ChrisPVille/quokka/README.md

# quokka
Quokka 6502 Microprocessor Trainer

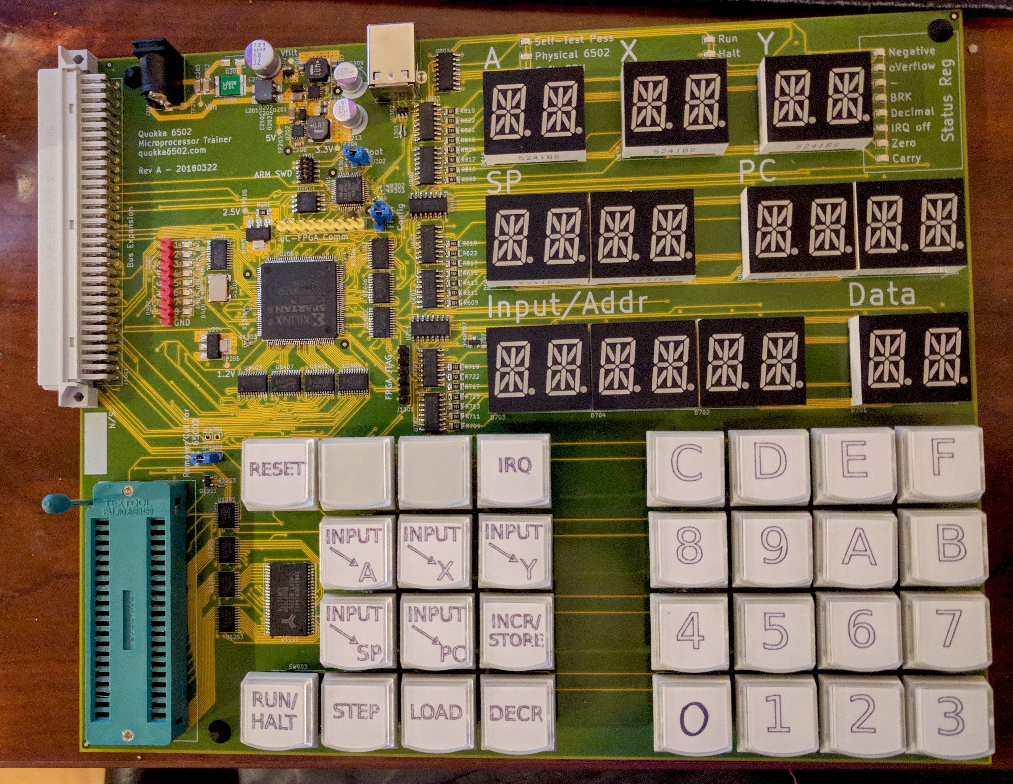
[picture p1: board.jpg]
Board Image
