ChrisPVille/quokka/board/quokka.pdf

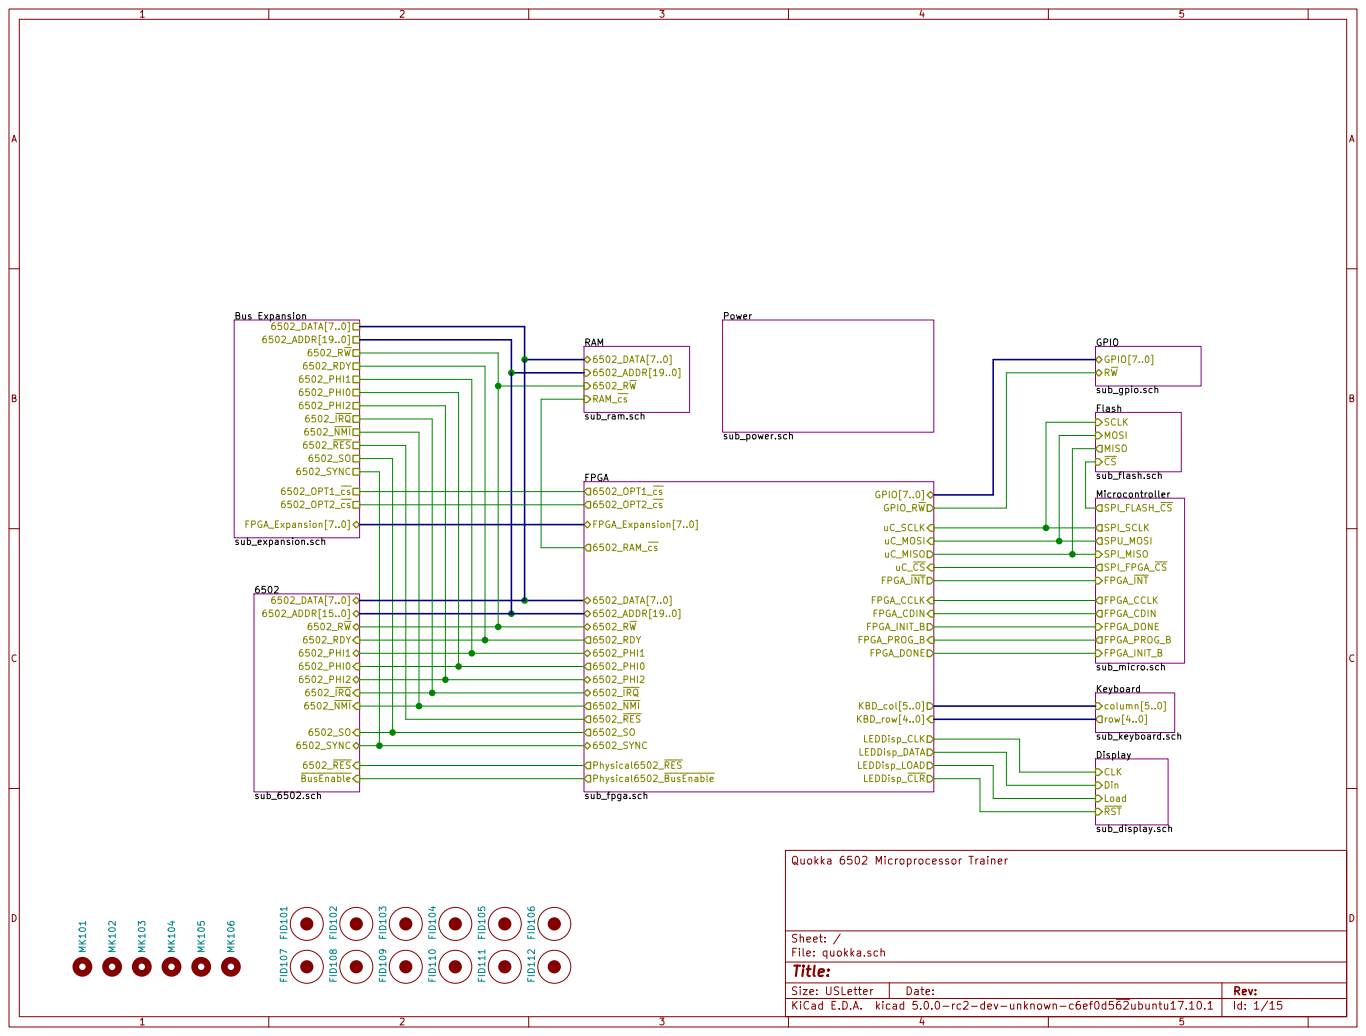
[picture p2: page 1]

Flash
sub_flash.sch SCLK MOSI MISO

File: quokka.sch Sheet: / Quokka 6502 Microprocessor Trainer

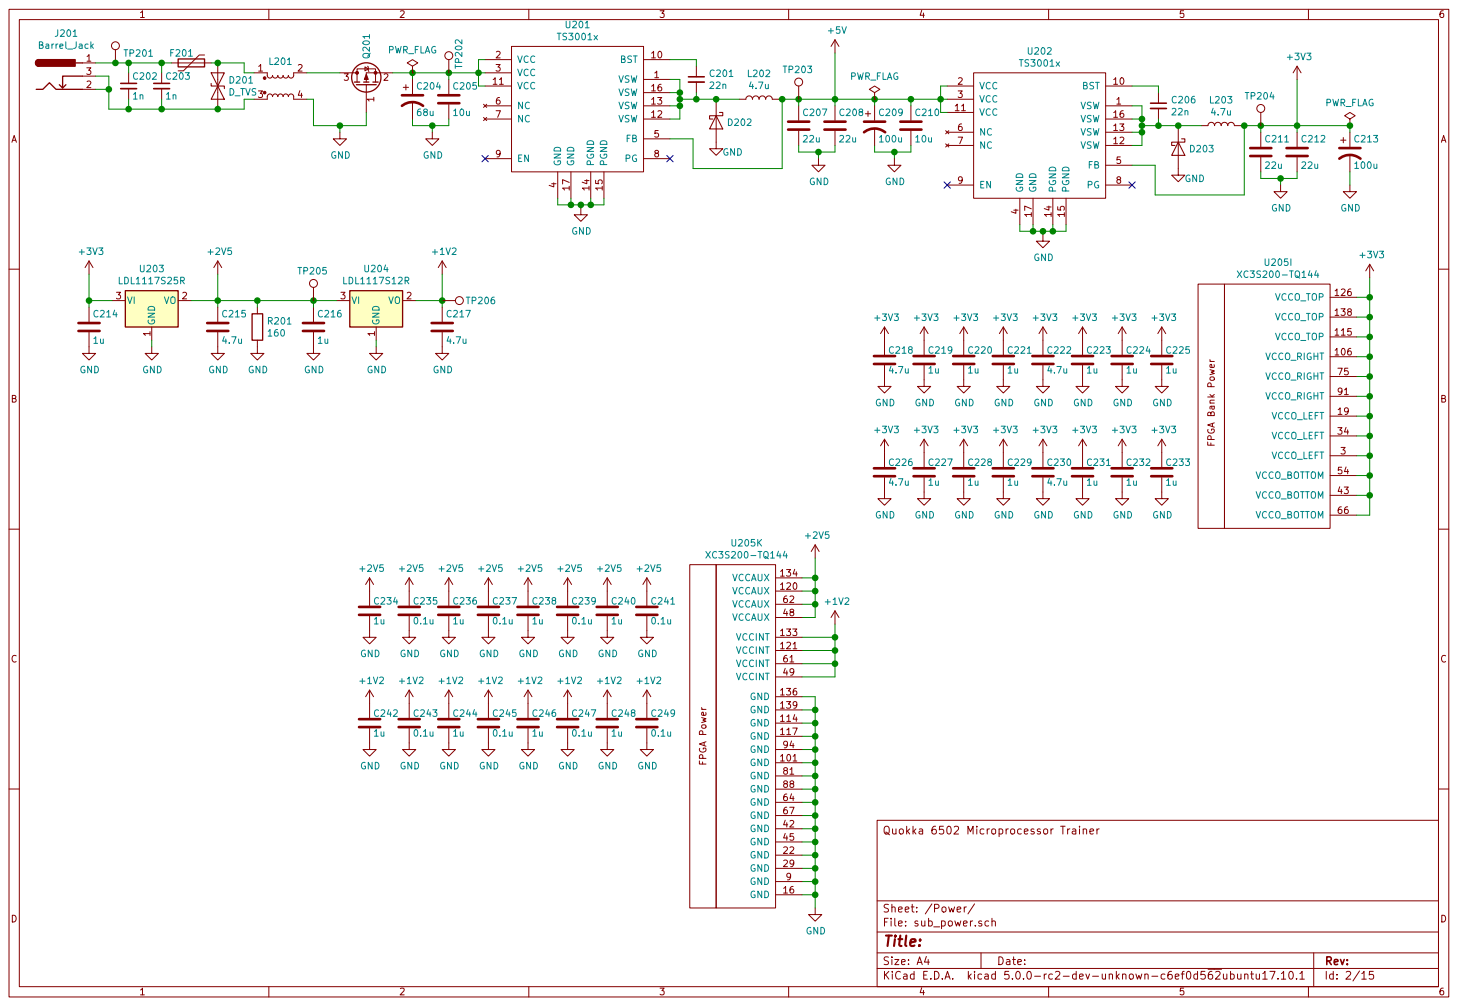
[picture p3: page 2]

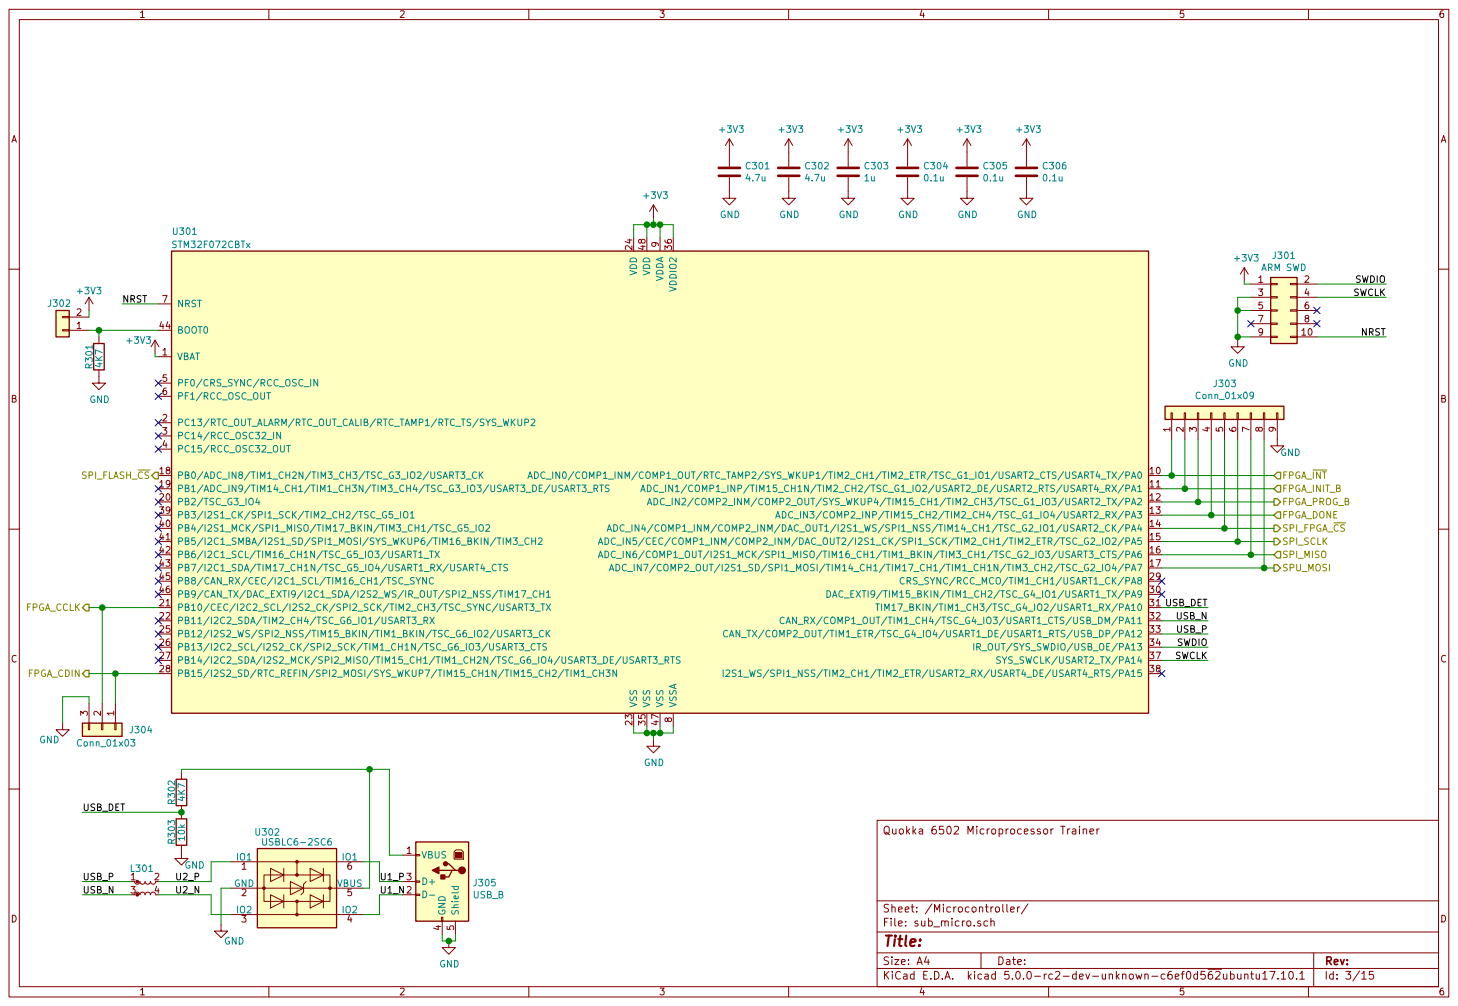
[picture p4: page 3]

9 VDDIO2 36 VSS 23 VSS 35 VSS 47 VSSA

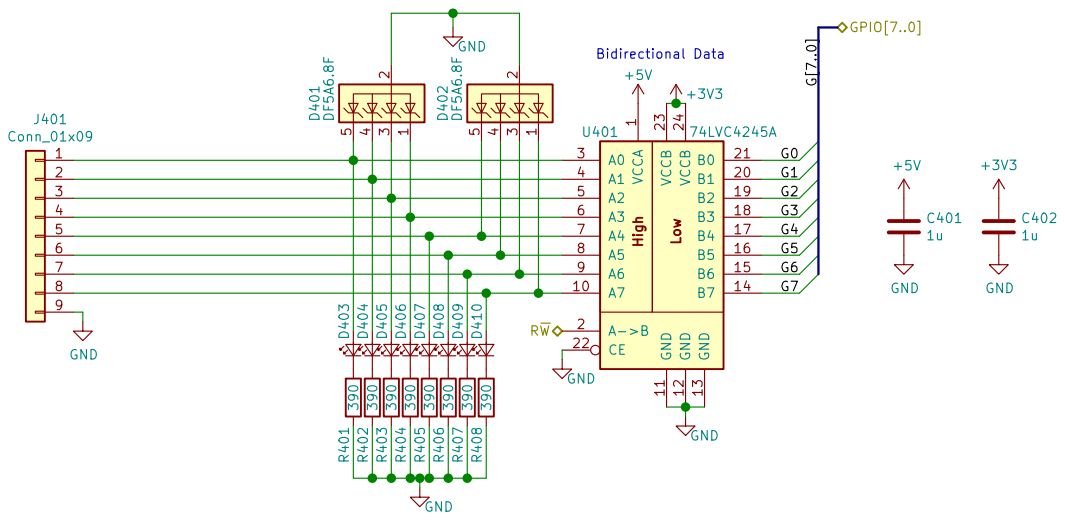
[picture p5: page 4]

1 A7 10 GND 11 GND 12 GND 13 B7 14 B6 15 B5 16 B4 17 B3 18 B2 19 A->B 2 B1 20 B0 21 CE 22 VCCB 23 VCCB 24 A0 3 A1 4 A2 5 A3 6 A4 7 A5 8 A6 9U401 74LVC4245A

File: sub_gpio.sch Sheet: /GPIO/ Quokka 6502 Microprocessor Trainer RW

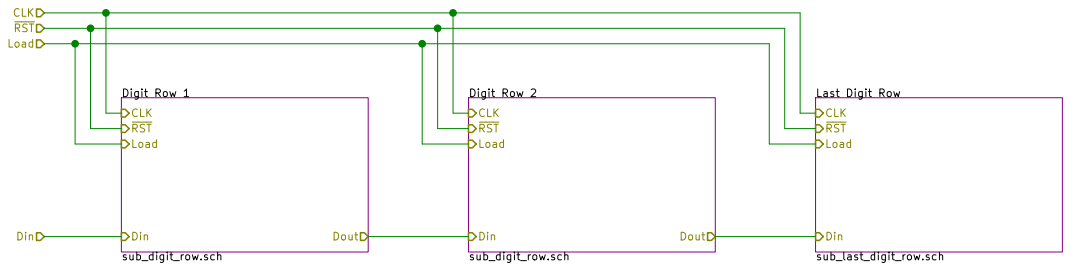
[picture p6: page 5]

Last Digit Row
sub_last_digit_row.sch Din CLK RST

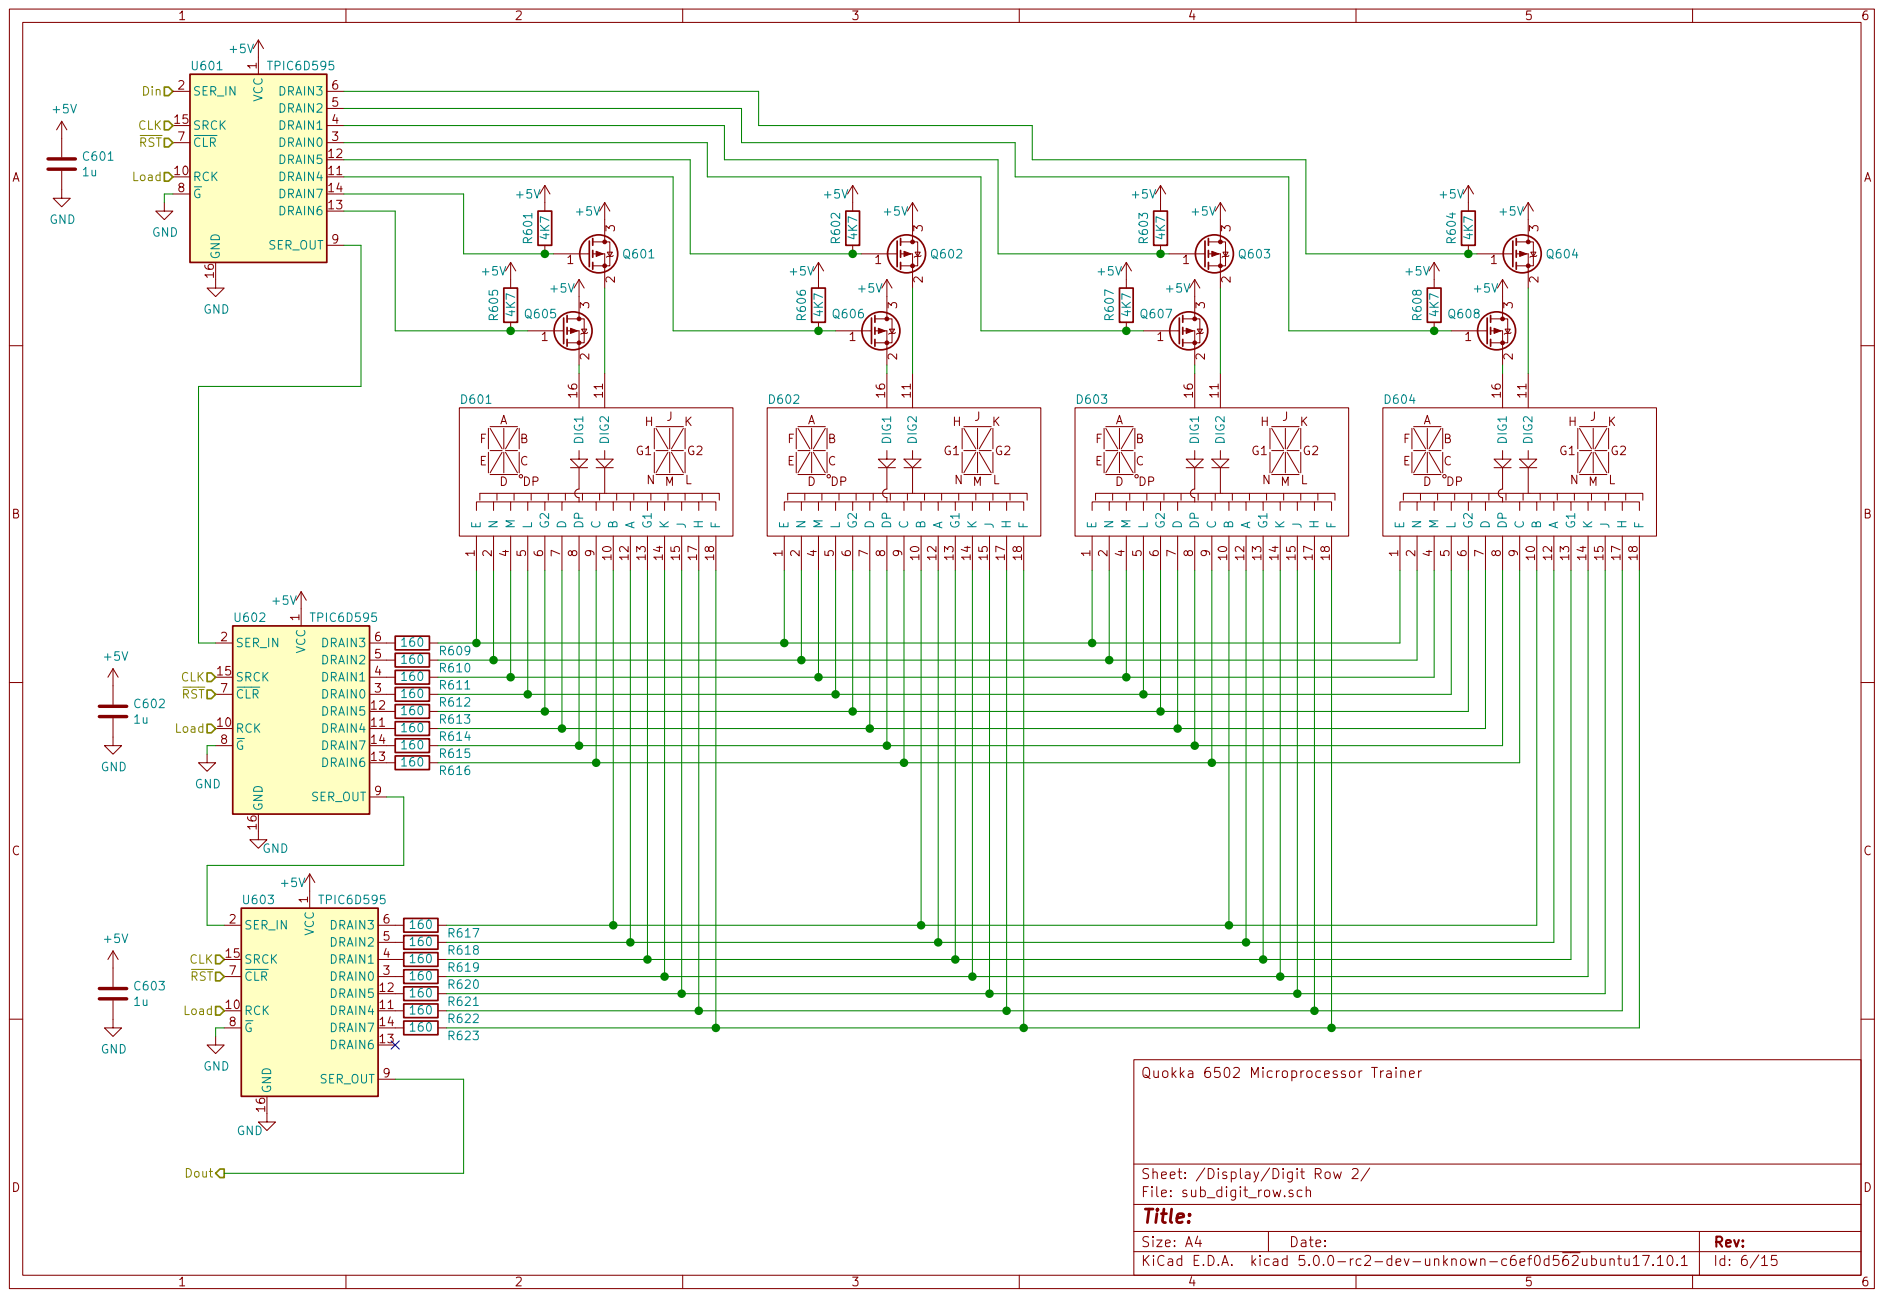
[picture p7: page 6]

1 RCK 10 DRAIN4 11 DRAIN5 12 DRAIN6 13 DRAIN7 14 SRCK 15 GND 16 SER_IN 2 DRAIN0 3 DRAIN1 4 DRAIN2 5 DRAIN3 6 CLR 7 G

Sheet: /Display/Digit Row 2/
File: sub_digit_row.sch
Id: 6/15 Title:

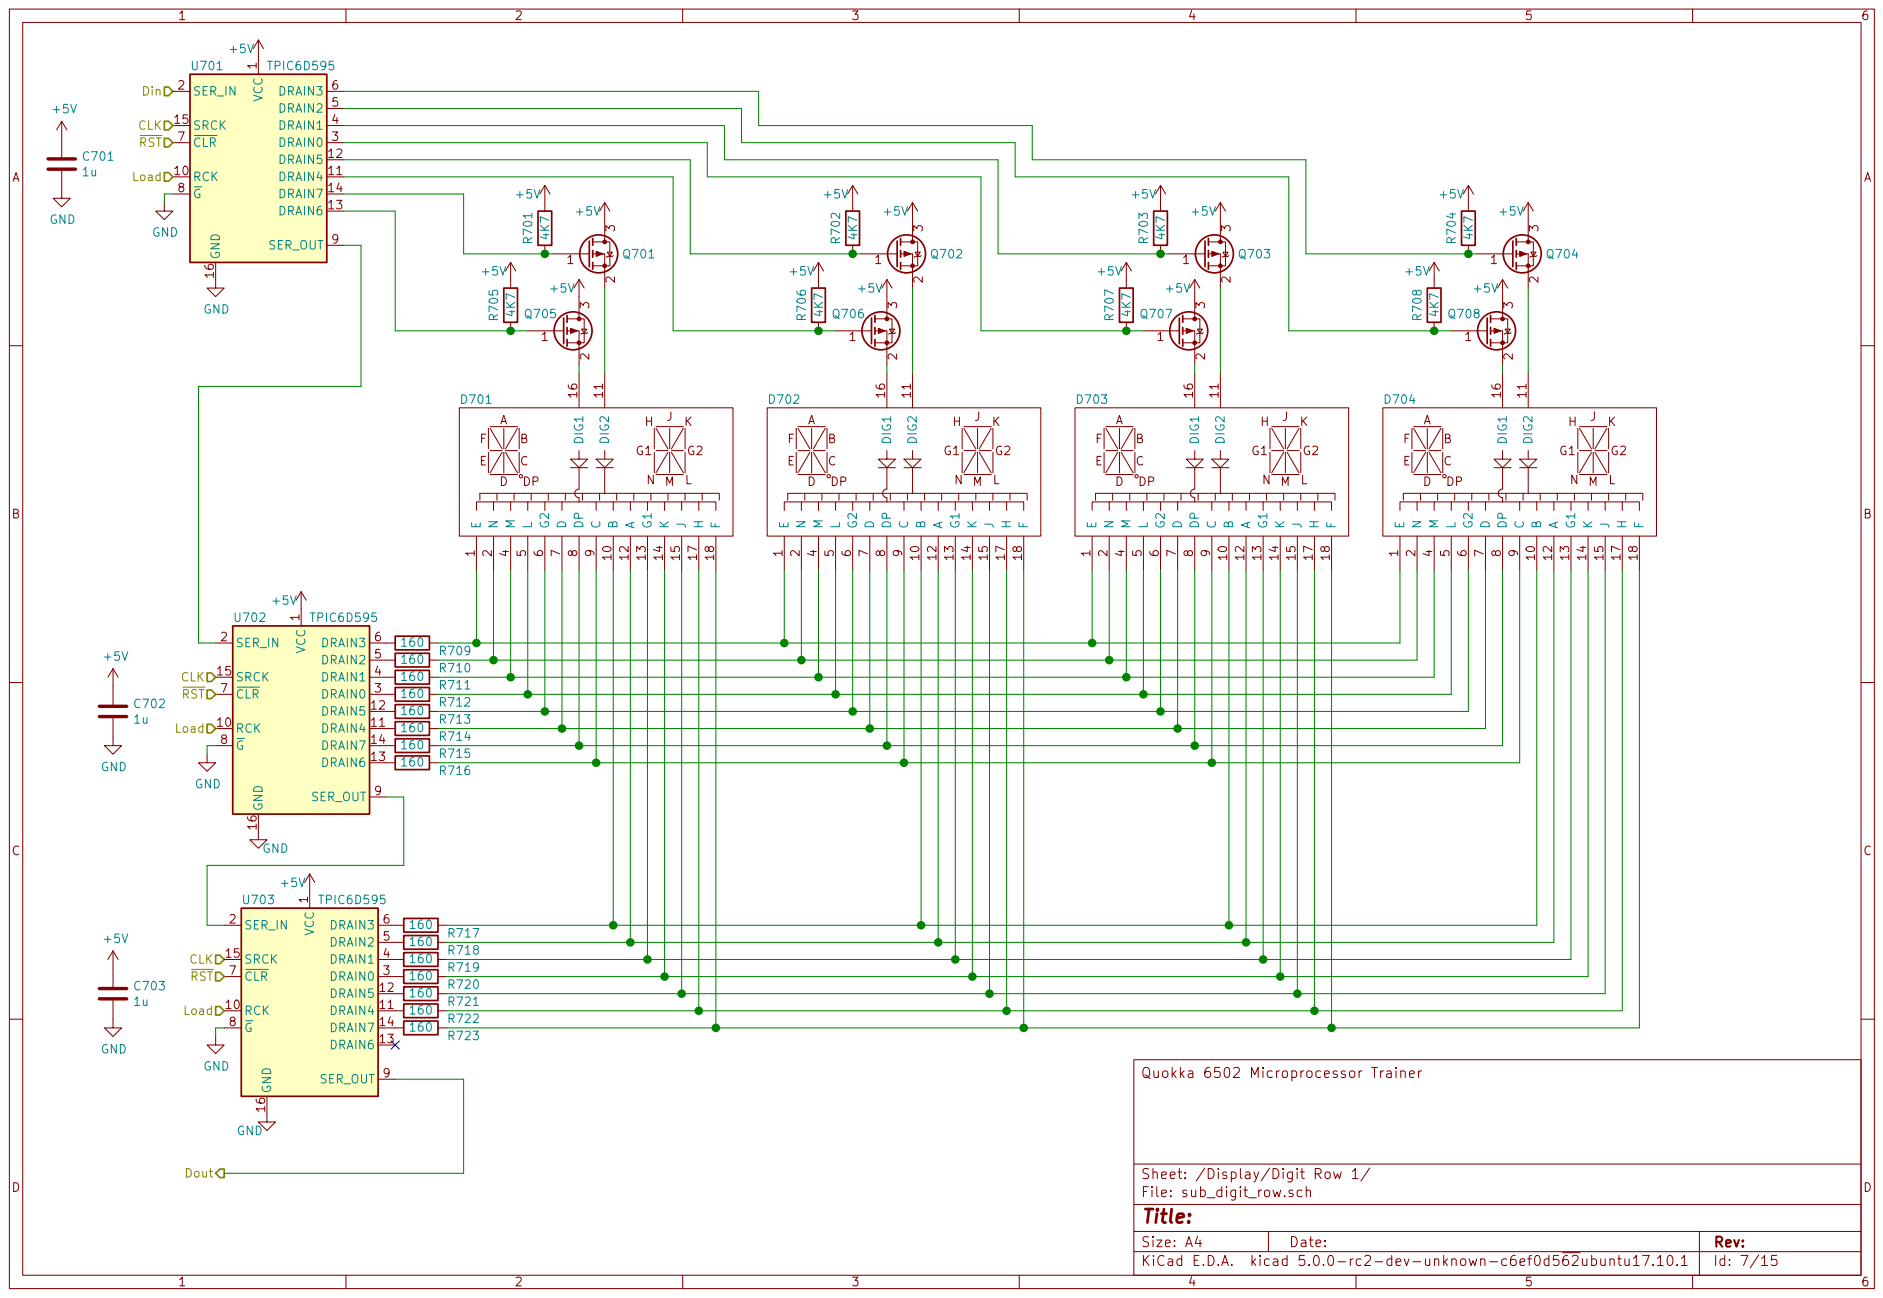
[picture p8: page 7]
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

Sheet: /Display/Digit Row 1/
File: sub_digit_row.sch
Id: 7/15 Title:

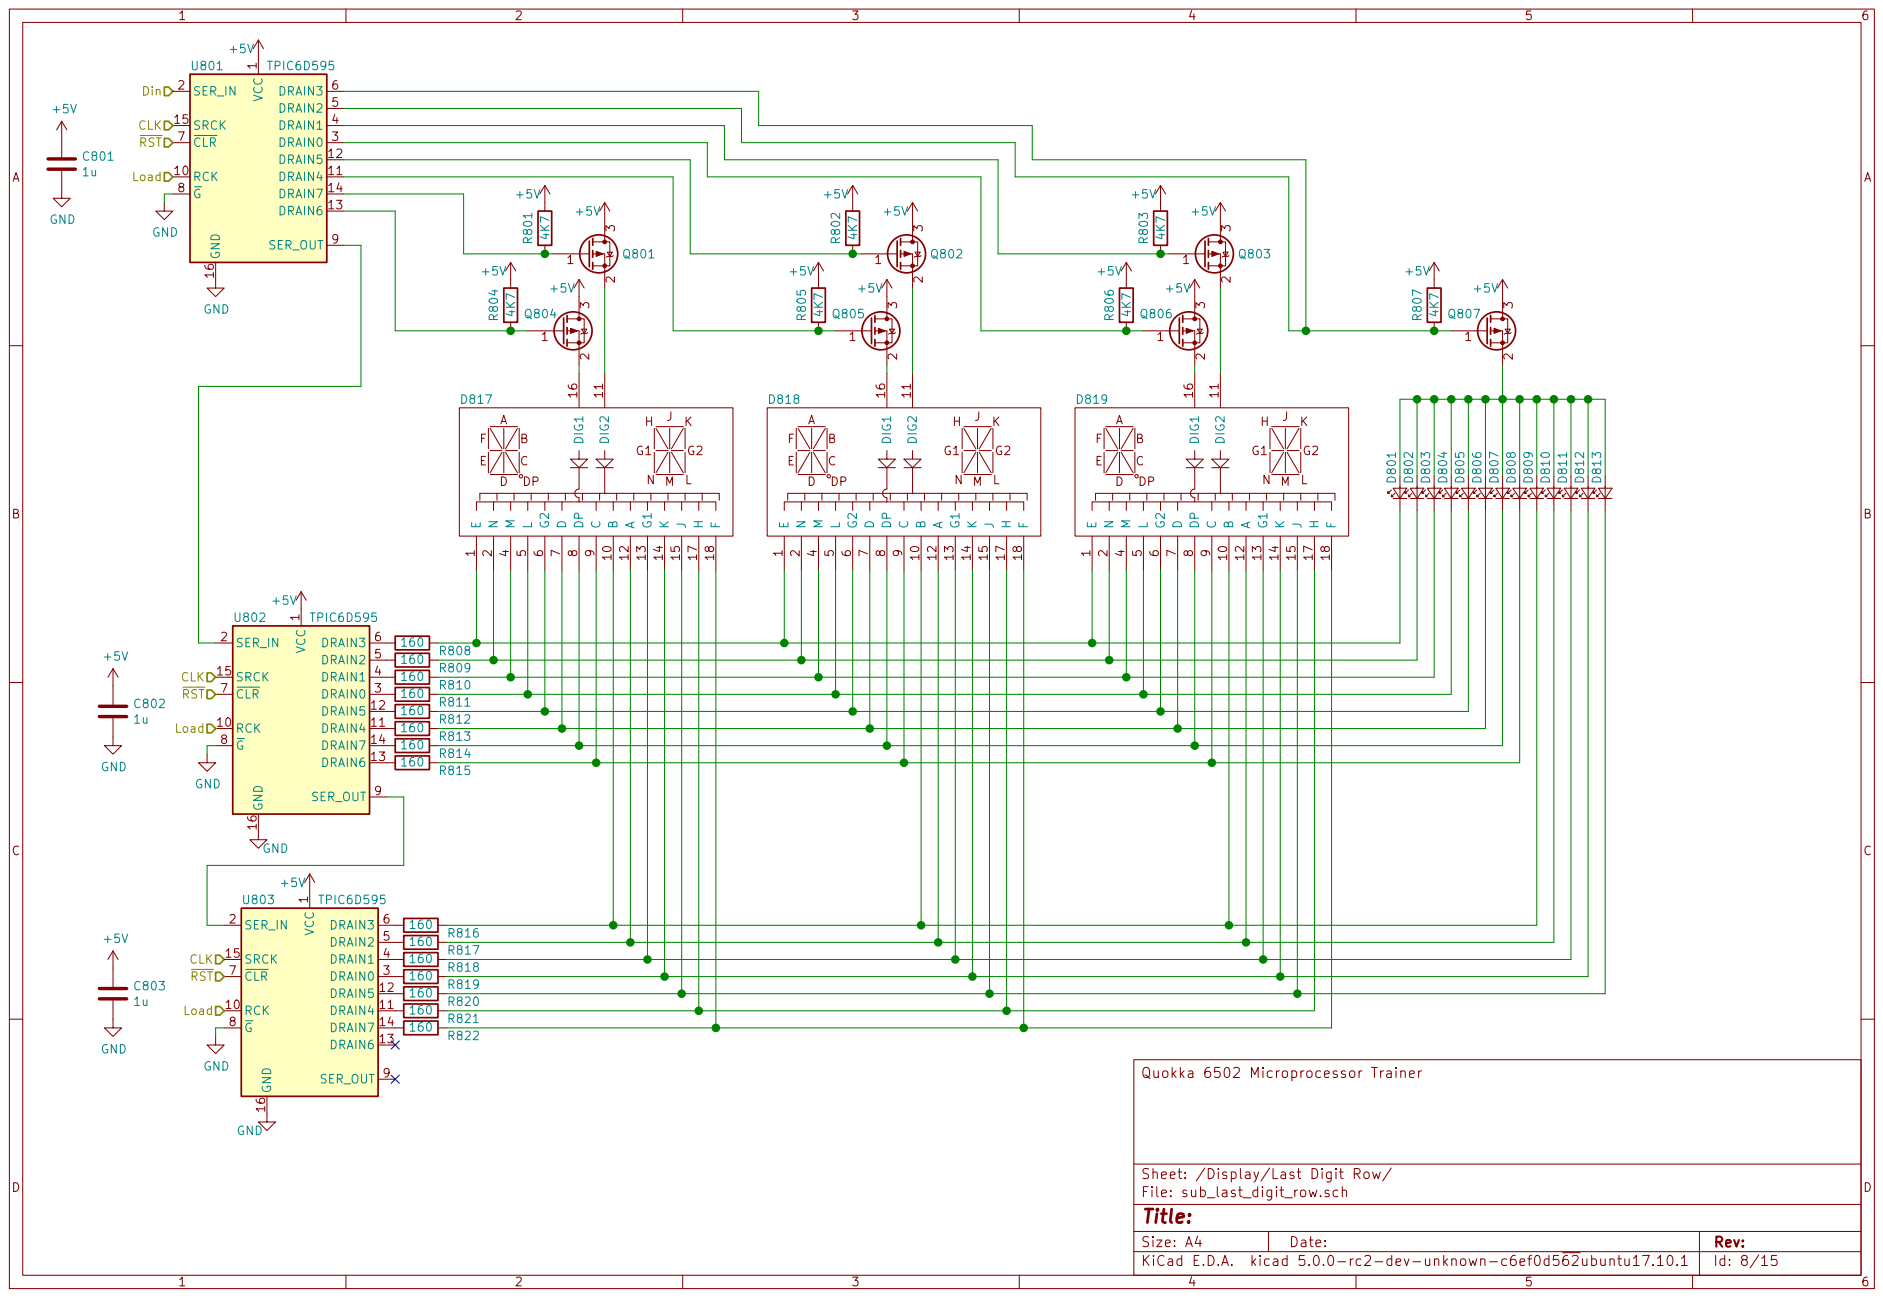
[picture p9: page 8]
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

Sheet: /Display/Last Digit Row/
File: sub_last_digit_row.sch
Id: 8/15 Title:

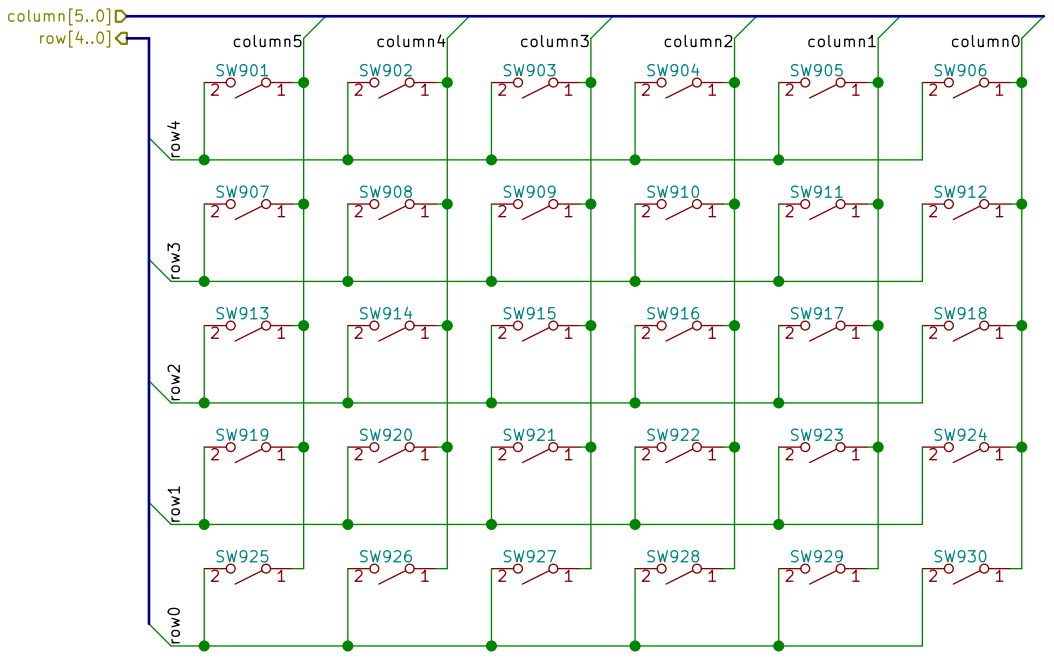
[picture p10: page 9]

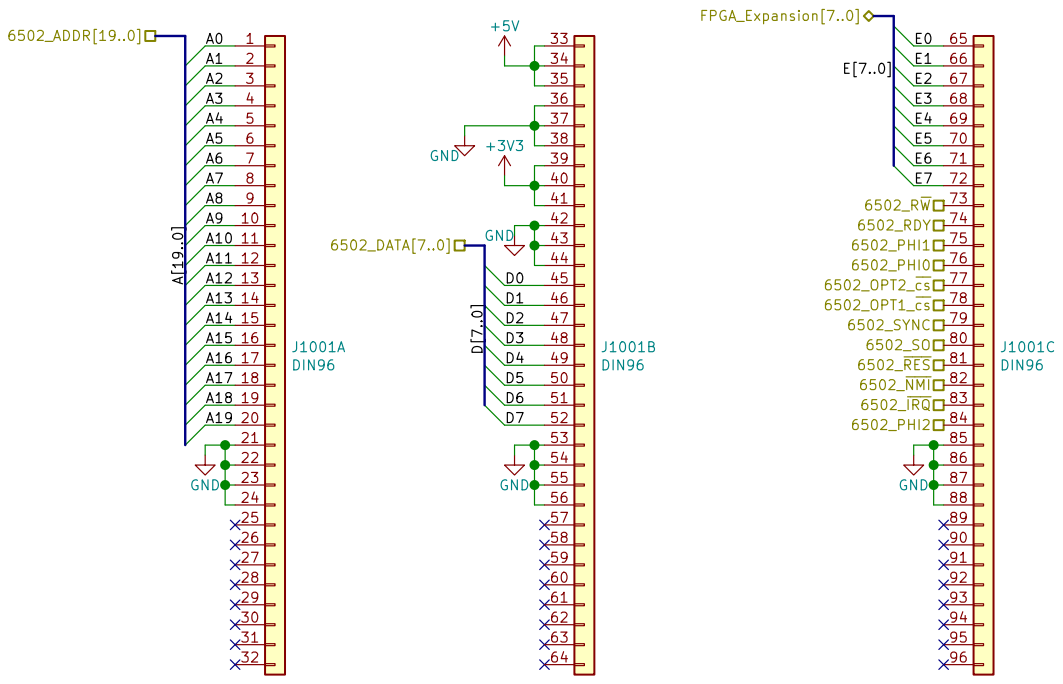
[picture p11: page 10]

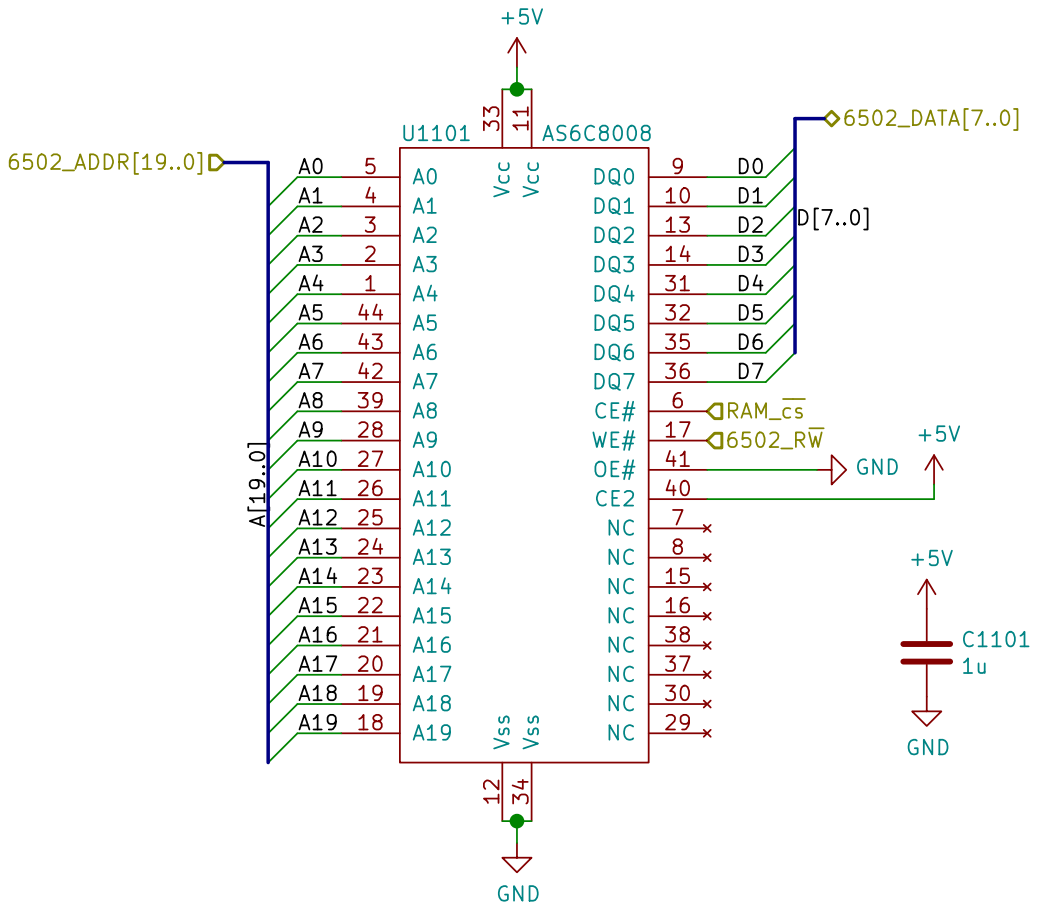
[picture p12: page 11]

File: sub_ram.sch Sheet: /RAM/ Quokka 6502 Microprocessor Trainer

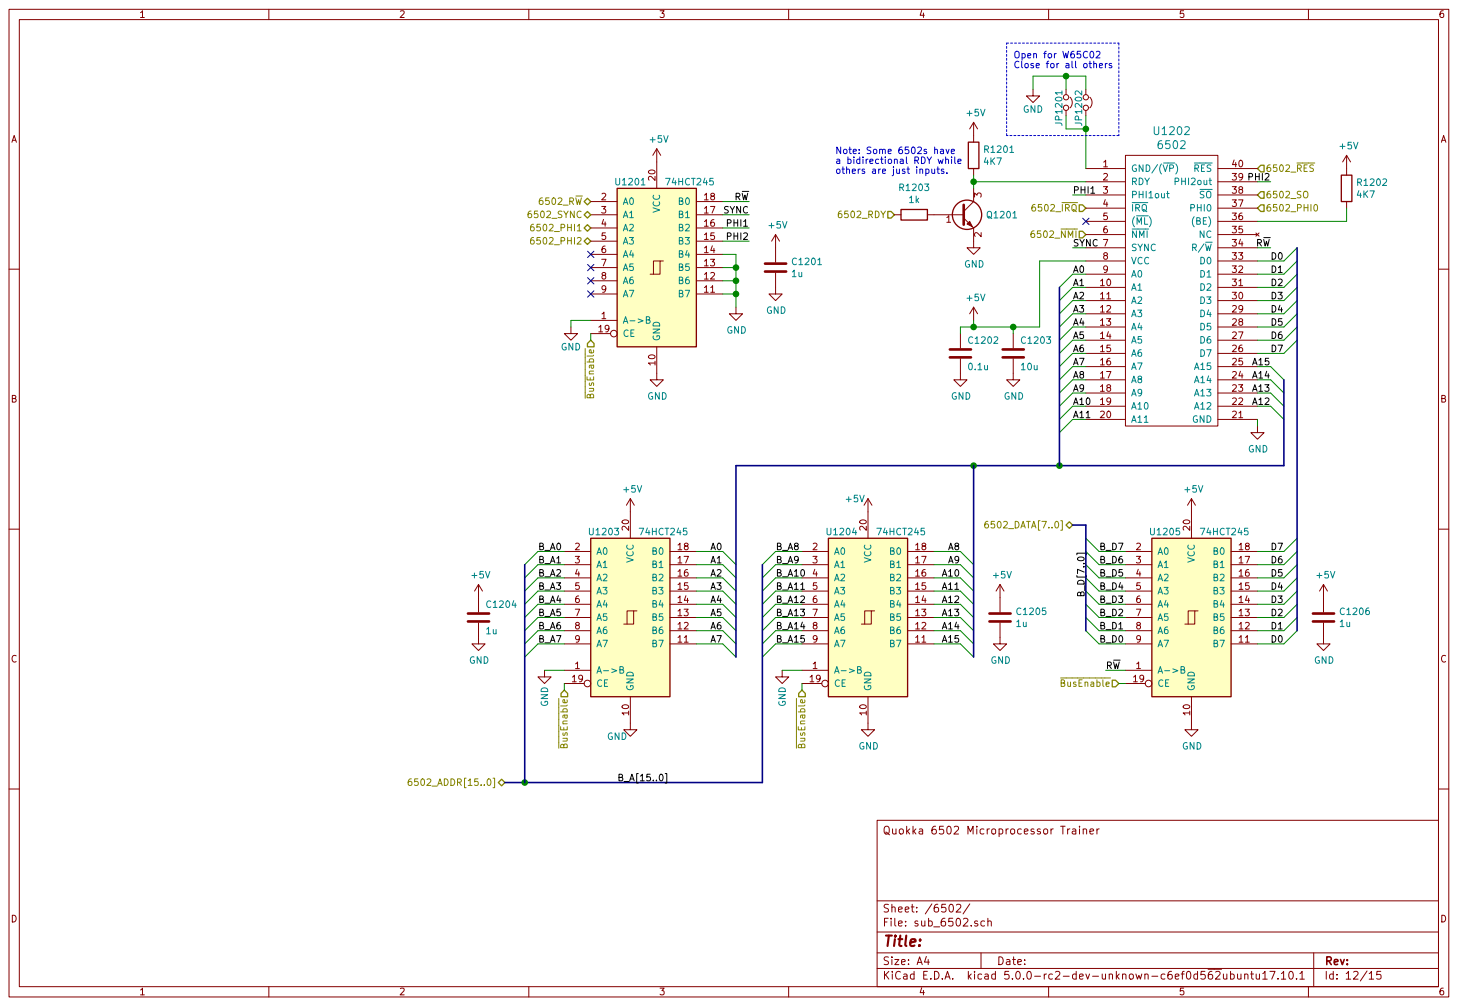
[picture p13: page 12]

4K7 Open for W65C02 Close for all others Note: Some 6502s have
4K7 GND

File: sub_6502.sch Sheet: /6502/ Quokka 6502 Microprocessor Trainer

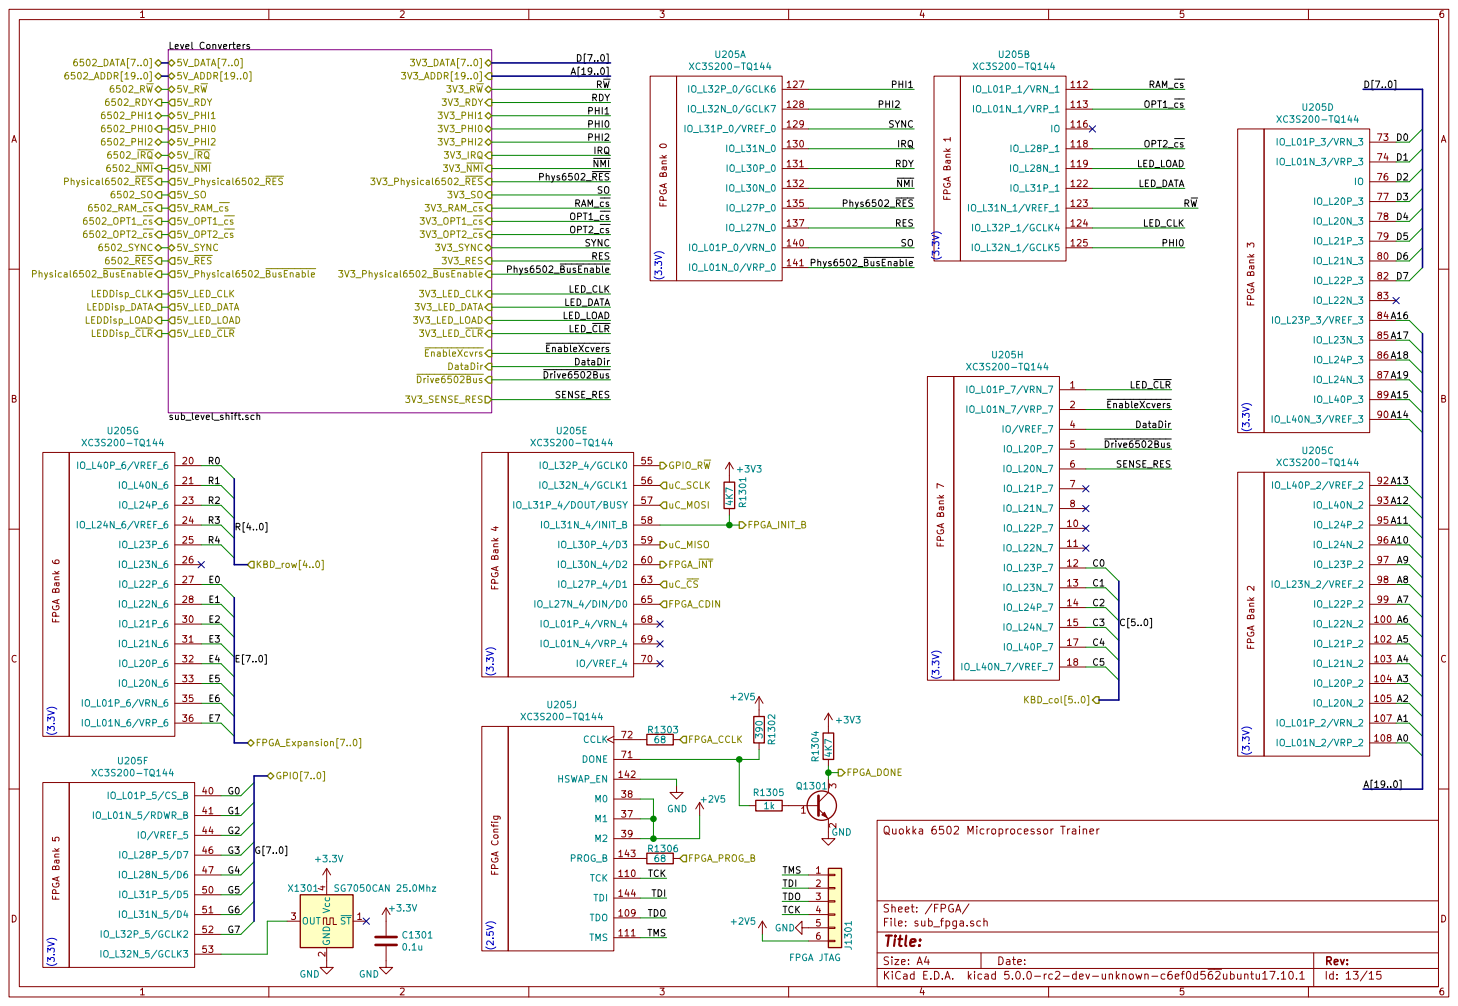
[picture p14: page 13]

TMS GND +2V5 FPGA Bank 6

File: sub_fpga.sch Sheet: /FPGA/ Quokka 6502 Microprocessor Trainer

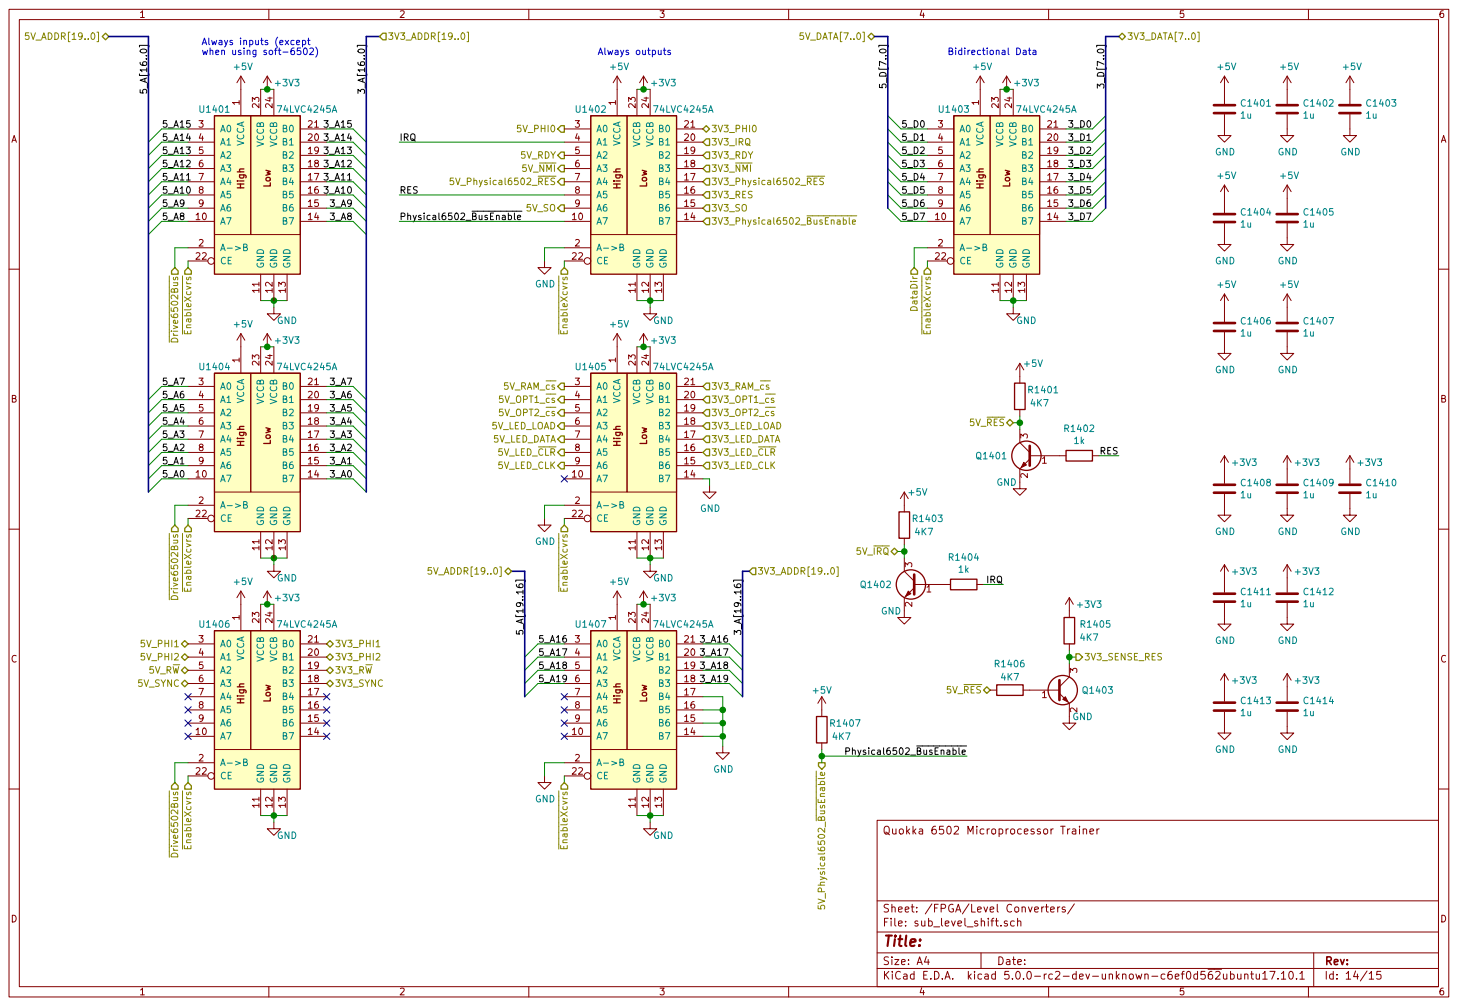
[picture p15: page 14]

1 A7 10 GND 11 GND 12 GND 13 B7 14 B6 15 B5 16 B4 17 B3 18 B2 19 A->B 2 B1 20 B0 21 CE 22 VCCB 23 VCCB 24 A0 3 A1 4 A2 5 A3 6 A4 7 A5 8 A6 9U1401 74LVC4245A High Low VCCA

1 A7 10 GND 11 GND 12 GND 13 B7 14 B6 15 B5 16 B4 17 B3 18 B2 19 A->B 2 B1 20 B0 21 CE 22 VCCB 23 VCCB 24 A0 3 A1 4 A2 5 A3 6 A4 7 A5 8 A6 9U1402 74LVC4245A

1 A7 10 GND 11 GND 12 GND 13 B7 14 B6 15 B5 16 B4 17 B3 18 B2 19 A->B 2 B1 20 B0 21 CE 22 VCCB 23 VCCB 24 A0 3 A1 4 A2 5 A3 6 A4 7 A5 8 A6 9U1403 74LVC4245A

1 A7 10 GND 11 GND 12 GND 13 B7 14 B6 15 B5 16 B4 17 B3 18 B2 19 A->B 2 B1 20 B0 21 CE 22 VCCB 23 VCCB 24 A0 3 A1 4 A2 5 A3 6 A4 7 A5 8 A6 9U1405 74LVC4245A GND GND

1 A7 10 GND 11 GND 12 GND 13 B7 14 B6 15 B5 16 B4 17 B3 18 B2 19 A->B 2 B1 20 B0 21 CE 22 VCCB 23 VCCB 24 A0 3 A1 4 A2 5 A3 6 A4 7 A5 8 A6 9U1404 74LVC4245A GND

1 A7 10 GND 11 GND 12 GND 13 B7 14 B6 15 B5 16 B4 17 B3 18 B2 19 A->B 2 B1 20 B0 21 CE 22 VCCB 23 VCCB 24 A0 3 A1 4 A2 5 A3 6 A4 7 A5 8 A6 9U1406 74LVC4245A GND

1 A7 10 GND 11 GND 12 GND 13 B7 14 B6 15 B5 16 B4 17 B3 18 B2 19 A->B 2 B1 20 B0 21 CE 22 VCCB 23 VCCB 24 A0 3 A1 4 A2 5 A3 6 A4 7 A5 8 A6 9U1407 74LVC4245A GND

File: sub_level_shift.sch Sheet: /FPGA/Level Converters/ Quokka 6502 Microprocessor Trainer

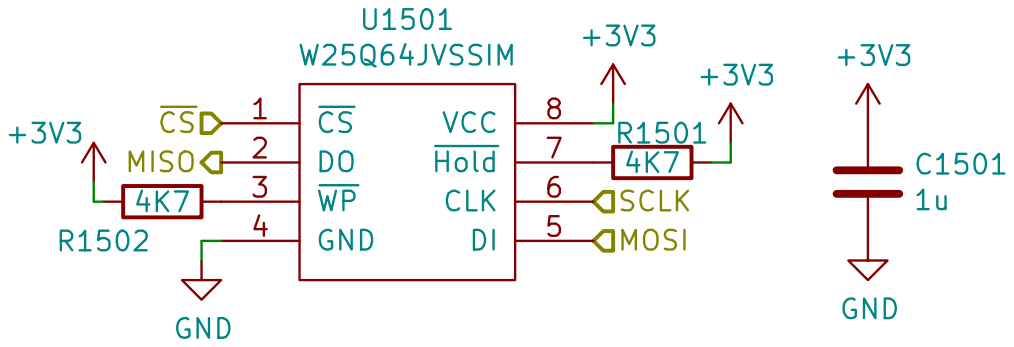
[picture p16: page 15]

File: sub_flash.sch Sheet: /Flash/ SCLK MOSI MISO
