ChrisPVille/quokka/board/quokka.kicad_pcb

## KiCad design board/quokka.kicad_pcb (2018-04-09)

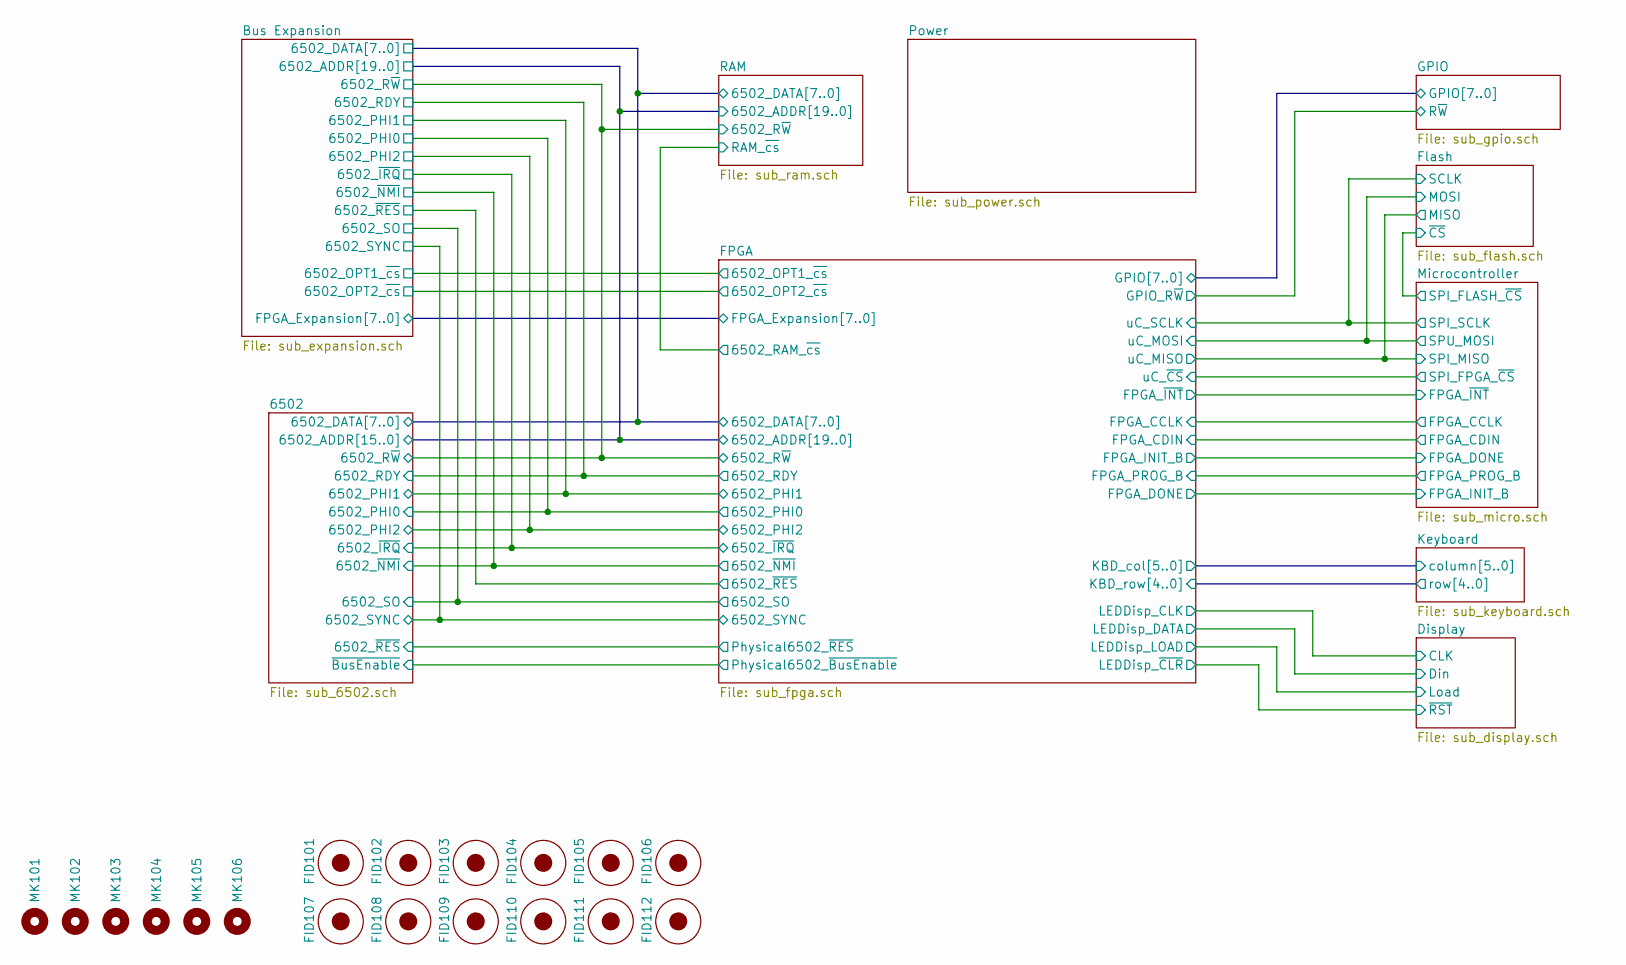
[picture p17: schematic quokka.sch]

Parts:
FID101, FID102, FID103, FID107, FID108, FID109, FID110, FID111, FID112: Fiducial; Fiducial_1mm_Dia_2.54mm_Outer_CopperTop
FID104, FID105, FID106: Fiducial; Fiducial_1mm_Dia_2.54mm_Outer_CopperBottom
MK101, MK102, MK103, MK104, MK105, MK106: Mounting_Hole; MountingHole_4.5mm

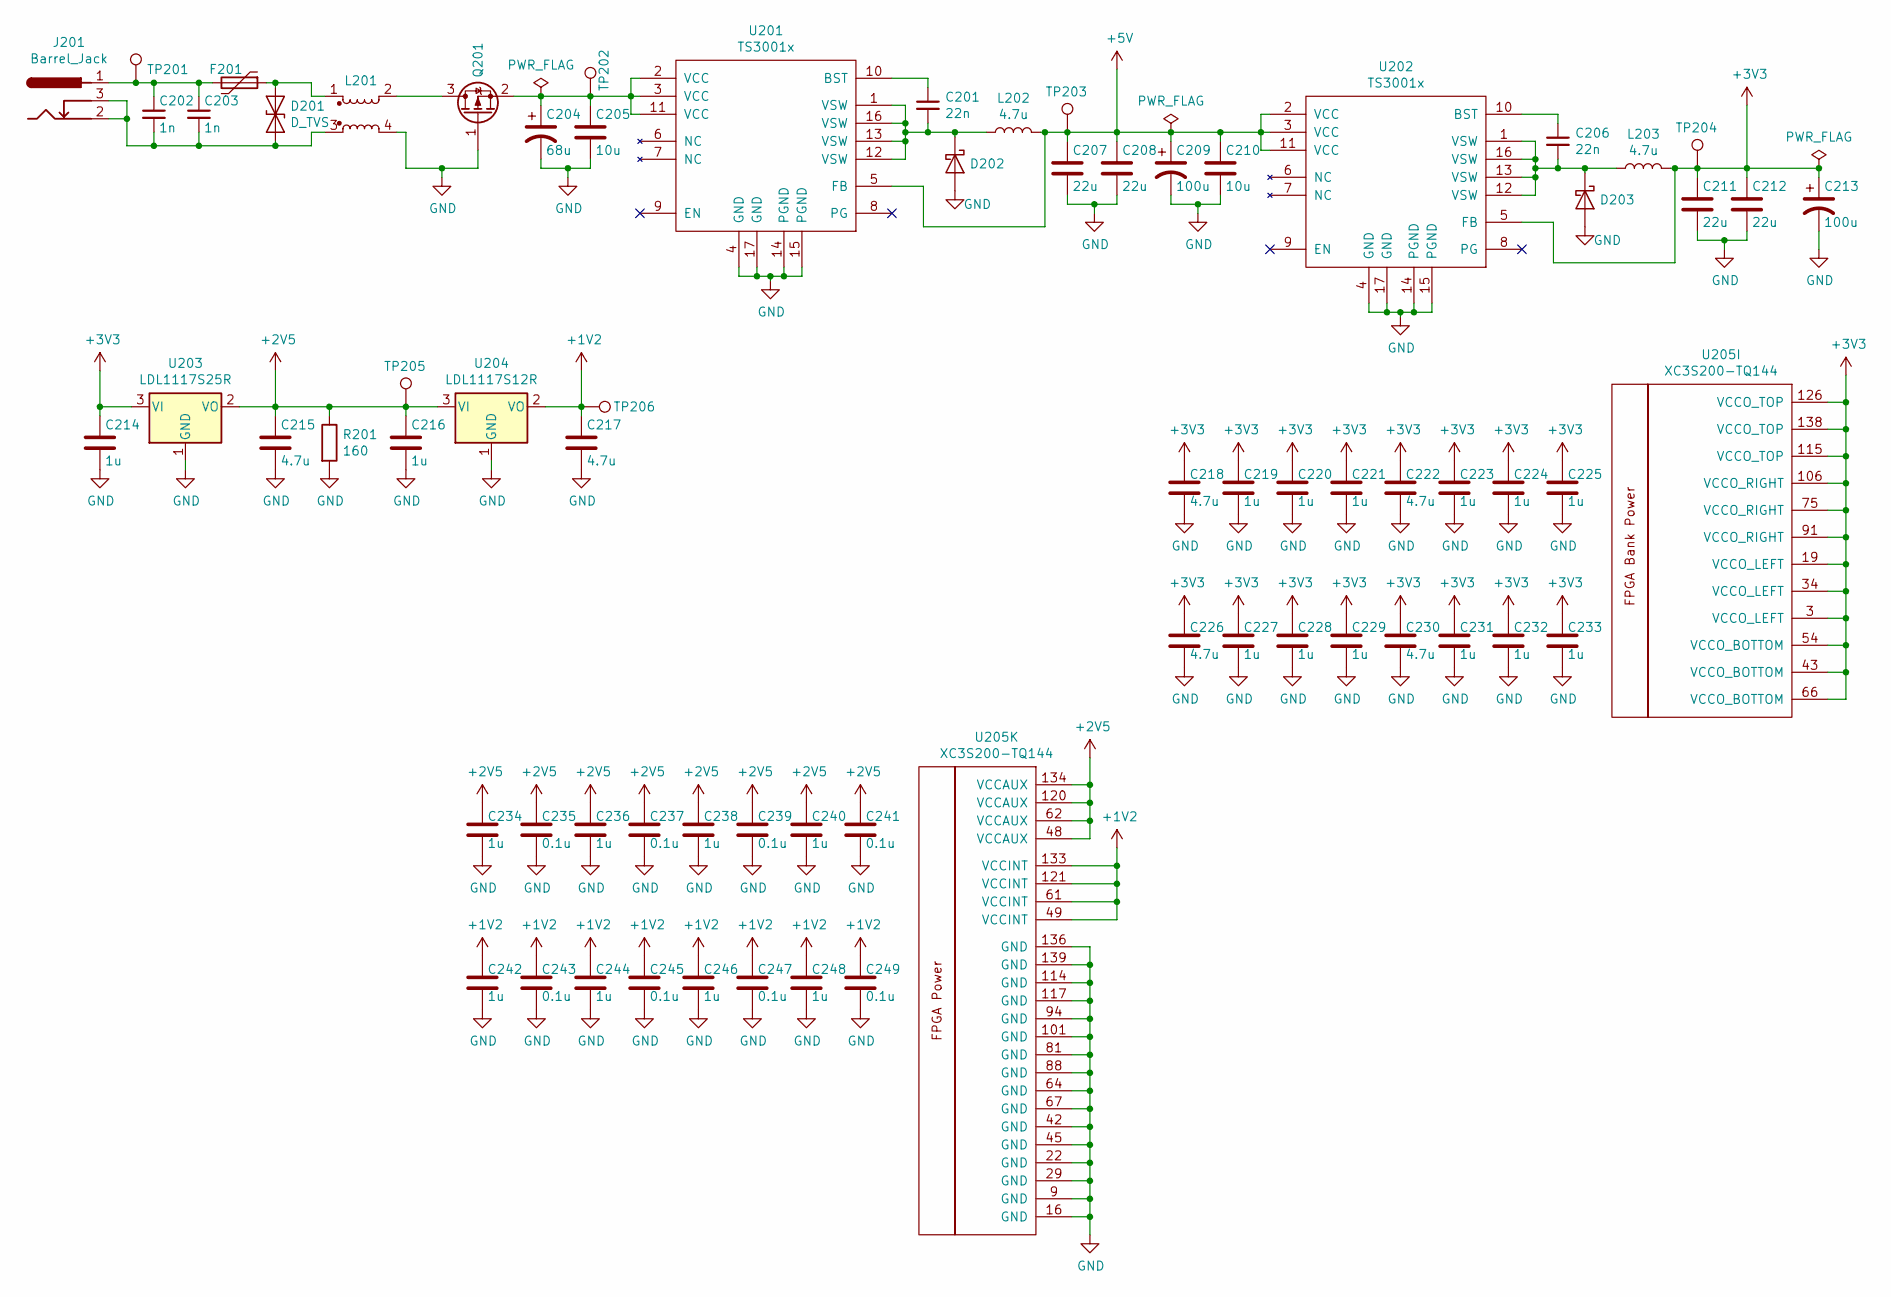
[picture p18: schematic sub_power.sch]

Parts:
C201, C206: 22n; C_0603_1608Metric
C202, C203: 1n; C_1206_3216Metric
C204: 68u; CP_Radial_D6.3mm_P2.50mm
C205, C210: 10u; C_1206_3216Metric
C207, C208, C211, C212: 22u; C_0805_2012Metric
C209, C213: 100u; CP_Radial_D8.0mm_P3.50mm
C214, C216, C219, C220, C221, C223, C224, C225, C227, C228, C229, C231, C232, C233, C234, C236, C238, C240, C242, C244, C246, C248: 1u; C_0603_1608Metric
C215, C217, C218, C222, C226, C230: 4.7u; C_0603_1608Metric
C235, C237, C239, C241, C243, C245, C247, C249: 0.1u; C_0603_1608Metric
D201: D_TVS; D_SMA
D202, D203: D_Schottky; D_SOD-123F
F201: Polyfuse; Fuse_2920_7451Metric
J201: Barrel_Jack; BarrelJack_CUI_PJ-102AH_Horizontal
L201: Power Choke; CM2021Y330R-10
L202, L203: 4.7u; L_Taiyo-Yuden_NR-60xx
Q201: Q_PMOS_GSD; SOT-23
R201: 160; R_1206_3216Metric
TP201, TP202, TP203, TP204, TP205, TP206: Test_Point; TestPoint_Pad_D1.5mm
U201, U202: TS3001x; UQFN-16-1EP_3x3mm_P0.5mm_EP1.75x1.75mm
U203: LDL1117S25R; SOT-223-3_TabPin2
U204: LDL1117S12R; SOT-223-3_TabPin2
U205: XC3S200-TQ144; LQFP-144_20x20mm_P0.5mm

Connections:
+1V2: C217.1, C242.1, C243.1, C244.1, C245.1, C246.1, C247.1, C248.1, C249.1, TP206.1, U204.2 (VO), U205.49 (VCCINT), U205.61 (VCCINT), U205.121 (VCCINT), U205.133 (VCCINT)
+2V5: C215.1, C216.1, C234.1, C235.1, C236.1, C237.1, C238.1, C239.1, C240.1, C241.1, R201.1, TP205.1, U203.2 (VO), U204.3 (VI), U205.48 (VCCAUX), U205.62 (VCCAUX), U205.120 (VCCAUX), U205.134 (VCCAUX); also elsewhere on the board
+5V: C207.1, C208.1, C209.1, C210.1, L202.2, TP203.1, U201.5 (FB), U202.2 (VCC), U202.3 (VCC), U202.11 (VCC); also elsewhere on the board
GND: C204.2, C205.2, C207.2, C208.2, C209.2, C210.2, C211.2, C212.2, C213.2, C214.2, C215.2, C216.2, C217.2, C218.2, C219.2, C220.2, C221.2, C222.2, C223.2, C224.2, C225.2, C226.2, C227.2, C228.2, C229.2, C230.2, C231.2, C232.2, C233.2, C234.2, C235.2, C236.2, C237.2, C238.2, C239.2, C240.2, C241.2, C242.2, C243.2, C244.2, C245.2, C246.2, C247.2, C248.2, C249.2, D202.2 (A), D203.2 (A), L201.4, Q201.1 (G), R201.2, U201.4 (GND), U201.14 (PGND), U201.15 (PGND), U201.17 (GND), U202.4 (GND), U202.14 (PGND), U202.15 (PGND), U202.17 (GND), U203.1 (GND), U204.1 (GND), U205.9 (GND), U205.16 (GND), U205.22 (GND), U205.29 (GND), U205.42 (GND), U205.45 (GND), U205.64 (GND), U205.67 (GND), U205.81 (GND), U205.88 (GND), U205.94 (GND), U205.101 (GND), U205.114 (GND), U205.117 (GND), U205.136 (GND), U205.139 (GND); also elsewhere on the board
unnamed: C201.1, U201.10 (BST)
unnamed: C201.2, D202.1 (K), L202.1, U201.1 (VSW), U201.12 (VSW), U201.13 (VSW), U201.16 (VSW)
unnamed: C202.1, C203.1, F201.2, J201.1, TP201.1
unnamed: C202.2, C203.2, D201.2 (A2), J201.2, J201.3, L201.3
unnamed: C204.1, C205.1, Q201.2 (S), TP202.1, U201.2 (VCC), U201.3 (VCC), U201.11 (VCC)
unnamed: C206.1, U202.10 (BST)
unnamed: C206.2, D203.1 (K), L203.1, U202.1 (VSW), U202.12 (VSW), U202.13 (VSW), U202.16 (VSW)
unnamed: D201.1 (A1), F201.1, L201.1
unnamed: L201.2, Q201.3 (D)

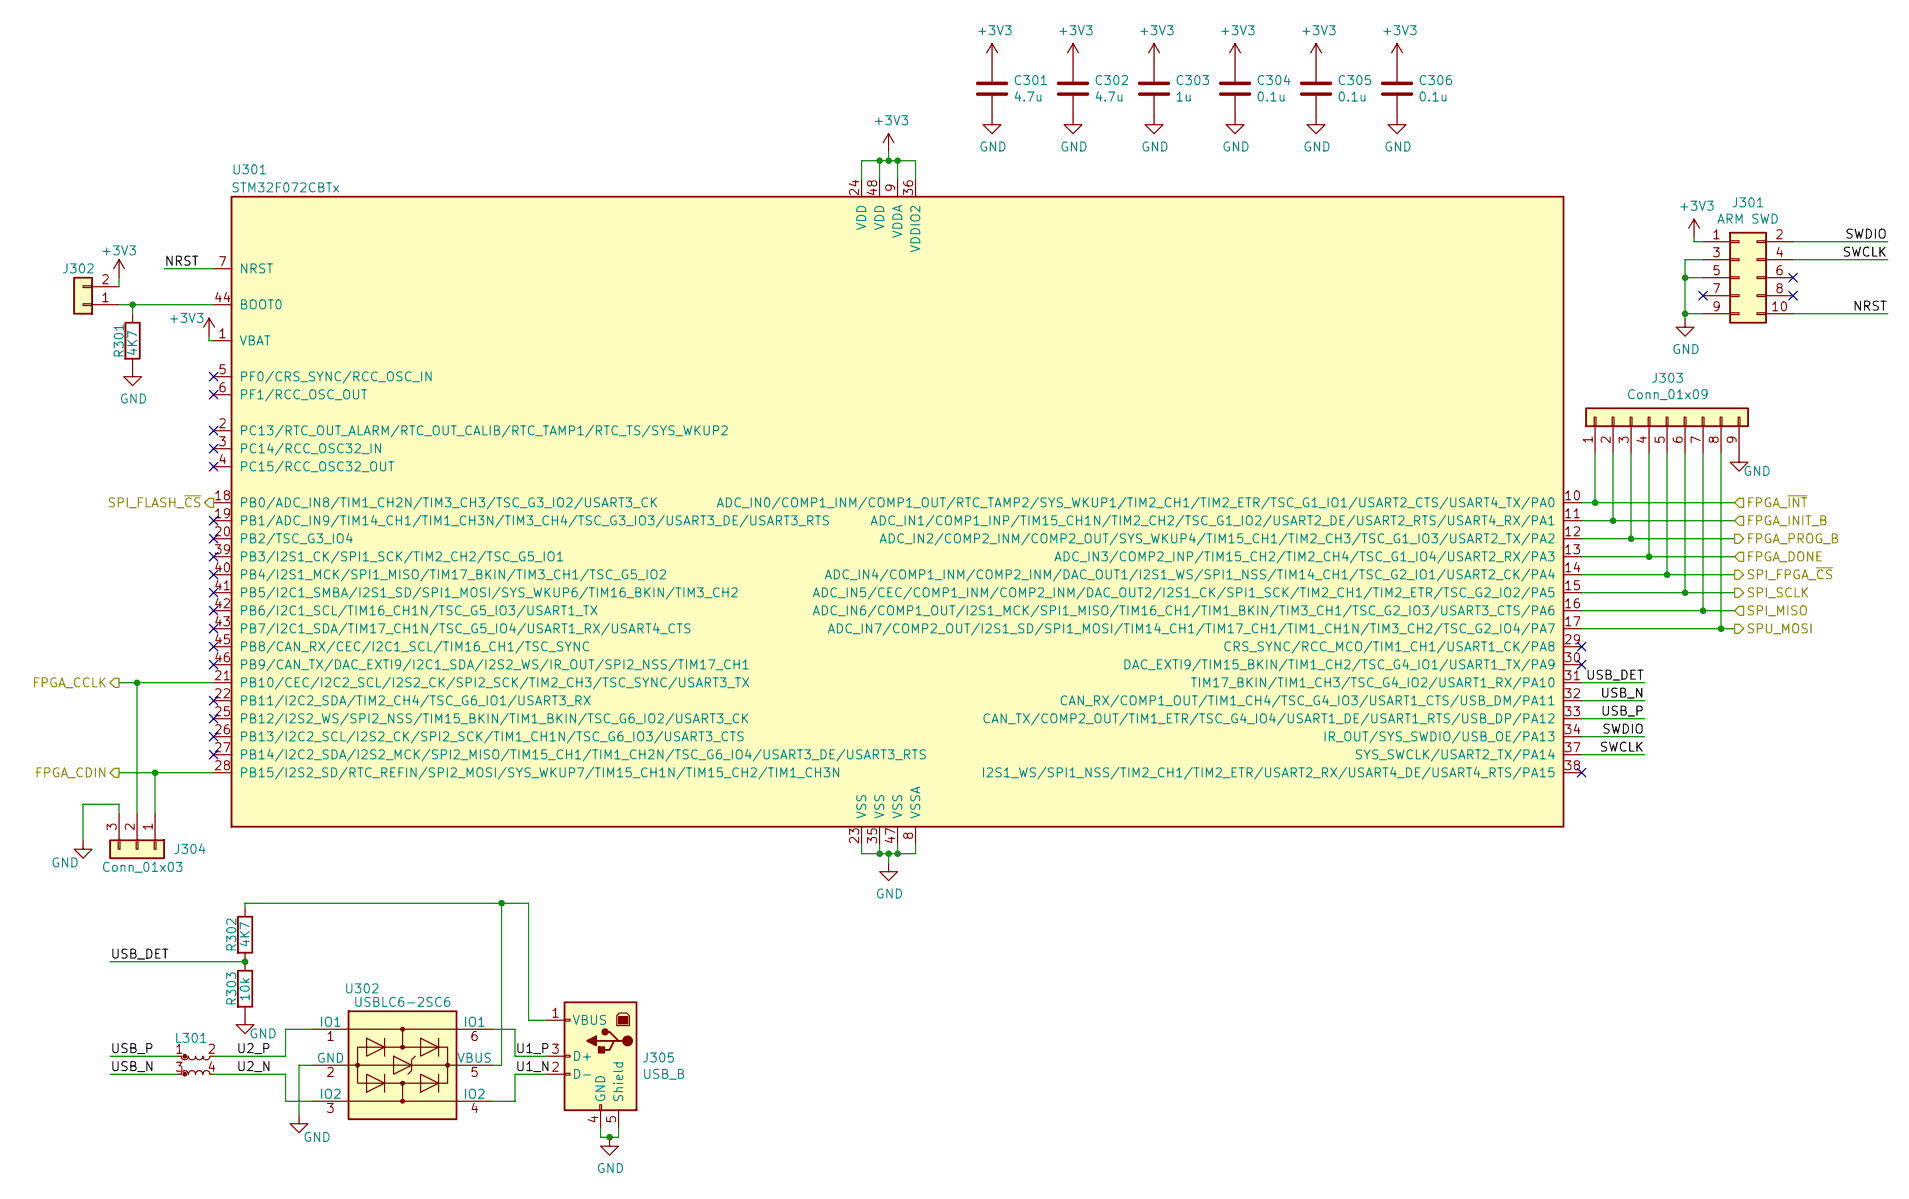
[picture p19: schematic sub_micro.sch]

Parts:
C301, C302: 4.7u; C_0603_1608Metric
C303: 1u; C_0603_1608Metric
C304, C305, C306: 0.1u; C_0603_1608Metric
J301: ARM SWD; PinHeader_2x05_P1.27mm_Vertical_SMD
J302: Conn_01x02; PinHeader_1x02_P2.54mm_Vertical
J303: Conn_01x09; PinHeader_1x09_P2.54mm_Vertical
J304: Conn_01x03; PinHeader_1x03_P2.54mm_Vertical
J305: USB_B; UE27BCX4
L301: USB Choke; DLW21H
R301, R302: 4K7; R_0603_1608Metric
R303: 10k; R_0603_1608Metric
U301: STM32F072CBTx; LQFP-48_7x7mm_P0.5mm
U302: USBLC6-2SC6; SOT-23-6

Connections:
/FPGA/FPGA_CCLK: J304.2, U301.21 (PB10/CEC/I2C2_SCL/I2S2_CK/SPI2_SCK/TIM2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); also elsewhere on the board
/FPGA/FPGA_CDIN: J304.1, U301.28 (PB15/I2S2_SD/RTC_REFIN/SPI2_MOSI/SYS_WK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); also elsewhere on the board
/FPGA/FPGA_DONE: J303.2, U301.11 (ADC_IN1/COMP1_INP/TIM15_CH1N/TIM2_CH2/T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); also elsewhere on the board
/FPGA/FPGA_PROG_B: J303.3, U301.12 (ADC_IN2/COMP2_INM/COMP2_OUT/SYS_WKUP4/T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); also elsewhere on the board
/FPGA/FPGA_~INT: J303.1, U301.10 (ADC_IN0/COMP1_INM/COMP1_OUT/RTC_TAMP2/S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); also elsewhere on the board
/Flash/MISO: J303.7, U301.16 (ADC_IN6/COMP1_OUT/I2S1_MCK/SPI1_MISO/TI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); also elsewhere on the board
/Flash/MOSI: J303.8, U301.17 (ADC_IN7/COMP2_OUT/I2S1_SD/SPI1_MOSI/TIM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); also elsewhere on the board
/Flash/SCLK: J303.6, U301.15 (ADC_IN5/CEC/COMP1_INM/COMP2_INM/DAC_OUT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); also elsewhere on the board
/Microcontroller/FPGA_DONE: J303.4, U301.13 (ADC_IN3/COMP2_INP/TIM15_CH2/TIM2_CH4/TS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); also elsewhere on the board
/Microcontroller/NRST: J301.10, U301.7 (NRST)
/Microcontroller/SPI_FLASH_~CS: U301.18 (PB0/ADC_IN8/TIM1_CH2N/TIM3_CH3/TSC_G3_I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); also elsewhere on the board
/Microcontroller/SPI_FPGA_~CS: J303.5, U301.14 (ADC_IN4/COMP1_INM/COMP2_INM/DAC_OUT1/I2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); also elsewhere on the board
/Microcontroller/SWCLK: J301.4, U301.37 (SYS_SWCLK/USART2_TX/PA14)
/Microcontroller/SWDIO: J301.2, U301.34 (IR_OUT/SYS_SWDIO/USB_OE/PA13)
/Microcontroller/U1_N: J305.2 (D-), U302.4 (IO2)
/Microcontroller/U1_P: J305.3 (D+), U302.6 (IO1)
/Microcontroller/U2_N: L301.4, U302.3 (IO2)
/Microcontroller/U2_P: L301.2, U302.1 (IO1)
/Microcontroller/USB_DET: R302.2, R303.1, U301.31 (TIM17_BKIN/TIM1_CH3/TSC_G4_IO2/USART1_R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)
/Microcontroller/USB_N: L301.3, U301.32 (CAN_RX/COMP1_OUT/TIM1_CH4/TSC_G4_IO3/US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)
/Microcontroller/USB_P: L301.1, U301.33 (CAN_TX/COMP2_OUT/TIM1_ETR/TSC_G4_IO4/US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)
GND: C301.2, C302.2, C303.2, C304.2, C305.2, C306.2, J301.3, J301.5, J301.9, J303.9, J304.3, J305.4 (GND), J305.5 (Shield), R301.2, R303.2, U301.8 (VSSA), U301.23 (VSS), U301.35 (VSS), U301.47 (VSS), U302.2 (GND); also elsewhere on the board
unnamed: J302.1, R301.1, U301.44 (BOOT0)
unnamed: J305.1 (VBUS), R302.1, U302.5 (VBUS)

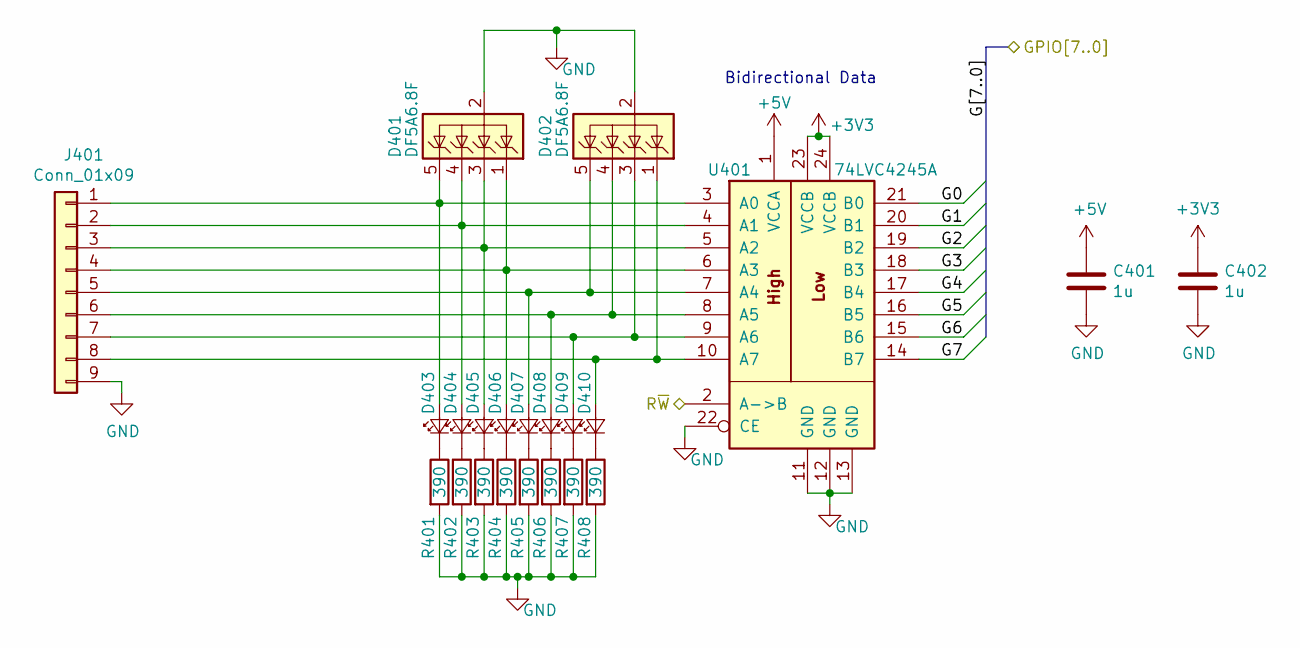
[picture p20: schematic sub_gpio.sch]

Parts:
C401, C402: 1u; C_0603_1608Metric
D401, D402: DF5A6.8F; SOT-353_SC-70-5
D403, D404, D405, D406, D407, D408, D409, D410: LED_Small; LED_0805_2012Metric
J401: Conn_01x09; PinHeader_1x09_P2.54mm_Vertical
R401, R402, R403, R404, R405, R406, R407, R408: 390; R_0603_1608Metric
U401: 74LVC4245A; TSSOP-24_4.4x7.8mm_P0.65mm

Connections:
+5V: C401.1, U401.1 (VCCA); also elsewhere on the board
/FPGA/G0: U401.21 (B0); also elsewhere on the board
/FPGA/G1: U401.20 (B1); also elsewhere on the board
/FPGA/G2: U401.19 (B2); also elsewhere on the board
/FPGA/G3: U401.18 (B3); also elsewhere on the board
/FPGA/G4: U401.17 (B4); also elsewhere on the board
/FPGA/G5: U401.16 (B5); also elsewhere on the board
/FPGA/G6: U401.15 (B6); also elsewhere on the board
/FPGA/G7: U401.14 (B7); also elsewhere on the board
/FPGA/GPIO_R~W: U401.2 (A->B); also elsewhere on the board
GND: C401.2, C402.2, D401.2 (A), D402.2 (A), J401.9, R401.2, R402.2, R403.2, R404.2, R405.2, R406.2, R407.2, R408.2, U401.11 (GND), U401.12 (GND), U401.13 (GND), U401.22 (CE); also elsewhere on the board
unnamed: D401.1 (K), D406.2 (A), J401.4, U401.6 (A3)
unnamed: D401.3 (K), D405.2 (A), J401.3, U401.5 (A2)
unnamed: D401.4 (K), D404.2 (A), J401.2, U401.4 (A1)
unnamed: D401.5 (K), D403.2 (A), J401.1, U401.3 (A0)
unnamed: D402.1 (K), D410.2 (A), J401.8, U401.10 (A7)
unnamed: D402.3 (K), D409.2 (A), J401.7, U401.9 (A6)
unnamed: D402.4 (K), D408.2 (A), J401.6, U401.8 (A5)
unnamed: D402.5 (K), D407.2 (A), J401.5, U401.7 (A4)
unnamed: D403.1 (K), R401.1
unnamed: D404.1 (K), R402.1
unnamed: D405.1 (K), R403.1
unnamed: D406.1 (K), R404.1
unnamed: D407.1 (K), R405.1
unnamed: D408.1 (K), R406.1
unnamed: D409.1 (K), R407.1
unnamed: D410.1 (K), R408.1

Notes on the sheet:
Bidirectional Data

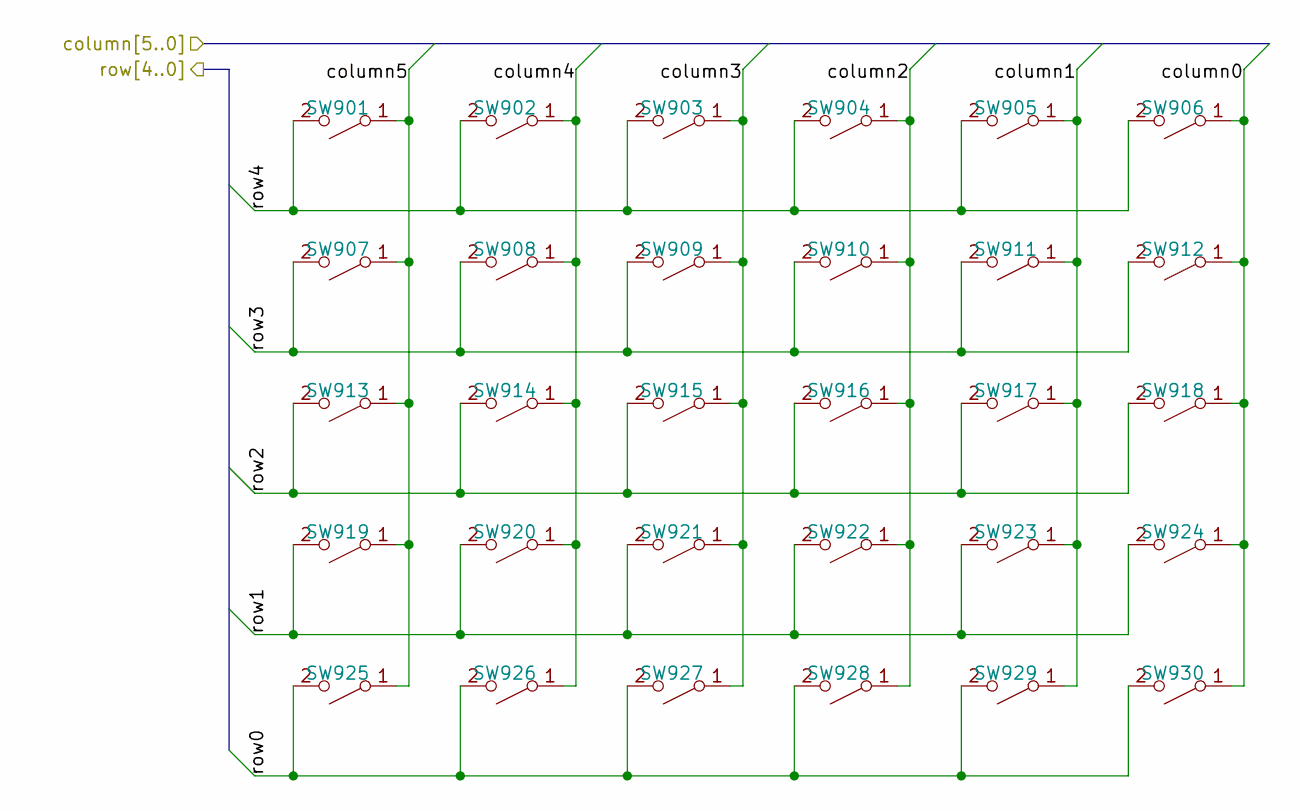
[picture p21: schematic sub_keyboard.sch]

Parts:
SW901, SW902, SW903, SW904, SW905, SW906, SW907, SW908, SW909, SW910, SW911, SW912, SW913, SW914, SW915, SW916, SW917, SW918, SW919, SW920, SW921, SW922, SW923, SW924, SW925, SW926, SW927, SW928, SW929, SW930: SW_SPST; SW_Cherry_MX1A_1.00u_PCB

Connections:
/FPGA/C0: SW906.1 (A), SW912.1 (A), SW918.1 (A), SW924.1 (A), SW930.1 (A); also elsewhere on the board
/FPGA/C1: SW905.1 (A), SW911.1 (A), SW917.1 (A), SW923.1 (A), SW929.1 (A); also elsewhere on the board
/FPGA/C2: SW904.1 (A), SW910.1 (A), SW916.1 (A), SW922.1 (A), SW928.1 (A); also elsewhere on the board
/FPGA/C3: SW903.1 (A), SW909.1 (A), SW915.1 (A), SW921.1 (A), SW927.1 (A); also elsewhere on the board
/FPGA/C4: SW902.1 (A), SW908.1 (A), SW914.1 (A), SW920.1 (A), SW926.1 (A); also elsewhere on the board
/FPGA/C5: SW901.1 (A), SW907.1 (A), SW913.1 (A), SW919.1 (A), SW925.1 (A); also elsewhere on the board
/FPGA/R0: SW925.2 (B), SW926.2 (B), SW927.2 (B), SW928.2 (B), SW929.2 (B), SW930.2 (B); also elsewhere on the board
/FPGA/R1: SW919.2 (B), SW920.2 (B), SW921.2 (B), SW922.2 (B), SW923.2 (B), SW924.2 (B); also elsewhere on the board
/FPGA/R2: SW913.2 (B), SW914.2 (B), SW915.2 (B), SW916.2 (B), SW917.2 (B), SW918.2 (B); also elsewhere on the board
/FPGA/R3: SW907.2 (B), SW908.2 (B), SW909.2 (B), SW910.2 (B), SW911.2 (B), SW912.2 (B); also elsewhere on the board
/FPGA/R4: SW901.2 (B), SW902.2 (B), SW903.2 (B), SW904.2 (B), SW905.2 (B), SW906.2 (B); also elsewhere on the board

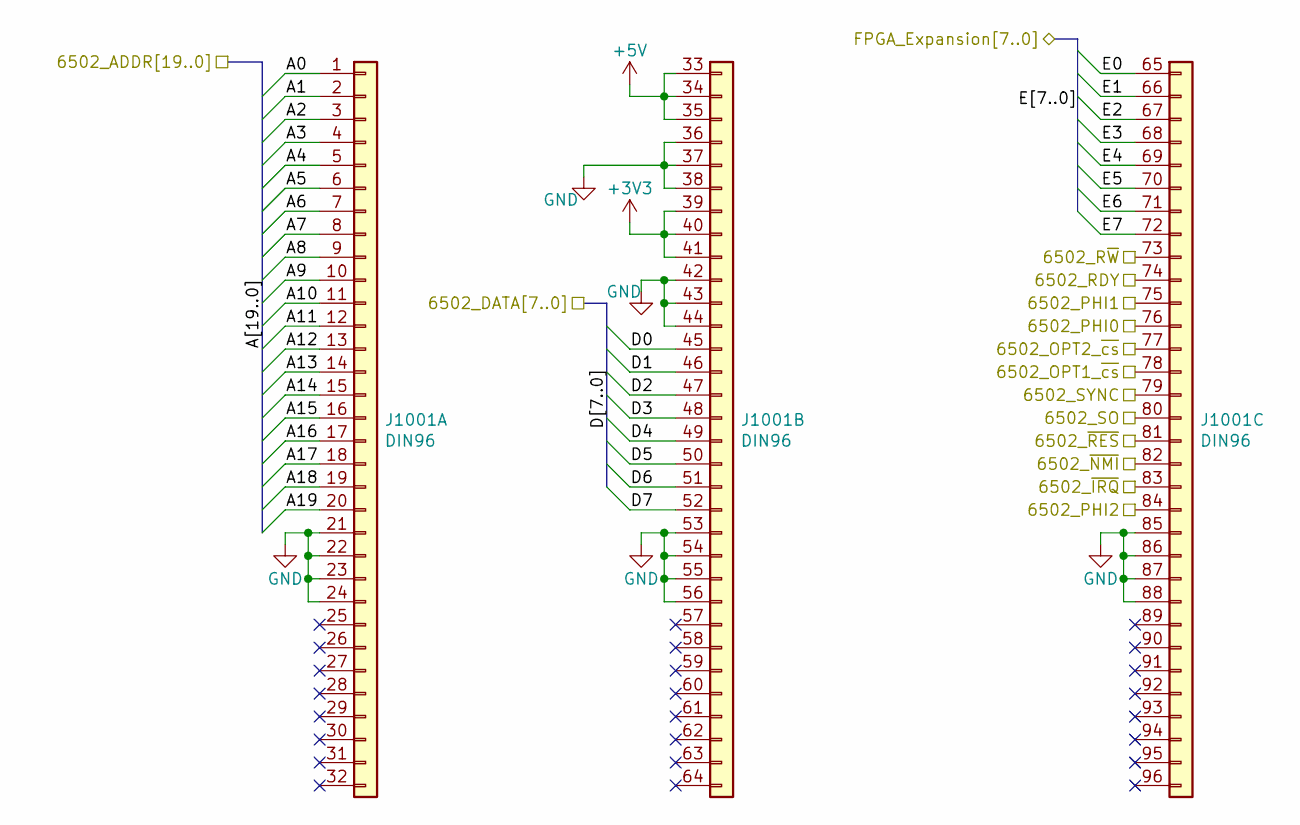
[picture p22: schematic sub_expansion.sch]

Parts:
J1001: DIN96; DIN-8609-2030

Connections:
+5V: J1001.33 (Pin_1), J1001.34 (Pin_2), J1001.35 (Pin_3); also elsewhere on the board
/6502/6502_PHI0: J1001.76 (Pin_12); also elsewhere on the board
/6502/6502_PHI1: J1001.75 (Pin_11); also elsewhere on the board
/6502/6502_PHI2: J1001.84 (Pin_20); also elsewhere on the board
/6502/6502_RDY: J1001.74 (Pin_10); also elsewhere on the board
/6502/6502_R~W: J1001.73 (Pin_9); also elsewhere on the board
/6502/6502_SO: J1001.80 (Pin_16); also elsewhere on the board
/6502/6502_SYNC: J1001.79 (Pin_15); also elsewhere on the board
/6502/6502_~IRQ: J1001.83 (Pin_19); also elsewhere on the board
/6502/6502_~NMI: J1001.82 (Pin_18); also elsewhere on the board
/6502/B_D0: J1001.45 (Pin_13); also elsewhere on the board
/6502/B_D1: J1001.46 (Pin_14); also elsewhere on the board
/6502/B_D2: J1001.47 (Pin_15); also elsewhere on the board
/6502/B_D3: J1001.48 (Pin_16); also elsewhere on the board
/6502/B_D4: J1001.49 (Pin_17); also elsewhere on the board
/6502/B_D5: J1001.50 (Pin_18); also elsewhere on the board
/6502/B_D6: J1001.51 (Pin_19); also elsewhere on the board
/6502/B_D7: J1001.52 (Pin_20); also elsewhere on the board
/Bus Expansion/6502_OPT1_~cs: J1001.78 (Pin_14); also elsewhere on the board
/Bus Expansion/6502_OPT2_~cs: J1001.77 (Pin_13); also elsewhere on the board
/Bus Expansion/6502_~RES: J1001.81 (Pin_17); also elsewhere on the board
/Bus Expansion/A0: J1001.1; also elsewhere on the board
/Bus Expansion/A1: J1001.2; also elsewhere on the board
/Bus Expansion/A2: J1001.3; also elsewhere on the board
/Bus Expansion/A3: J1001.4; also elsewhere on the board
/Bus Expansion/A4: J1001.5; also elsewhere on the board
/Bus Expansion/A5: J1001.6; also elsewhere on the board
/Bus Expansion/A6: J1001.7; also elsewhere on the board
/Bus Expansion/A7: J1001.8; also elsewhere on the board
/Bus Expansion/A8: J1001.9; also elsewhere on the board
/Bus Expansion/A9: J1001.10; also elsewhere on the board
/Bus Expansion/A10: J1001.11; also elsewhere on the board
/Bus Expansion/A11: J1001.12; also elsewhere on the board
/Bus Expansion/A12: J1001.13; also elsewhere on the board
/Bus Expansion/A13: J1001.14; also elsewhere on the board
/Bus Expansion/A14: J1001.15; also elsewhere on the board
/Bus Expansion/A15: J1001.16; also elsewhere on the board
/Bus Expansion/A16: J1001.17; also elsewhere on the board
/Bus Expansion/A17: J1001.18; also elsewhere on the board
/Bus Expansion/A18: J1001.19; also elsewhere on the board
/Bus Expansion/A19: J1001.20; also elsewhere on the board
/Bus Expansion/E0: J1001.65 (Pin_1); also elsewhere on the board
/Bus Expansion/E1: J1001.66 (Pin_2); also elsewhere on the board
/Bus Expansion/E2: J1001.67 (Pin_3); also elsewhere on the board
/Bus Expansion/E3: J1001.68 (Pin_4); also elsewhere on the board
/Bus Expansion/E4: J1001.69 (Pin_5); also elsewhere on the board
/Bus Expansion/E5: J1001.70 (Pin_6); also elsewhere on the board
/Bus Expansion/E6: J1001.71 (Pin_7); also elsewhere on the board
/Bus Expansion/E7: J1001.72 (Pin_8); also elsewhere on the board
GND: J1001.21, J1001.22, J1001.23, J1001.24, J1001.36 (Pin_4), J1001.37 (Pin_5), J1001.38 (Pin_6), J1001.42 (Pin_10), J1001.43 (Pin_11), J1001.44 (Pin_12), J1001.53 (Pin_21), J1001.54 (Pin_22), J1001.55 (Pin_23), J1001.56 (Pin_24), J1001.85 (Pin_21), J1001.86 (Pin_22), J1001.87 (Pin_23), J1001.88 (Pin_24); also elsewhere on the board

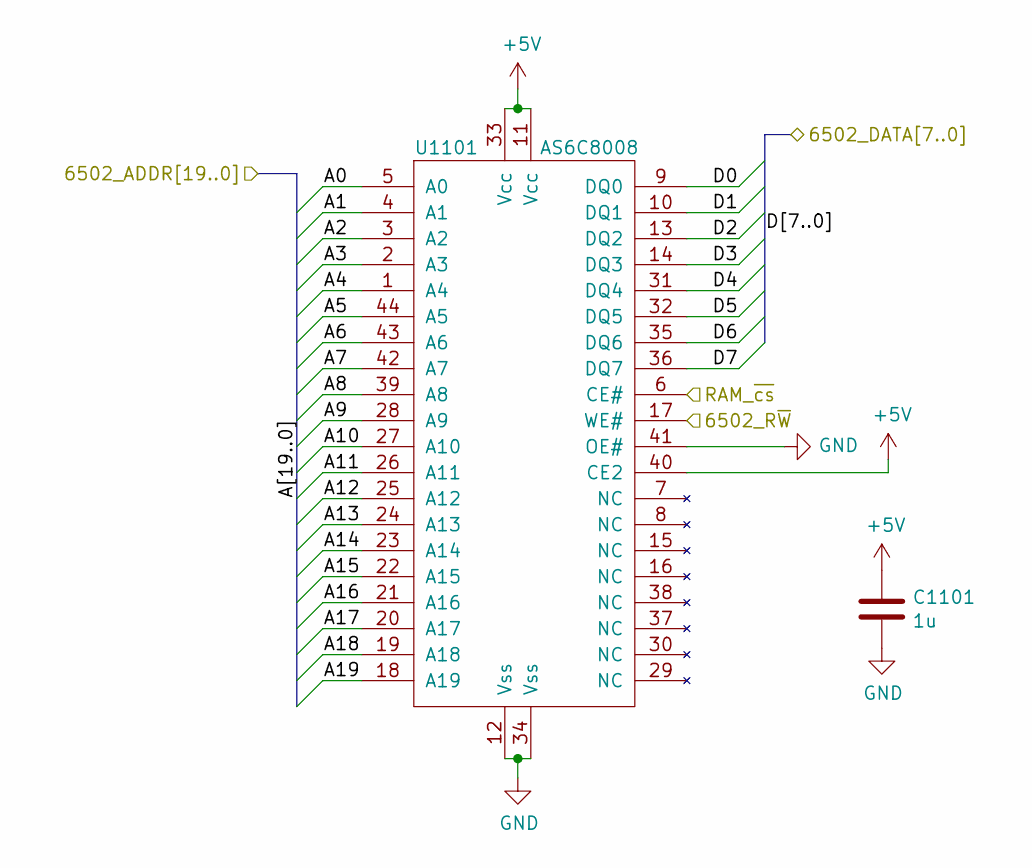
[picture p23: schematic sub_ram.sch]

Parts:
C1101: 1u; C_0603_1608Metric
U1101: AS6C8008; AS6C8008-SOIC-44

Connections:
+5V: C1101.1, U1101.11 (Vcc), U1101.33 (Vcc), U1101.40 (CE2); also elsewhere on the board
/6502/6502_R~W: U1101.17 (WE#); also elsewhere on the board
/6502/B_D0: U1101.9 (DQ0); also elsewhere on the board
/6502/B_D1: U1101.10 (DQ1); also elsewhere on the board
/6502/B_D2: U1101.13 (DQ2); also elsewhere on the board
/6502/B_D3: U1101.14 (DQ3); also elsewhere on the board
/6502/B_D4: U1101.31 (DQ4); also elsewhere on the board
/6502/B_D5: U1101.32 (DQ5); also elsewhere on the board
/6502/B_D6: U1101.35 (DQ6); also elsewhere on the board
/6502/B_D7: U1101.36 (DQ7); also elsewhere on the board
/Bus Expansion/A0: U1101.5 (A0); also elsewhere on the board
/Bus Expansion/A1: U1101.4 (A1); also elsewhere on the board
/Bus Expansion/A2: U1101.3 (A2); also elsewhere on the board
/Bus Expansion/A3: U1101.2 (A3); also elsewhere on the board
/Bus Expansion/A4: U1101.1 (A4); also elsewhere on the board
/Bus Expansion/A5: U1101.44 (A5); also elsewhere on the board
/Bus Expansion/A6: U1101.43 (A6); also elsewhere on the board
/Bus Expansion/A7: U1101.42 (A7); also elsewhere on the board
/Bus Expansion/A8: U1101.39 (A8); also elsewhere on the board
/Bus Expansion/A9: U1101.28 (A9); also elsewhere on the board
/Bus Expansion/A10: U1101.27 (A10); also elsewhere on the board
/Bus Expansion/A11: U1101.26 (A11); also elsewhere on the board
/Bus Expansion/A12: U1101.25 (A12); also elsewhere on the board
/Bus Expansion/A13: U1101.24 (A13); also elsewhere on the board
/Bus Expansion/A14: U1101.23 (A14); also elsewhere on the board
/Bus Expansion/A15: U1101.22 (A15); also elsewhere on the board
/Bus Expansion/A16: U1101.21 (A16); also elsewhere on the board
/Bus Expansion/A17: U1101.20 (A17); also elsewhere on the board
/Bus Expansion/A18: U1101.19 (A18); also elsewhere on the board
/Bus Expansion/A19: U1101.18 (A19); also elsewhere on the board
/FPGA/6502_RAM_~cs: U1101.6 (CE#); also elsewhere on the board
GND: C1101.2, U1101.12 (Vss), U1101.34 (Vss), U1101.41 (OE#); also elsewhere on the board
