ChrisPVille/quokka/board/quokka.kicad_pcb

## KiCad design board/quokka.kicad_pcb (continued)

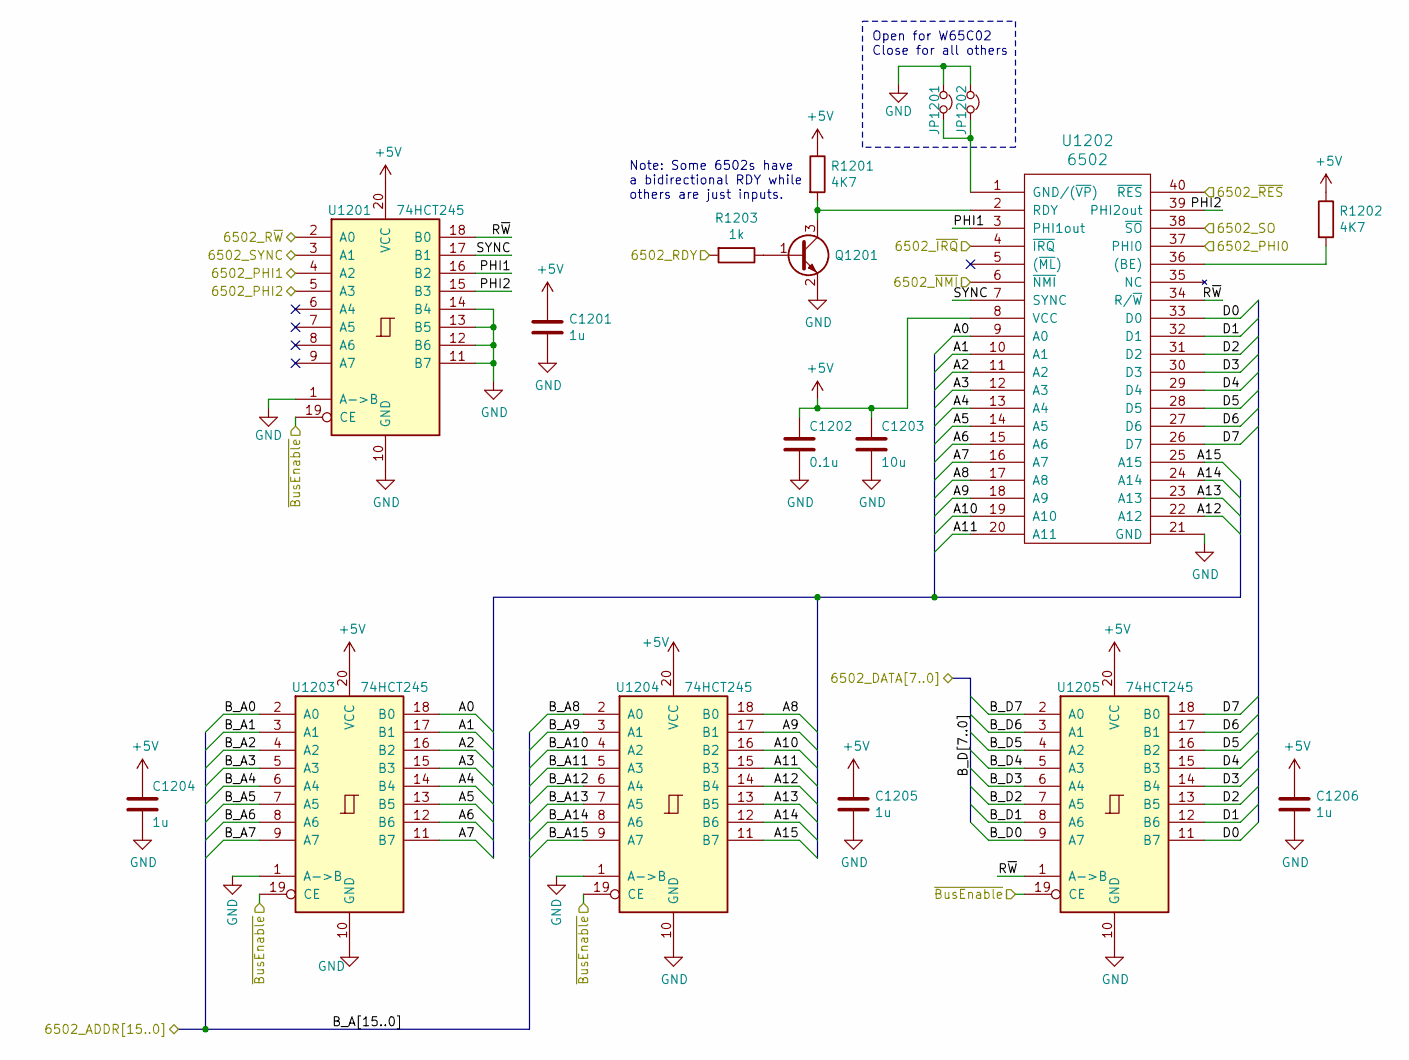
[picture p24: schematic sub_6502.sch]

Parts:
C1201, C1204, C1205, C1206: 1u; C_0603_1608Metric
C1202: 0.1u; C_0603_1608Metric
C1203: 10u; C_1206_3216Metric
JP1201: Jumper_NC_Small; PinHeader_1x02_P2.54mm_Vertical
JP1202: WireJumper; PinHeader_1x02_P2.54mm_Vertical
Q1201: Q_NPN_BEC; SOT-23
R1201, R1202: 4K7; R_0603_1608Metric
R1203: 1k; R_0603_1608Metric
U1201, U1203, U1204, U1205: 74HCT245; SSOP-20_4.4x6.5mm_P0.65mm
U1202: 6502; DIP-40_W15.24mm

Connections:
+5V: C1201.1, C1202.1, C1203.1, C1204.1, C1205.1, C1206.1, R1201.1, R1202.1, U1201.20 (VCC), U1202.8 (VCC), U1203.20 (VCC), U1204.20 (VCC), U1205.20 (VCC); also elsewhere on the board
/6502/6502_PHI0: U1202.37 (PHI0); also elsewhere on the board
/6502/6502_PHI1: U1201.4 (A2); also elsewhere on the board
/6502/6502_PHI2: U1201.5 (A3); also elsewhere on the board
/6502/6502_RDY: R1203.2; also elsewhere on the board
/6502/6502_R~W: U1201.2 (A0); also elsewhere on the board
/6502/6502_SO: U1202.38 (~SO); also elsewhere on the board
/6502/6502_SYNC: U1201.3 (A1); also elsewhere on the board
/6502/6502_~IRQ: U1202.4 (~IRQ); also elsewhere on the board
/6502/6502_~NMI: U1202.6 (~NMI); also elsewhere on the board
/6502/6502_~RES: U1202.40 (~RES); also elsewhere on the board
/6502/A0: U1202.9 (A0), U1203.18 (B0)
/6502/A1: U1202.10 (A1), U1203.17 (B1)
/6502/A2: U1202.11 (A2), U1203.16 (B2)
/6502/A3: U1202.12 (A3), U1203.15 (B3)
/6502/A4: U1202.13 (A4), U1203.14 (B4)
/6502/A5: U1202.14 (A5), U1203.13 (B5)
/6502/A6: U1202.15 (A6), U1203.12 (B6)
/6502/A7: U1202.16 (A7), U1203.11 (B7)
/6502/A8: U1202.17 (A8), U1204.18 (B0)
/6502/A9: U1202.18 (A9), U1204.17 (B1)
/6502/A10: U1202.19 (A10), U1204.16 (B2)
/6502/A11: U1202.20 (A11), U1204.15 (B3)
/6502/A12: U1202.22 (A12), U1204.14 (B4)
/6502/A13: U1202.23 (A13), U1204.13 (B5)
/6502/A14: U1202.24 (A14), U1204.12 (B6)
/6502/A15: U1202.25 (A15), U1204.11 (B7)
/6502/B_D0: U1205.9 (A7); also elsewhere on the board
/6502/B_D1: U1205.8 (A6); also elsewhere on the board
/6502/B_D2: U1205.7 (A5); also elsewhere on the board
/6502/B_D3: U1205.6 (A4); also elsewhere on the board
/6502/B_D4: U1205.5 (A3); also elsewhere on the board
/6502/B_D5: U1205.4 (A2); also elsewhere on the board
/6502/B_D6: U1205.3 (A1); also elsewhere on the board
/6502/B_D7: U1205.2 (A0); also elsewhere on the board
/6502/D0: U1202.33 (D0), U1205.11 (B7)
/6502/D1: U1202.32 (D1), U1205.12 (B6)
/6502/D2: U1202.31 (D2), U1205.13 (B5)
/6502/D3: U1202.30 (D3), U1205.14 (B4)
/6502/D4: U1202.29 (D4), U1205.15 (B3)
/6502/D5: U1202.28 (D5), U1205.16 (B2)
/6502/D6: U1202.27 (D6), U1205.17 (B1)
/6502/D7: U1202.26 (D7), U1205.18 (B0)
/6502/PHI1: U1201.16 (B2), U1202.3 (PHI1out)
/6502/PHI2: U1201.15 (B3), U1202.39 (PHI2out)
/6502/R~W: U1201.18 (B0), U1202.34 (R/~W), U1205.1 (A->B)
/6502/SYNC: U1201.17 (B1), U1202.7 (SYNC)
/Bus Expansion/A0: U1203.2 (A0); also elsewhere on the board
/Bus Expansion/A1: U1203.3 (A1); also elsewhere on the board
/Bus Expansion/A2: U1203.4 (A2); also elsewhere on the board
/Bus Expansion/A3: U1203.5 (A3); also elsewhere on the board
/Bus Expansion/A4: U1203.6 (A4); also elsewhere on the board
/Bus Expansion/A5: U1203.7 (A5); also elsewhere on the board
/Bus Expansion/A6: U1203.8 (A6); also elsewhere on the board
/Bus Expansion/A7: U1203.9 (A7); also elsewhere on the board
/Bus Expansion/A8: U1204.2 (A0); also elsewhere on the board
/Bus Expansion/A9: U1204.3 (A1); also elsewhere on the board
/Bus Expansion/A10: U1204.4 (A2); also elsewhere on the board
/Bus Expansion/A11: U1204.5 (A3); also elsewhere on the board
/Bus Expansion/A12: U1204.6 (A4); also elsewhere on the board
/Bus Expansion/A13: U1204.7 (A5); also elsewhere on the board
/Bus Expansion/A14: U1204.8 (A6); also elsewhere on the board
/Bus Expansion/A15: U1204.9 (A7); also elsewhere on the board
/FPGA/Physical6502_~BusEnable: U1201.19 (CE), U1203.19 (CE), U1204.19 (CE), U1205.19 (CE); also elsewhere on the board
GND: C1201.2, C1202.2, C1203.2, C1204.2, C1205.2, C1206.2, JP1201.1, JP1202.1, Q1201.2 (E), U1201.1 (A->B), U1201.10 (GND), U1201.11 (B7), U1201.12 (B6), U1201.13 (B5), U1201.14 (B4), U1202.21 (GND), U1203.1 (A->B), U1203.10 (GND), U1204.1 (A->B), U1204.10 (GND), U1205.10 (GND); also elsewhere on the board
unnamed: JP1201.2, JP1202.2, U1202.1 (GND/(~VP~))
unnamed: Q1201.1 (B), R1203.1
unnamed: Q1201.3 (C), R1201.2, U1202.2 (RDY)
unnamed: R1202.2, U1202.36 ((BE))

Notes on the sheet:
Open for W65C02 Close for all others
Note: Some 6502s have a bidirectional RDY while others are just inputs.

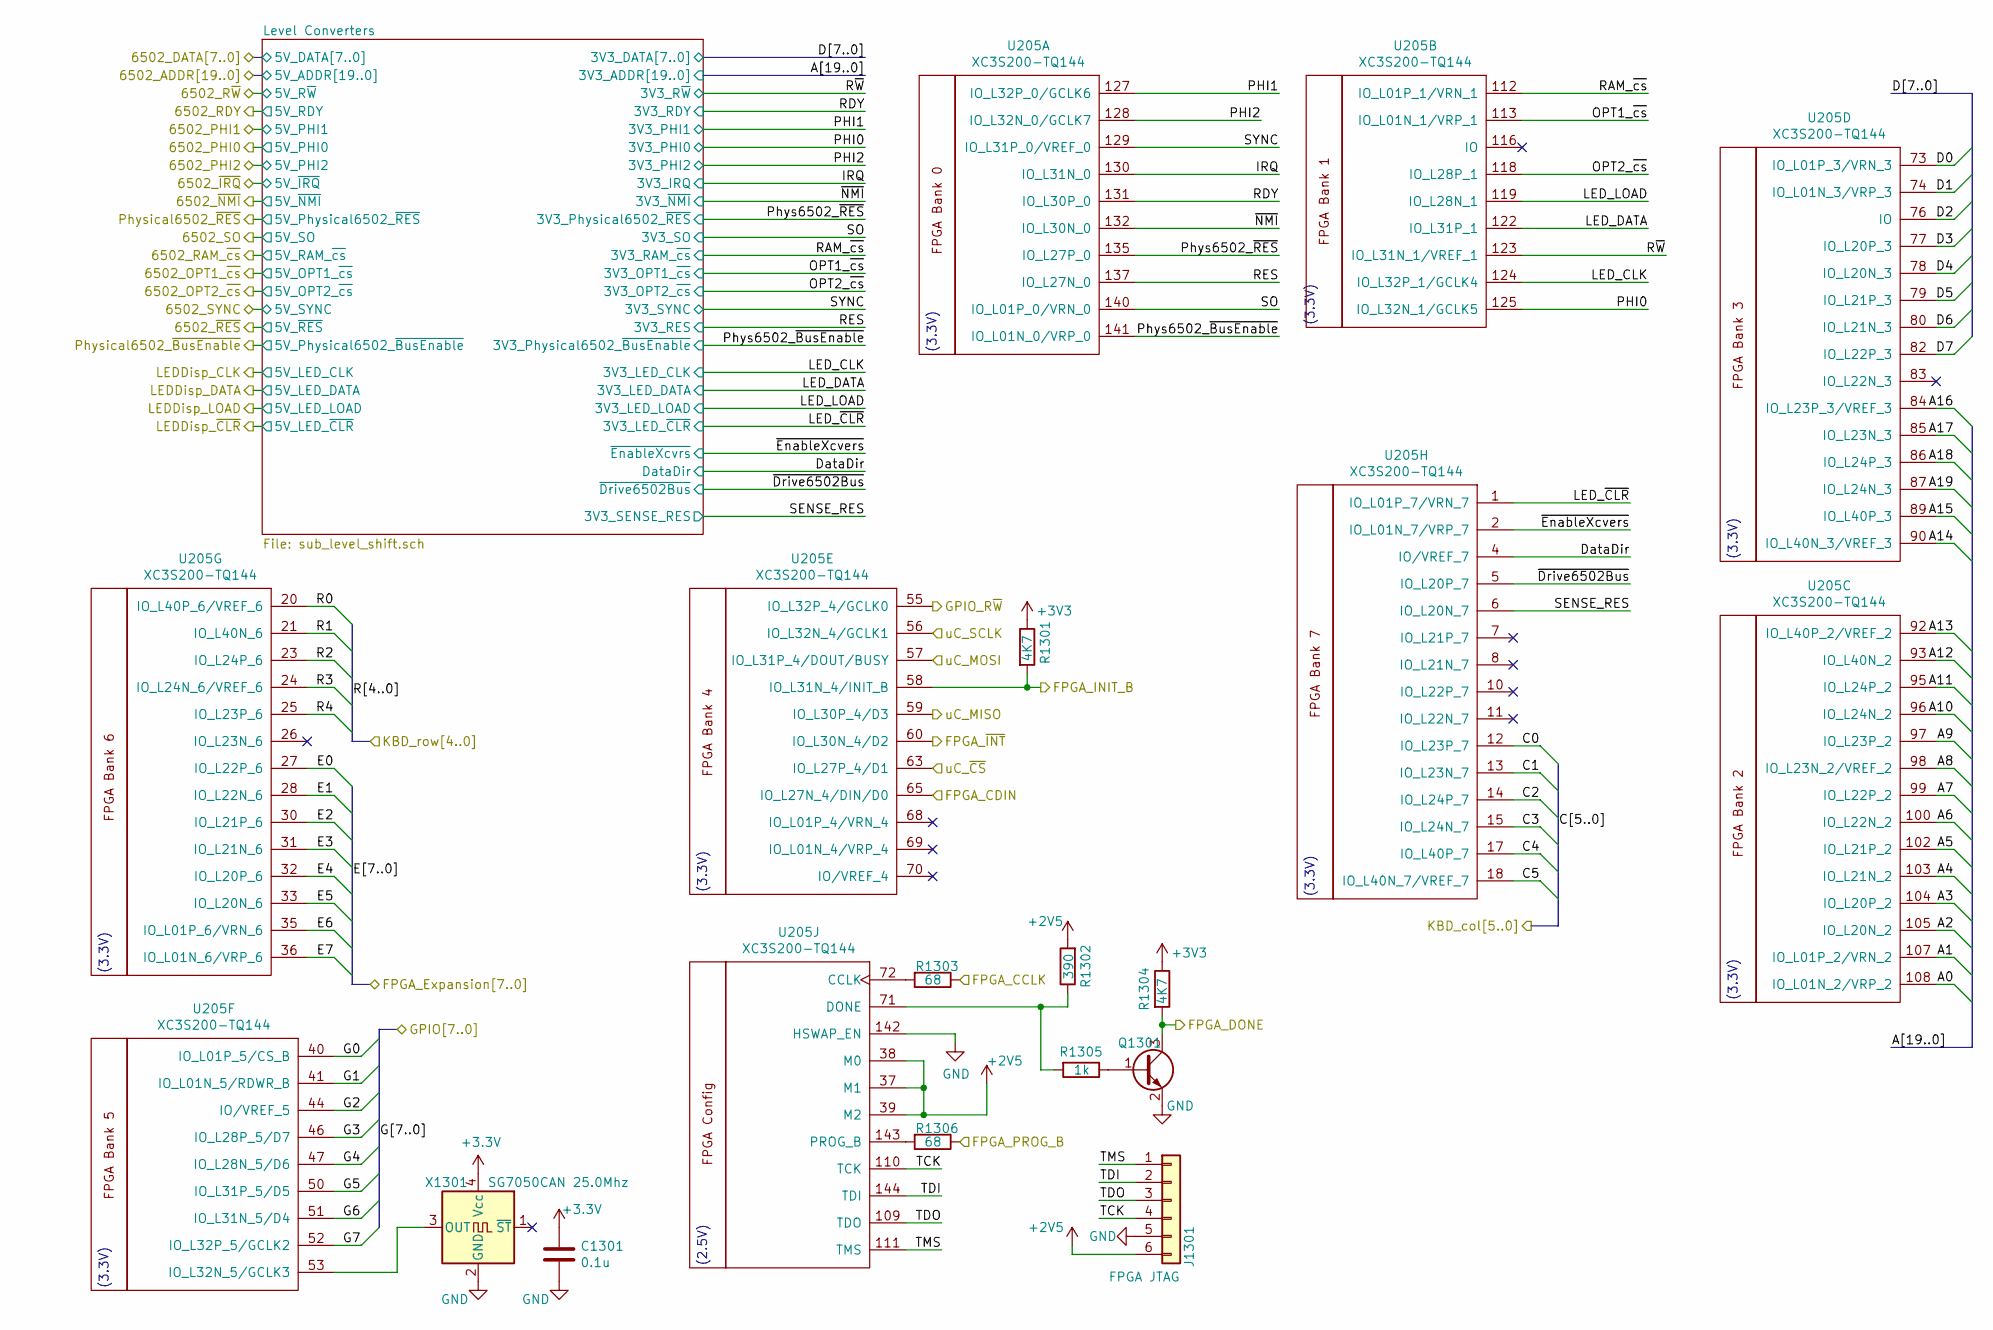
[picture p25: schematic sub_fpga.sch]

Parts:
C1301: 0.1u; C_0603_1608Metric
J1301: FPGA JTAG; PinHeader_1x06_P2.54mm_Vertical
Q1301: Q_NPN_BEC; SOT-23
R1301, R1304: 4K7; R_0603_1608Metric
R1302: 390; R_0603_1608Metric
R1303, R1306: 68; R_0603_1608Metric
R1305: 1k; R_0603_1608Metric
U205: XC3S200-TQ144; LQFP-144_20x20mm_P0.5mm
X1301: SG7050CAN 25.0Mhz; Oscillator_SMD_SeikoEpson_SG8002CA-4Pin_7.0x5.0mm

Connections:
+2V5: J1301.6, R1302.2, U205.37 (M1), U205.38 (M0), U205.39 (M2); also elsewhere on the board
/Bus Expansion/E0: U205.27 (IO_L22P_6); also elsewhere on the board
/Bus Expansion/E1: U205.28 (IO_L22N_6); also elsewhere on the board
/Bus Expansion/E2: U205.30 (IO_L21P_6); also elsewhere on the board
/Bus Expansion/E3: U205.31 (IO_L21N_6); also elsewhere on the board
/Bus Expansion/E4: U205.32 (IO_L20P_6); also elsewhere on the board
/Bus Expansion/E5: U205.33 (IO_L20N_6); also elsewhere on the board
/Bus Expansion/E6: U205.35 (IO_L01P_6/VRN_6); also elsewhere on the board
/Bus Expansion/E7: U205.36 (IO_L01N_6/VRP_6); also elsewhere on the board
/FPGA/A0: U205.108 (IO_L01N_2/VRP_2); also elsewhere on the board
/FPGA/A1: U205.107 (IO_L01P_2/VRN_2); also elsewhere on the board
/FPGA/A2: U205.105 (IO_L20N_2); also elsewhere on the board
/FPGA/A3: U205.104 (IO_L20P_2); also elsewhere on the board
/FPGA/A4: U205.103 (IO_L21N_2); also elsewhere on the board
/FPGA/A5: U205.102 (IO_L21P_2); also elsewhere on the board
/FPGA/A6: U205.100 (IO_L22N_2); also elsewhere on the board
/FPGA/A7: U205.99 (IO_L22P_2); also elsewhere on the board
/FPGA/A8: U205.98 (IO_L23N_2/VREF_2); also elsewhere on the board
/FPGA/A9: U205.97 (IO_L23P_2); also elsewhere on the board
/FPGA/A10: U205.96 (IO_L24N_2); also elsewhere on the board
/FPGA/A11: U205.95 (IO_L24P_2); also elsewhere on the board
/FPGA/A12: U205.93 (IO_L40N_2); also elsewhere on the board
/FPGA/A13: U205.92 (IO_L40P_2/VREF_2); also elsewhere on the board
/FPGA/A14: U205.90 (IO_L40N_3/VREF_3); also elsewhere on the board
/FPGA/A15: U205.89 (IO_L40P_3); also elsewhere on the board
/FPGA/A16: U205.84 (IO_L23P_3/VREF_3); also elsewhere on the board
/FPGA/A17: U205.85 (IO_L23N_3); also elsewhere on the board
/FPGA/A18: U205.86 (IO_L24P_3); also elsewhere on the board
/FPGA/A19: U205.87 (IO_L24N_3); also elsewhere on the board
/FPGA/C0: U205.12 (IO_L23P_7); also elsewhere on the board
/FPGA/C1: U205.13 (IO_L23N_7); also elsewhere on the board
/FPGA/C2: U205.14 (IO_L24P_7); also elsewhere on the board
/FPGA/C3: U205.15 (IO_L24N_7); also elsewhere on the board
/FPGA/C4: U205.17 (IO_L40P_7); also elsewhere on the board
/FPGA/C5: U205.18 (IO_L40N_7/VREF_7); also elsewhere on the board
/FPGA/D0: U205.73 (IO_L01P_3/VRN_3); also elsewhere on the board
/FPGA/D1: U205.74 (IO_L01N_3/VRP_3); also elsewhere on the board
/FPGA/D2: U205.76 (IO); also elsewhere on the board
/FPGA/D3: U205.77 (IO_L20P_3); also elsewhere on the board
/FPGA/D4: U205.78 (IO_L20N_3); also elsewhere on the board
/FPGA/D5: U205.79 (IO_L21P_3); also elsewhere on the board
/FPGA/D6: U205.80 (IO_L21N_3); also elsewhere on the board
/FPGA/D7: U205.82 (IO_L22P_3); also elsewhere on the board
/FPGA/DataDir: U205.4 (IO/VREF_7); also elsewhere on the board
/FPGA/FPGA_CCLK: R1303.1; also elsewhere on the board
/FPGA/FPGA_CDIN: U205.65 (IO_L27N_4/DIN/D0); also elsewhere on the board
/FPGA/FPGA_DONE: Q1301.3 (C), R1304.2; also elsewhere on the board
/FPGA/FPGA_PROG_B: R1306.1; also elsewhere on the board
/FPGA/FPGA_~INT: U205.60 (IO_L30N_4/D2); also elsewhere on the board
/FPGA/G0: U205.40 (IO_L01P_5/CS_B); also elsewhere on the board
/FPGA/G1: U205.41 (IO_L01N_5/RDWR_B); also elsewhere on the board
/FPGA/G2: U205.44 (IO/VREF_5); also elsewhere on the board
/FPGA/G3: U205.46 (IO_L28P_5/D7); also elsewhere on the board
/FPGA/G4: U205.47 (IO_L28N_5/D6); also elsewhere on the board
/FPGA/G5: U205.50 (IO_L31P_5/D5); also elsewhere on the board
/FPGA/G6: U205.51 (IO_L31N_5/D4); also elsewhere on the board
/FPGA/G7: U205.52 (IO_L32P_5/GCLK2); also elsewhere on the board
/FPGA/GPIO_R~W: U205.55 (IO_L32P_4/GCLK0); also elsewhere on the board
/FPGA/IRQ: U205.130 (IO_L31N_0); also elsewhere on the board
/FPGA/LED_CLK: U205.124 (IO_L32P_1/GCLK4); also elsewhere on the board
/FPGA/LED_DATA: U205.122 (IO_L31P_1); also elsewhere on the board
/FPGA/LED_LOAD: U205.119 (IO_L28N_1); also elsewhere on the board
/FPGA/LED_~CLR: U205.1 (IO_L01P_7/VRN_7); also elsewhere on the board
/FPGA/OPT1_~cs: U205.113 (IO_L01N_1/VRP_1); also elsewhere on the board
/FPGA/OPT2_~cs: U205.118 (IO_L28P_1); also elsewhere on the board
/FPGA/PHI0: U205.125 (IO_L32N_1/GCLK5); also elsewhere on the board
/FPGA/PHI1: U205.127 (IO_L32P_0/GCLK6); also elsewhere on the board
/FPGA/PHI2: U205.128 (IO_L32N_0/GCLK7); also elsewhere on the board
/FPGA/Phys6502_~BusEnable: U205.141 (IO_L01N_0/VRP_0); also elsewhere on the board
/FPGA/Phys6502_~RES: U205.135 (IO_L27P_0); also elsewhere on the board
/FPGA/R0: U205.20 (IO_L40P_6/VREF_6); also elsewhere on the board
/FPGA/R1: U205.21 (IO_L40N_6); also elsewhere on the board
/FPGA/R2: U205.23 (IO_L24P_6); also elsewhere on the board
/FPGA/R3: U205.24 (IO_L24N_6/VREF_6); also elsewhere on the board
/FPGA/R4: U205.25 (IO_L23P_6); also elsewhere on the board
/FPGA/RAM_~cs: U205.112 (IO_L01P_1/VRN_1); also elsewhere on the board
/FPGA/RDY: U205.131 (IO_L30P_0); also elsewhere on the board
/FPGA/RES: U205.137 (IO_L27N_0); also elsewhere on the board
/FPGA/R~W: U205.123 (IO_L31N_1/VREF_1); also elsewhere on the board
/FPGA/SENSE_RES: U205.6 (IO_L20N_7); also elsewhere on the board
/FPGA/SO: U205.140 (IO_L01P_0/VRN_0); also elsewhere on the board
/FPGA/SYNC: U205.129 (IO_L31P_0/VREF_0); also elsewhere on the board
/FPGA/TCK: J1301.4, U205.110 (TCK)
/FPGA/TDI: J1301.2, U205.144 (TDI)
/FPGA/TDO: J1301.3, U205.109 (TDO)
/FPGA/TMS: J1301.1, U205.111 (TMS)
/FPGA/~Drive6502Bus: U205.5 (IO_L20P_7); also elsewhere on the board
/FPGA/~EnableXcvers: U205.2 (IO_L01N_7/VRP_7); also elsewhere on the board
/FPGA/~NMI: U205.132 (IO_L30N_0); also elsewhere on the board
/Flash/MISO: U205.59 (IO_L30P_4/D3); also elsewhere on the board
/Flash/MOSI: U205.57 (IO_L31P_4/DOUT/BUSY); also elsewhere on the board
/Flash/SCLK: U205.56 (IO_L32N_4/GCLK1); also elsewhere on the board
/Microcontroller/FPGA_DONE: R1301.2, U205.58 (IO_L31N_4/INIT_B); also elsewhere on the board
/Microcontroller/SPI_FPGA_~CS: U205.63 (IO_L27P_4/D1); also elsewhere on the board
GND: C1301.2, J1301.5, Q1301.2 (E), U205.142 (HSWAP_EN), X1301.2 (GND); also elsewhere on the board
unnamed: Q1301.1 (B), R1305.1
unnamed: R1302.1, R1305.2, U205.71 (DONE)
unnamed: R1303.2, U205.72 (CCLK)
unnamed: R1306.2, U205.143 (PROG_B)
unnamed: U205.53 (IO_L32N_5/GCLK3), X1301.3 (OUT)

Notes on the sheet:
(3.3V)
(2.5V)

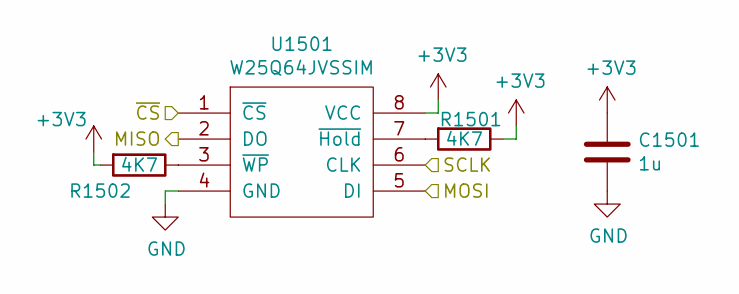
[picture p26: schematic sub_flash.sch]

Parts:
C1501: 1u; C_0603_1608Metric
R1501, R1502: 4K7; R_0603_1608Metric
U1501: W25Q64JVSSIM; SOIJ-8_5.3x5.3mm_P1.27mm

Connections:
/Flash/MISO: U1501.2 (DO); also elsewhere on the board
/Flash/MOSI: U1501.5 (DI); also elsewhere on the board
/Flash/SCLK: U1501.6 (CLK); also elsewhere on the board
/Microcontroller/SPI_FLASH_~CS: U1501.1 (~CS); also elsewhere on the board
GND: C1501.2, U1501.4 (GND); also elsewhere on the board
unnamed: R1501.2, U1501.7 (~Hold)
unnamed: R1502.1, U1501.3 (~WP)

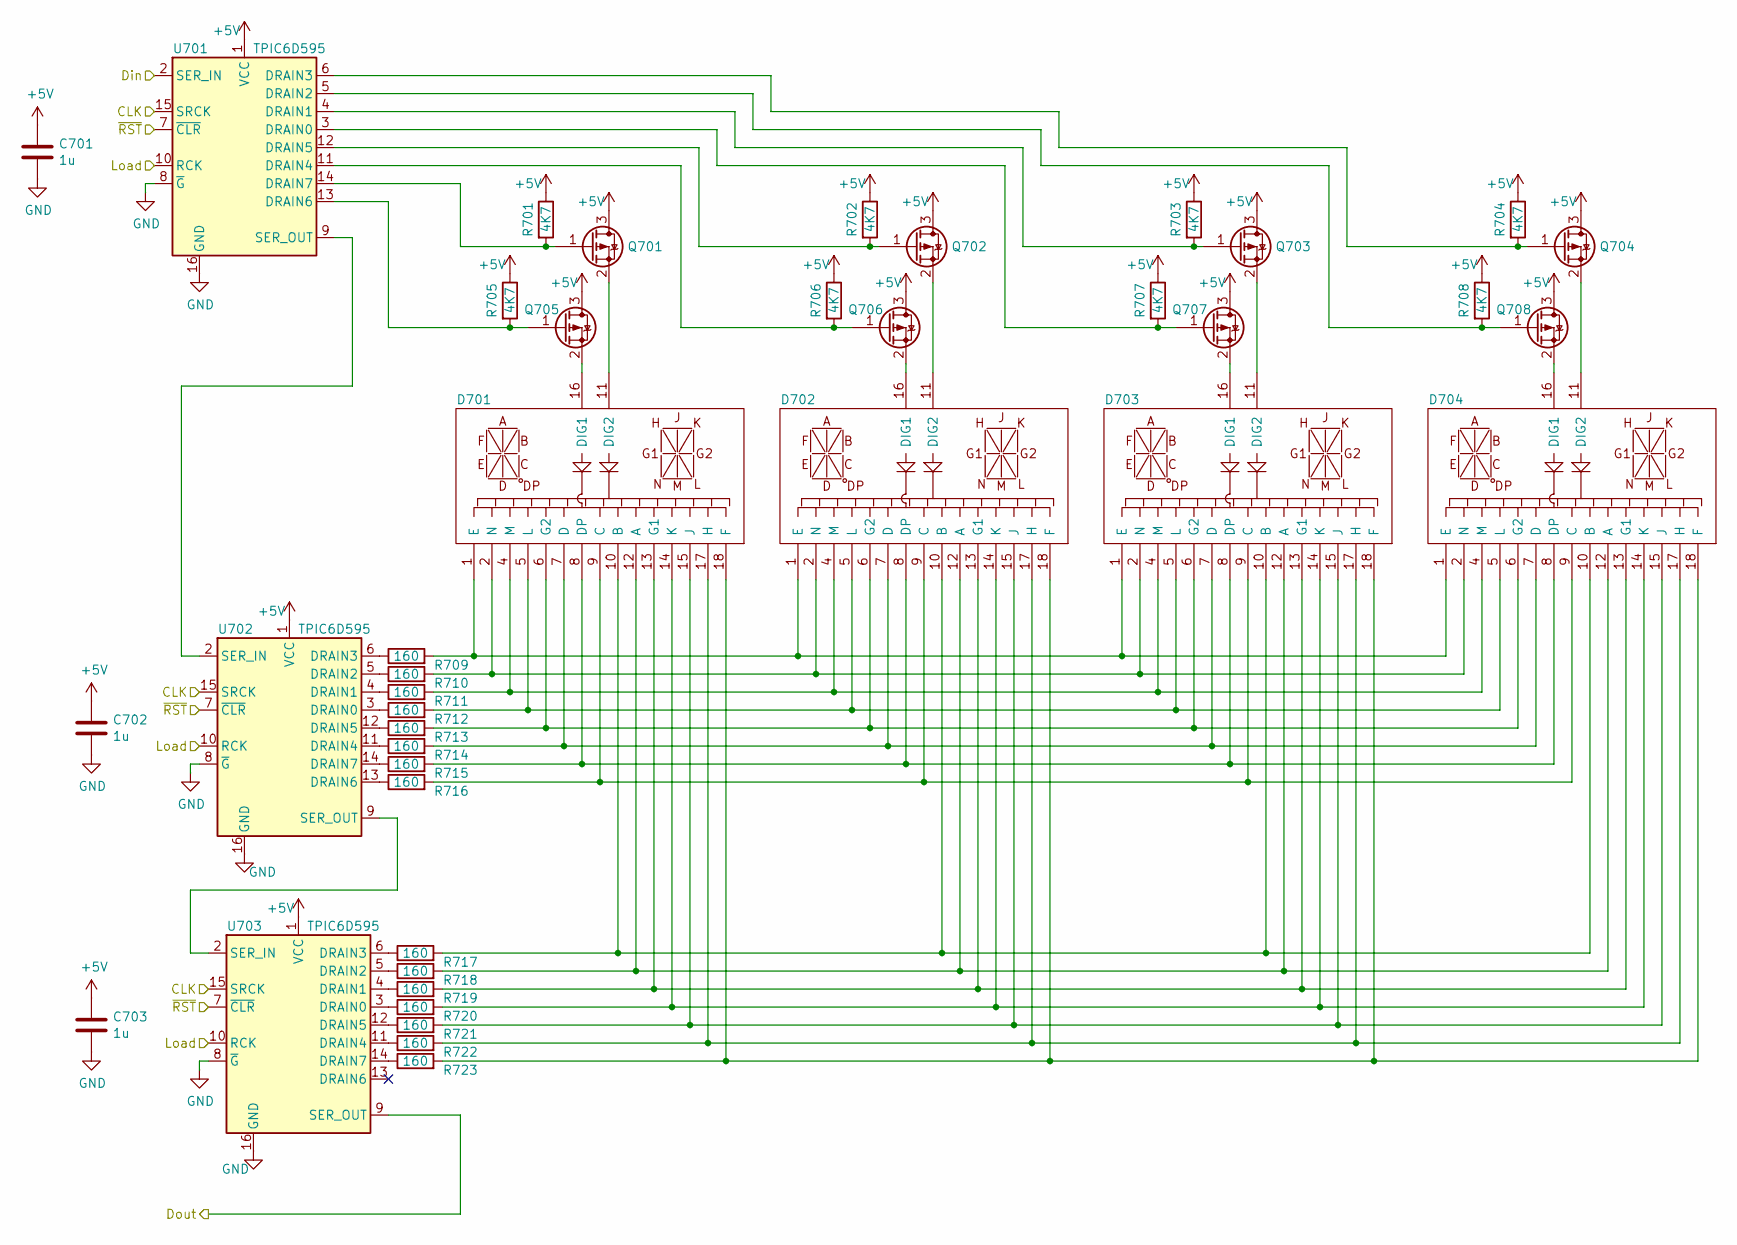
[picture p27: schematic sub_digit_row.sch]

Parts:
C601, C602, C603: 1u; C_0603_1608Metric
D601, D602, D603, D604: 14-segment
Q601, Q602, Q603, Q604, Q605, Q606, Q607, Q608: Q_PMOS_GSD; SOT-23
R601, R602, R603, R604, R605, R606, R607, R608: 4K7; R_0603_1608Metric
R609, R610, R611, R612, R613, R614, R615, R616, R617, R618, R619, R620, R621, R622, R623: 160; R_1206_3216Metric
U601, U602, U603: TPIC6D595; SOIC-16_3.9x9.9mm_P1.27mm

Connections:
+5V: C601.1, C602.1, C603.1, Q601.3 (D), Q602.3 (D), Q603.3 (D), Q604.3 (D), Q605.3 (D), Q606.3 (D), Q607.3 (D), Q608.3 (D), R601.1, R602.1, R603.1, R604.1, R605.1, R606.1, R607.1, R608.1, U601.1 (VCC), U602.1 (VCC), U603.1 (VCC); also elsewhere on the board
/Display/CLK: U601.15 (SRCK), U602.15 (SRCK), U603.15 (SRCK); also elsewhere on the board
/Display/Digit Row 2/Din: U601.2 (SER_IN); also elsewhere on the board
/Display/Last Digit Row/Din: U603.9 (SER_OUT); also elsewhere on the board
/FPGA/LEDDisp_LOAD: U601.10 (RCK), U602.10 (RCK), U603.10 (RCK); also elsewhere on the board
/FPGA/LEDDisp_~CLR: U601.7 (~CLR), U602.7 (~CLR), U603.7 (~CLR); also elsewhere on the board
GND: C601.2, C602.2, C603.2, U601.8 (~G), U601.16 (GND), U602.8 (~G), U602.16 (GND), U603.8 (~G), U603.16 (GND); also elsewhere on the board
unnamed: D601.1 (E), D602.1 (E), D603.1 (E), D604.1 (E), R609.2
unnamed: D601.2 (N), D602.2 (N), D603.2 (N), D604.2 (N), R610.2
unnamed: D601.4 (M), D602.4 (M), D603.4 (M), D604.4 (M), R611.2
unnamed: D601.5 (L), D602.5 (L), D603.5 (L), D604.5 (L), R612.2
unnamed: D601.6 (G2), D602.6 (G2), D603.6 (G2), D604.6 (G2), R613.2
unnamed: D601.7 (D), D602.7 (D), D603.7 (D), D604.7 (D), R614.2
unnamed: D601.8 (DP), D602.8 (DP), D603.8 (DP), D604.8 (DP), R615.2
unnamed: D601.9 (C), D602.9 (C), D603.9 (C), D604.9 (C), R616.2
unnamed: D601.10 (B), D602.10 (B), D603.10 (B), D604.10 (B), R617.2
unnamed: D601.11 (DIG2), Q601.2 (S)
unnamed: D601.12 (A), D602.12 (A), D603.12 (A), D604.12 (A), R618.2
unnamed: D601.13 (G1), D602.13 (G1), D603.13 (G1), D604.13 (G1), R619.2
unnamed: D601.14 (K), D602.14 (K), D603.14 (K), D604.14 (K), R620.2
unnamed: D601.15 (J), D602.15 (J), D603.15 (J), D604.15 (J), R621.2
unnamed: D601.16 (DIG1), Q605.2 (S)
unnamed: D601.17 (H), D602.17 (H), D603.17 (H), D604.17 (H), R622.2
unnamed: D601.18 (F), D602.18 (F), D603.18 (F), D604.18 (F), R623.2
unnamed: D602.11 (DIG2), Q602.2 (S)
unnamed: D602.16 (DIG1), Q606.2 (S)
unnamed: D603.11 (DIG2), Q603.2 (S)
unnamed: D603.16 (DIG1), Q607.2 (S)
unnamed: D604.11 (DIG2), Q604.2 (S)
unnamed: D604.16 (DIG1), Q608.2 (S)
unnamed: Q601.1 (G), R601.2, U601.14 (DRAIN7)
unnamed: Q602.1 (G), R602.2, U601.12 (DRAIN5)
unnamed: Q603.1 (G), R603.2, U601.4 (DRAIN1)
unnamed: Q604.1 (G), R604.2, U601.6 (DRAIN3)
unnamed: Q605.1 (G), R605.2, U601.13 (DRAIN6)
unnamed: Q606.1 (G), R606.2, U601.11 (DRAIN4)
unnamed: Q607.1 (G), R607.2, U601.3 (DRAIN0)
unnamed: Q608.1 (G), R608.2, U601.5 (DRAIN2)
unnamed: R609.1, U602.6 (DRAIN3)
unnamed: R610.1, U602.5 (DRAIN2)
unnamed: R611.1, U602.4 (DRAIN1)
unnamed: R612.1, U602.3 (DRAIN0)
unnamed: R613.1, U602.12 (DRAIN5)
unnamed: R614.1, U602.11 (DRAIN4)
unnamed: R615.1, U602.14 (DRAIN7)
unnamed: R616.1, U602.13 (DRAIN6)
unnamed: R617.1, U603.6 (DRAIN3)
unnamed: R618.1, U603.5 (DRAIN2)
unnamed: R619.1, U603.4 (DRAIN1)
unnamed: R620.1, U603.3 (DRAIN0)
unnamed: R621.1, U603.12 (DRAIN5)
unnamed: R622.1, U603.11 (DRAIN4)
unnamed: R623.1, U603.14 (DRAIN7)
unnamed: U601.9 (SER_OUT), U602.2 (SER_IN)
unnamed: U602.9 (SER_OUT), U603.2 (SER_IN)

Parts of its further copies:
C701, C702, C703: 1u; C_0603_1608Metric
D701, D702, D703, D704: 14-segment
Q701, Q702, Q703, Q704, Q705, Q706, Q707, Q708: Q_PMOS_GSD; SOT-23
R701, R702, R703, R704, R705, R706, R707, R708: 4K7; R_0603_1608Metric
R709, R710, R711, R712, R713, R714, R715, R716, R717, R718, R719, R720, R721, R722, R723: 160; R_1206_3216Metric
U701, U702, U703: TPIC6D595; SOIC-16_3.9x9.9mm_P1.27mm

Connections of its further copies:
+5V: C701.1, C702.1, C703.1, Q701.3 (D), Q702.3 (D), Q703.3 (D), Q704.3 (D), Q705.3 (D), Q706.3 (D), Q707.3 (D), Q708.3 (D), R701.1, R702.1, R703.1, R704.1, R705.1, R706.1, R707.1, R708.1, U701.1 (VCC), U702.1 (VCC), U703.1 (VCC); also elsewhere on the board
/Display/CLK: U701.15 (SRCK), U702.15 (SRCK), U703.15 (SRCK); also elsewhere on the board
/Display/Digit Row 2/Din: U703.9 (SER_OUT); also elsewhere on the board
/Display/Din: U701.2 (SER_IN); also elsewhere on the board
/FPGA/LEDDisp_LOAD: U701.10 (RCK), U702.10 (RCK), U703.10 (RCK); also elsewhere on the board
/FPGA/LEDDisp_~CLR: U701.7 (~CLR), U702.7 (~CLR), U703.7 (~CLR); also elsewhere on the board
GND: C701.2, C702.2, C703.2, U701.8 (~G), U701.16 (GND), U702.8 (~G), U702.16 (GND), U703.8 (~G), U703.16 (GND); also elsewhere on the board
unnamed: D701.1 (E), D702.1 (E), D703.1 (E), D704.1 (E), R709.2
unnamed: D701.2 (N), D702.2 (N), D703.2 (N), D704.2 (N), R710.2
unnamed: D701.4 (M), D702.4 (M), D703.4 (M), D704.4 (M), R711.2
unnamed: D701.5 (L), D702.5 (L), D703.5 (L), D704.5 (L), R712.2
unnamed: D701.6 (G2), D702.6 (G2), D703.6 (G2), D704.6 (G2), R713.2
unnamed: D701.7 (D), D702.7 (D), D703.7 (D), D704.7 (D), R714.2
unnamed: D701.8 (DP), D702.8 (DP), D703.8 (DP), D704.8 (DP), R715.2
unnamed: D701.9 (C), D702.9 (C), D703.9 (C), D704.9 (C), R716.2
unnamed: D701.10 (B), D702.10 (B), D703.10 (B), D704.10 (B), R717.2
unnamed: D701.11 (DIG2), Q701.2 (S)
unnamed: D701.12 (A), D702.12 (A), D703.12 (A), D704.12 (A), R718.2
unnamed: D701.13 (G1), D702.13 (G1), D703.13 (G1), D704.13 (G1), R719.2
unnamed: D701.14 (K), D702.14 (K), D703.14 (K), D704.14 (K), R720.2
unnamed: D701.15 (J), D702.15 (J), D703.15 (J), D704.15 (J), R721.2
unnamed: D701.16 (DIG1), Q705.2 (S)
unnamed: D701.17 (H), D702.17 (H), D703.17 (H), D704.17 (H), R722.2
unnamed: D701.18 (F), D702.18 (F), D703.18 (F), D704.18 (F), R723.2
unnamed: D702.11 (DIG2), Q702.2 (S)
unnamed: D702.16 (DIG1), Q706.2 (S)
unnamed: D703.11 (DIG2), Q703.2 (S)
unnamed: D703.16 (DIG1), Q707.2 (S)
unnamed: D704.11 (DIG2), Q704.2 (S)
unnamed: D704.16 (DIG1), Q708.2 (S)
unnamed: Q701.1 (G), R701.2, U701.14 (DRAIN7)
unnamed: Q702.1 (G), R702.2, U701.12 (DRAIN5)
unnamed: Q703.1 (G), R703.2, U701.4 (DRAIN1)
unnamed: Q704.1 (G), R704.2, U701.6 (DRAIN3)
unnamed: Q705.1 (G), R705.2, U701.13 (DRAIN6)
unnamed: Q706.1 (G), R706.2, U701.11 (DRAIN4)
unnamed: Q707.1 (G), R707.2, U701.3 (DRAIN0)
unnamed: Q708.1 (G), R708.2, U701.5 (DRAIN2)
unnamed: R709.1, U702.6 (DRAIN3)
unnamed: R710.1, U702.5 (DRAIN2)
unnamed: R711.1, U702.4 (DRAIN1)
unnamed: R712.1, U702.3 (DRAIN0)
unnamed: R713.1, U702.12 (DRAIN5)
unnamed: R714.1, U702.11 (DRAIN4)
unnamed: R715.1, U702.14 (DRAIN7)
unnamed: R716.1, U702.13 (DRAIN6)
unnamed: R717.1, U703.6 (DRAIN3)
unnamed: R718.1, U703.5 (DRAIN2)
unnamed: R719.1, U703.4 (DRAIN1)
unnamed: R720.1, U703.3 (DRAIN0)
unnamed: R721.1, U703.12 (DRAIN5)
unnamed: R722.1, U703.11 (DRAIN4)
unnamed: R723.1, U703.14 (DRAIN7)
unnamed: U701.9 (SER_OUT), U702.2 (SER_IN)
unnamed: U702.9 (SER_OUT), U703.2 (SER_IN)

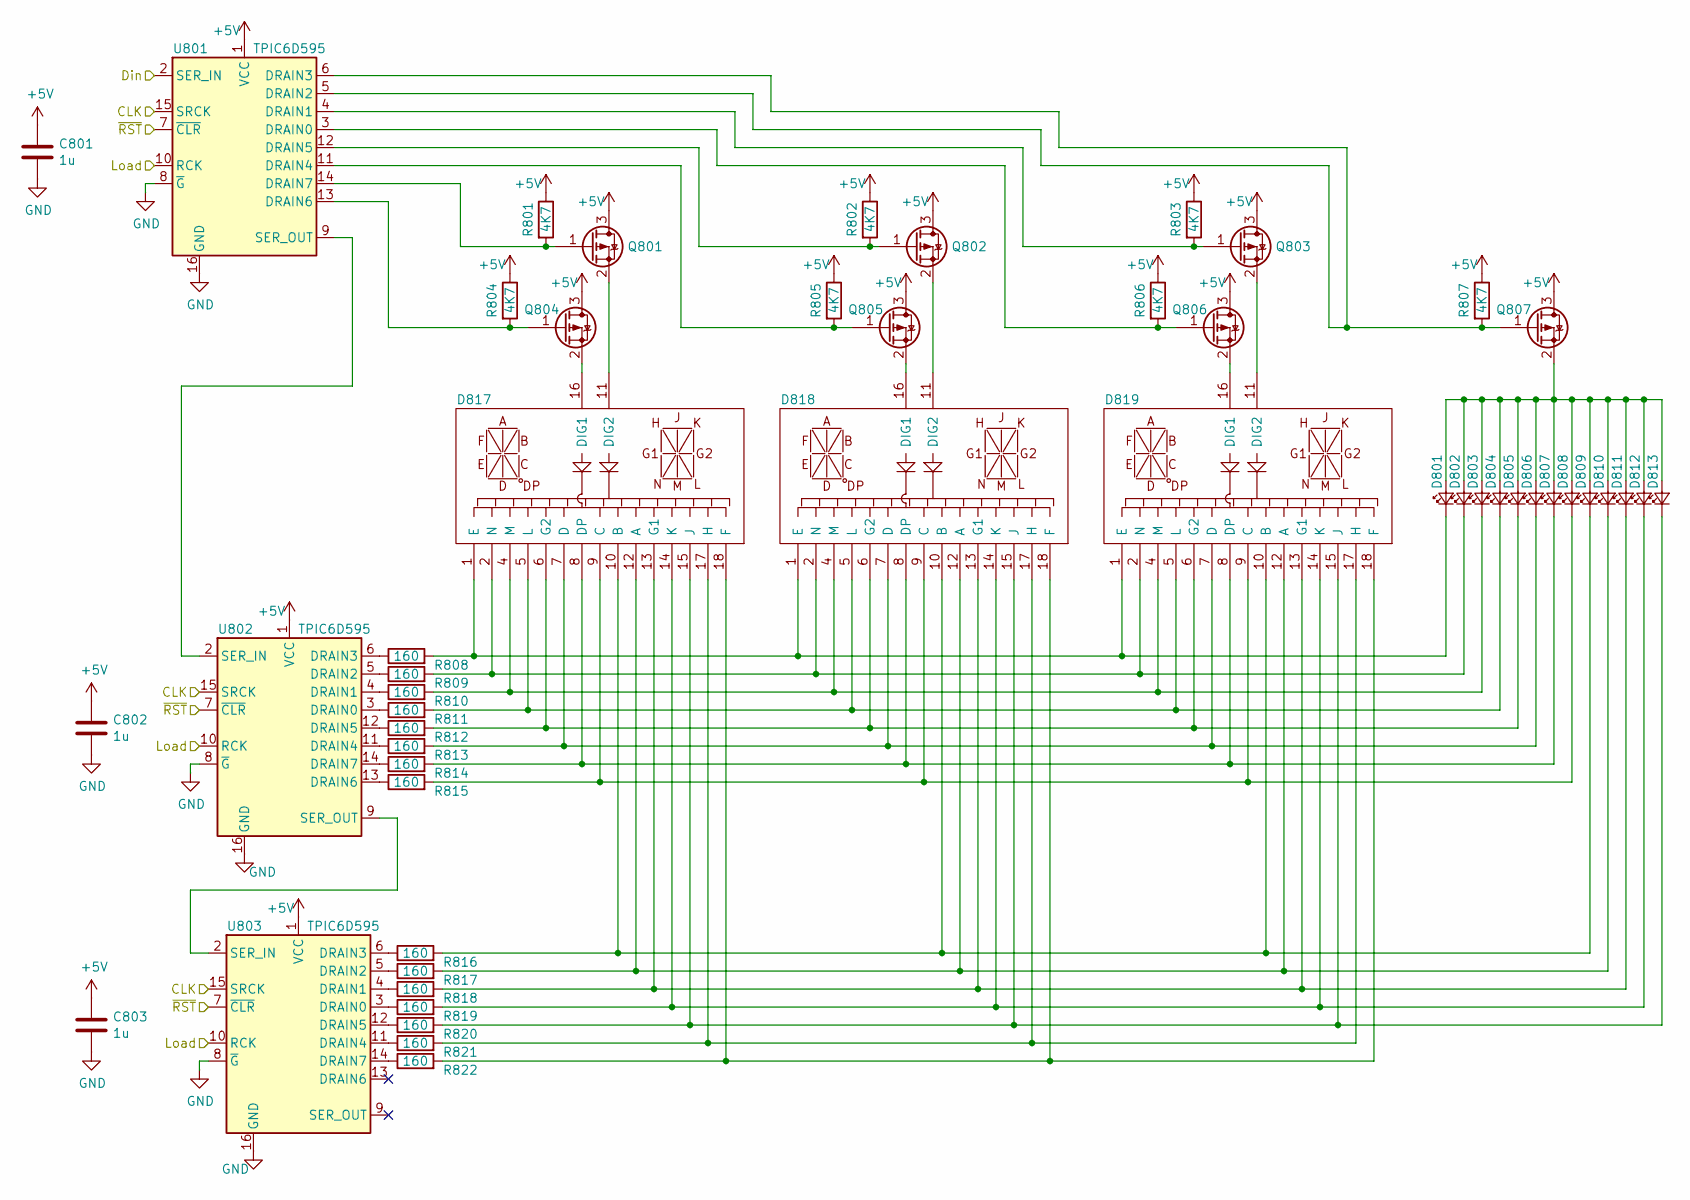
[picture p28: schematic sub_last_digit_row.sch]

Parts:
C801, C802, C803: 1u; C_0603_1608Metric
D801, D802, D803, D804, D805, D806, D807, D808, D809, D810, D811, D812, D813: LED_Small; LED_0805_2012Metric
D817, D818, D819: 14-segment
Q801, Q802, Q803, Q804, Q805, Q806, Q807: Q_PMOS_GSD; SOT-23
R801, R802, R803, R804, R805, R806, R807: 4K7; R_0603_1608Metric
R808, R809, R810, R811, R812, R813, R814, R815, R816, R817, R818, R819, R820, R821, R822: 160; R_1206_3216Metric
U801, U802, U803: TPIC6D595; SOIC-16_3.9x9.9mm_P1.27mm

Connections:
+5V: C801.1, C802.1, C803.1, Q801.3 (D), Q802.3 (D), Q803.3 (D), Q804.3 (D), Q805.3 (D), Q806.3 (D), Q807.3 (D), R801.1, R802.1, R803.1, R804.1, R805.1, R806.1, R807.1, U801.1 (VCC), U802.1 (VCC), U803.1 (VCC); also elsewhere on the board
/Display/CLK: U801.15 (SRCK), U802.15 (SRCK), U803.15 (SRCK); also elsewhere on the board
/Display/Last Digit Row/Din: U801.2 (SER_IN); also elsewhere on the board
/FPGA/LEDDisp_LOAD: U801.10 (RCK), U802.10 (RCK), U803.10 (RCK); also elsewhere on the board
/FPGA/LEDDisp_~CLR: U801.7 (~CLR), U802.7 (~CLR), U803.7 (~CLR); also elsewhere on the board
GND: C801.2, C802.2, C803.2, U801.8 (~G), U801.16 (GND), U802.8 (~G), U802.16 (GND), U803.8 (~G), U803.16 (GND); also elsewhere on the board
unnamed: D801.1 (K), D817.1 (E), D818.1 (E), D819.1 (E), R808.2
unnamed: D801.2 (A), D802.2 (A), D803.2 (A), D804.2 (A), D805.2 (A), D806.2 (A), D807.2 (A), D808.2 (A), D809.2 (A), D810.2 (A), D811.2 (A), D812.2 (A), D813.2 (A), Q807.2 (S)
unnamed: D802.1 (K), D817.2 (N), D818.2 (N), D819.2 (N), R809.2
unnamed: D803.1 (K), D817.4 (M), D818.4 (M), D819.4 (M), R810.2
unnamed: D804.1 (K), D817.5 (L), D818.5 (L), D819.5 (L), R811.2
unnamed: D805.1 (K), D817.6 (G2), D818.6 (G2), D819.6 (G2), R812.2
unnamed: D806.1 (K), D817.7 (D), D818.7 (D), D819.7 (D), R813.2
unnamed: D807.1 (K), D817.8 (DP), D818.8 (DP), D819.8 (DP), R814.2
unnamed: D808.1 (K), D817.9 (C), D818.9 (C), D819.9 (C), R815.2
unnamed: D809.1 (K), D817.10 (B), D818.10 (B), D819.10 (B), R816.2
unnamed: D810.1 (K), D817.12 (A), D818.12 (A), D819.12 (A), R817.2
unnamed: D811.1 (K), D817.13 (G1), D818.13 (G1), D819.13 (G1), R818.2
unnamed: D812.1 (K), D817.14 (K), D818.14 (K), D819.14 (K), R819.2
unnamed: D813.1 (K), D817.15 (J), D818.15 (J), D819.15 (J), R820.2
unnamed: D817.11 (DIG2), Q801.2 (S)
unnamed: D817.16 (DIG1), Q804.2 (S)
unnamed: D817.17 (H), D818.17 (H), D819.17 (H), R821.2
unnamed: D817.18 (F), D818.18 (F), D819.18 (F), R822.2
unnamed: D818.11 (DIG2), Q802.2 (S)
unnamed: D818.16 (DIG1), Q805.2 (S)
unnamed: D819.11 (DIG2), Q803.2 (S)
unnamed: D819.16 (DIG1), Q806.2 (S)
unnamed: Q801.1 (G), R801.2, U801.14 (DRAIN7)
unnamed: Q802.1 (G), R802.2, U801.12 (DRAIN5)
unnamed: Q803.1 (G), R803.2, U801.4 (DRAIN1)
unnamed: Q804.1 (G), R804.2, U801.13 (DRAIN6)
unnamed: Q805.1 (G), R805.2, U801.11 (DRAIN4)
unnamed: Q806.1 (G), R806.2, U801.3 (DRAIN0)
unnamed: Q807.1 (G), R807.2, U801.5 (DRAIN2), U801.6 (DRAIN3)
unnamed: R808.1, U802.6 (DRAIN3)
unnamed: R809.1, U802.5 (DRAIN2)
unnamed: R810.1, U802.4 (DRAIN1)
unnamed: R811.1, U802.3 (DRAIN0)
unnamed: R812.1, U802.12 (DRAIN5)
unnamed: R813.1, U802.11 (DRAIN4)
unnamed: R814.1, U802.14 (DRAIN7)
unnamed: R815.1, U802.13 (DRAIN6)
unnamed: R816.1, U803.6 (DRAIN3)
unnamed: R817.1, U803.5 (DRAIN2)
unnamed: R818.1, U803.4 (DRAIN1)
unnamed: R819.1, U803.3 (DRAIN0)
unnamed: R820.1, U803.12 (DRAIN5)
unnamed: R821.1, U803.11 (DRAIN4)
unnamed: R822.1, U803.14 (DRAIN7)
unnamed: U801.9 (SER_OUT), U802.2 (SER_IN)
unnamed: U802.9 (SER_OUT), U803.2 (SER_IN)
