ChrisPVille/quokka/board/quokka.kicad_pcb

## KiCad design board/quokka.kicad_pcb (continued)

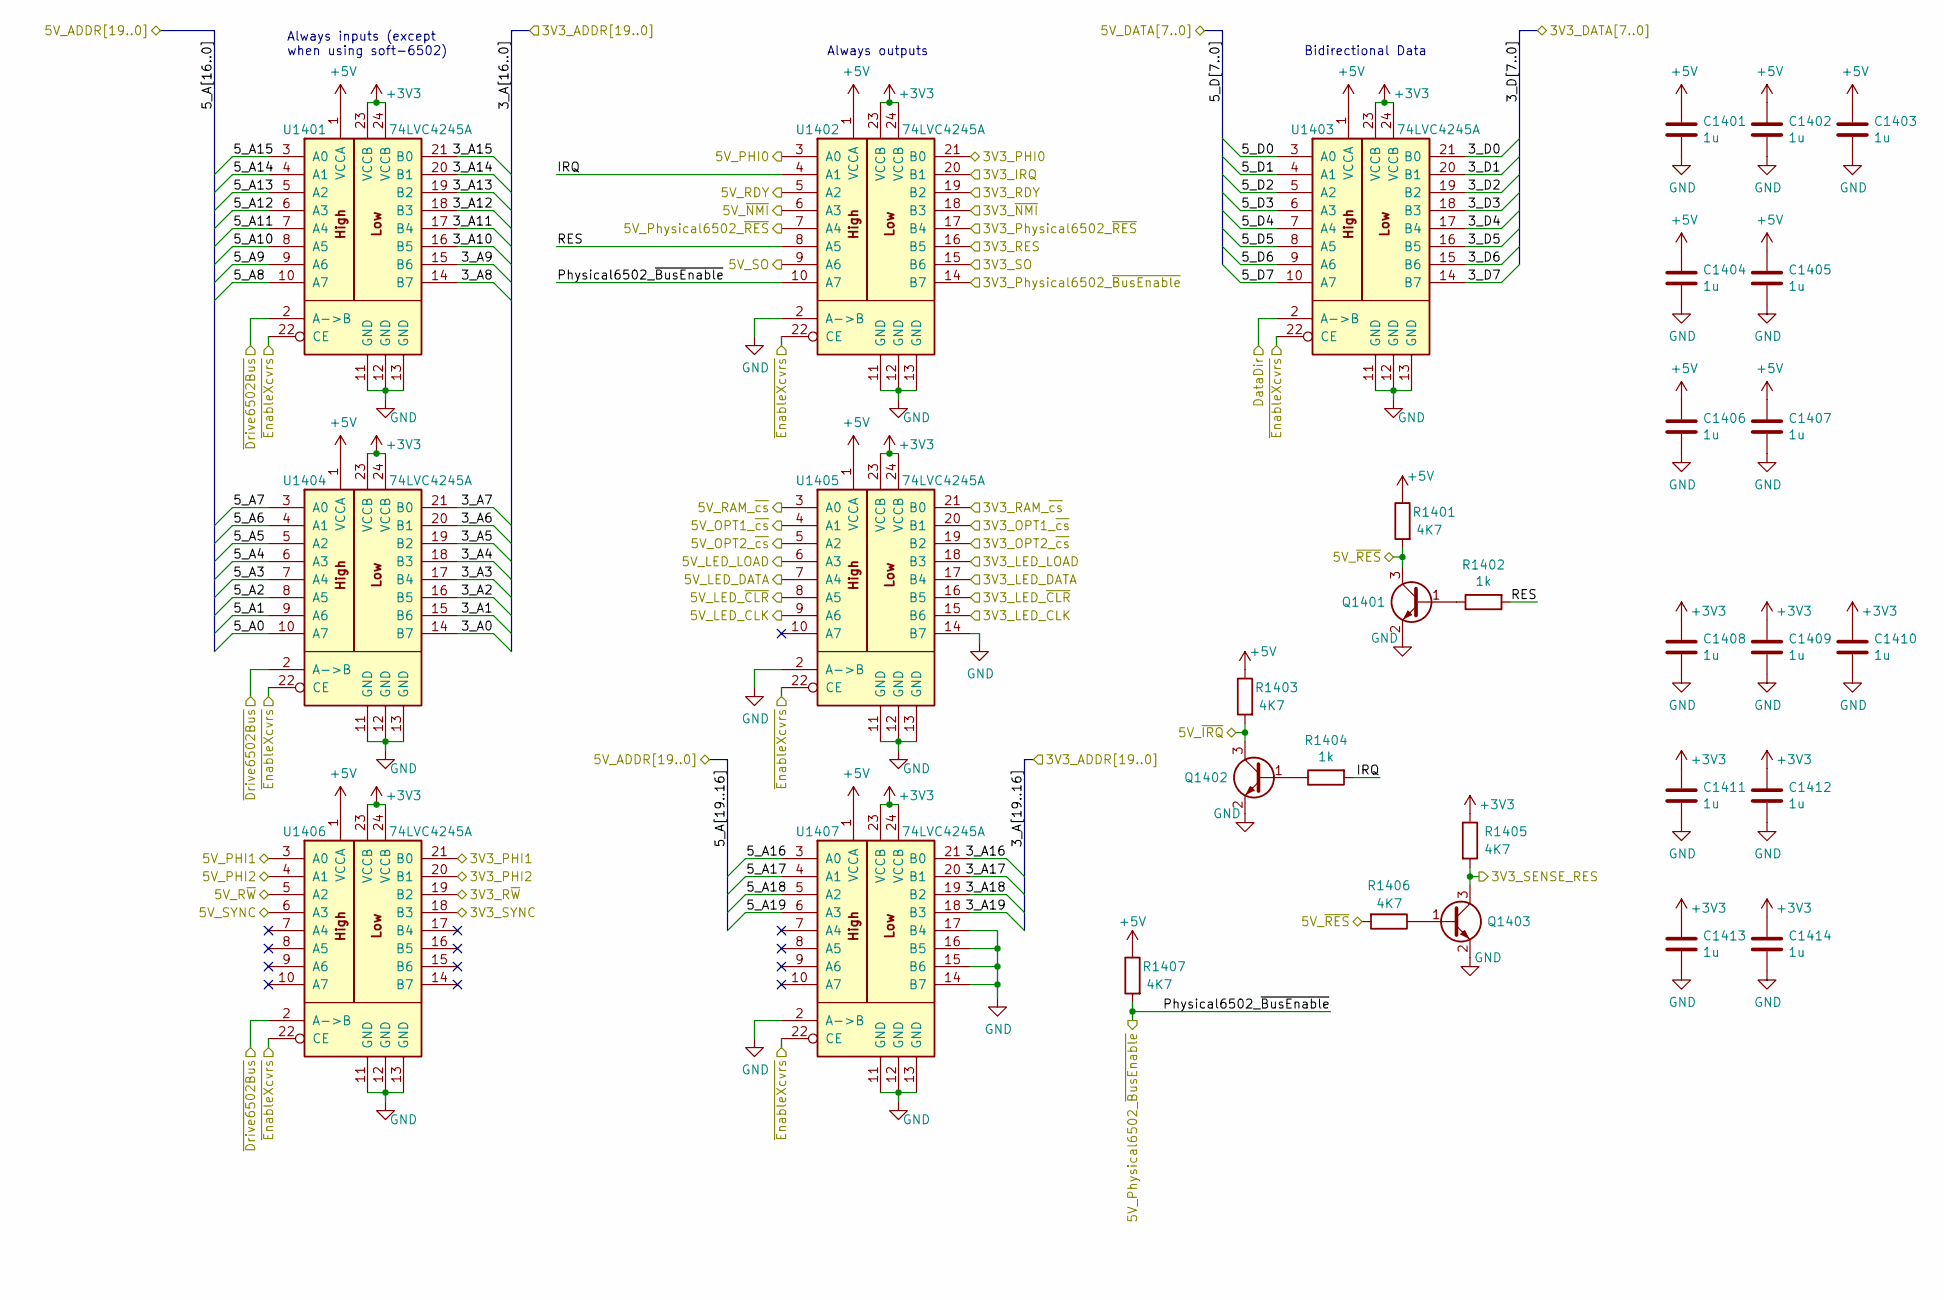
[picture p29: schematic sub_level_shift.sch]

Parts:
C1401, C1402, C1403, C1404, C1405, C1406, C1407, C1408, C1409, C1410, C1411, C1412, C1413, C1414: 1u; C_0603_1608Metric
Q1401, Q1402, Q1403: Q_NPN_BEC; SOT-23
R1401, R1403, R1405, R1406, R1407: 4K7; R_0603_1608Metric
R1402, R1404: 1k; R_0603_1608Metric
U1401, U1402, U1403, U1404, U1405, U1406, U1407: 74LVC4245A; TSSOP-24_4.4x7.8mm_P0.65mm

Connections:
+5V: C1401.1, C1402.1, C1403.1, C1404.1, C1405.1, C1406.1, C1407.1, R1401.1, R1403.1, R1407.1, U1401.1 (VCCA), U1402.1 (VCCA), U1403.1 (VCCA), U1404.1 (VCCA), U1405.1 (VCCA), U1406.1 (VCCA), U1407.1 (VCCA); also elsewhere on the board
/6502/6502_PHI0: U1402.3 (A0); also elsewhere on the board
/6502/6502_PHI1: U1406.3 (A0); also elsewhere on the board
/6502/6502_PHI2: U1406.4 (A1); also elsewhere on the board
/6502/6502_RDY: U1402.5 (A2); also elsewhere on the board
/6502/6502_R~W: U1406.5 (A2); also elsewhere on the board
/6502/6502_SO: U1402.9 (A6); also elsewhere on the board
/6502/6502_SYNC: U1406.6 (A3); also elsewhere on the board
/6502/6502_~IRQ: Q1402.3 (C), R1403.2; also elsewhere on the board
/6502/6502_~NMI: U1402.6 (A3); also elsewhere on the board
/6502/6502_~RES: U1402.7 (A4); also elsewhere on the board
/6502/B_D0: U1403.3 (A0); also elsewhere on the board
/6502/B_D1: U1403.4 (A1); also elsewhere on the board
/6502/B_D2: U1403.5 (A2); also elsewhere on the board
/6502/B_D3: U1403.6 (A3); also elsewhere on the board
/6502/B_D4: U1403.7 (A4); also elsewhere on the board
/6502/B_D5: U1403.8 (A5); also elsewhere on the board
/6502/B_D6: U1403.9 (A6); also elsewhere on the board
/6502/B_D7: U1403.10 (A7); also elsewhere on the board
/Bus Expansion/6502_OPT1_~cs: U1405.4 (A1); also elsewhere on the board
/Bus Expansion/6502_OPT2_~cs: U1405.5 (A2); also elsewhere on the board
/Bus Expansion/6502_~RES: Q1401.3 (C), R1401.2, R1406.2; also elsewhere on the board
/Bus Expansion/A0: U1404.10 (A7); also elsewhere on the board
/Bus Expansion/A1: U1404.9 (A6); also elsewhere on the board
/Bus Expansion/A2: U1404.8 (A5); also elsewhere on the board
/Bus Expansion/A3: U1404.7 (A4); also elsewhere on the board
/Bus Expansion/A4: U1404.6 (A3); also elsewhere on the board
/Bus Expansion/A5: U1404.5 (A2); also elsewhere on the board
/Bus Expansion/A6: U1404.4 (A1); also elsewhere on the board
/Bus Expansion/A7: U1404.3 (A0); also elsewhere on the board
/Bus Expansion/A8: U1401.10 (A7); also elsewhere on the board
/Bus Expansion/A9: U1401.9 (A6); also elsewhere on the board
/Bus Expansion/A10: U1401.8 (A5); also elsewhere on the board
/Bus Expansion/A11: U1401.7 (A4); also elsewhere on the board
/Bus Expansion/A12: U1401.6 (A3); also elsewhere on the board
/Bus Expansion/A13: U1401.5 (A2); also elsewhere on the board
/Bus Expansion/A14: U1401.4 (A1); also elsewhere on the board
/Bus Expansion/A15: U1401.3 (A0); also elsewhere on the board
/Bus Expansion/A16: U1407.3 (A0); also elsewhere on the board
/Bus Expansion/A17: U1407.4 (A1); also elsewhere on the board
/Bus Expansion/A18: U1407.5 (A2); also elsewhere on the board
/Bus Expansion/A19: U1407.6 (A3); also elsewhere on the board
/Display/CLK: U1405.9 (A6); also elsewhere on the board
/Display/Din: U1405.7 (A4); also elsewhere on the board
/FPGA/6502_RAM_~cs: U1405.3 (A0); also elsewhere on the board
/FPGA/A0: U1404.14 (B7); also elsewhere on the board
/FPGA/A1: U1404.15 (B6); also elsewhere on the board
/FPGA/A2: U1404.16 (B5); also elsewhere on the board
/FPGA/A3: U1404.17 (B4); also elsewhere on the board
/FPGA/A4: U1404.18 (B3); also elsewhere on the board
/FPGA/A5: U1404.19 (B2); also elsewhere on the board
/FPGA/A6: U1404.20 (B1); also elsewhere on the board
/FPGA/A7: U1404.21 (B0); also elsewhere on the board
/FPGA/A8: U1401.14 (B7); also elsewhere on the board
/FPGA/A9: U1401.15 (B6); also elsewhere on the board
/FPGA/A10: U1401.16 (B5); also elsewhere on the board
/FPGA/A11: U1401.17 (B4); also elsewhere on the board
/FPGA/A12: U1401.18 (B3); also elsewhere on the board
/FPGA/A13: U1401.19 (B2); also elsewhere on the board
/FPGA/A14: U1401.20 (B1); also elsewhere on the board
/FPGA/A15: U1401.21 (B0); also elsewhere on the board
/FPGA/A16: U1407.21 (B0); also elsewhere on the board
/FPGA/A17: U1407.20 (B1); also elsewhere on the board
/FPGA/A18: U1407.19 (B2); also elsewhere on the board
/FPGA/A19: U1407.18 (B3); also elsewhere on the board
/FPGA/D0: U1403.21 (B0); also elsewhere on the board
/FPGA/D1: U1403.20 (B1); also elsewhere on the board
/FPGA/D2: U1403.19 (B2); also elsewhere on the board
/FPGA/D3: U1403.18 (B3); also elsewhere on the board
/FPGA/D4: U1403.17 (B4); also elsewhere on the board
/FPGA/D5: U1403.16 (B5); also elsewhere on the board
/FPGA/D6: U1403.15 (B6); also elsewhere on the board
/FPGA/D7: U1403.14 (B7); also elsewhere on the board
/FPGA/DataDir: U1403.2 (A->B); also elsewhere on the board
/FPGA/IRQ: U1402.20 (B1); also elsewhere on the board
/FPGA/LEDDisp_LOAD: U1405.6 (A3); also elsewhere on the board
/FPGA/LEDDisp_~CLR: U1405.8 (A5); also elsewhere on the board
/FPGA/LED_CLK: U1405.15 (B6); also elsewhere on the board
/FPGA/LED_DATA: U1405.17 (B4); also elsewhere on the board
/FPGA/LED_LOAD: U1405.18 (B3); also elsewhere on the board
/FPGA/LED_~CLR: U1405.16 (B5); also elsewhere on the board
/FPGA/Level Converters/IRQ: R1404.2, U1402.4 (A1)
/FPGA/Level Converters/RES: R1402.2, U1402.8 (A5)
/FPGA/OPT1_~cs: U1405.20 (B1); also elsewhere on the board
/FPGA/OPT2_~cs: U1405.19 (B2); also elsewhere on the board
/FPGA/PHI0: U1402.21 (B0); also elsewhere on the board
/FPGA/PHI1: U1406.21 (B0); also elsewhere on the board
/FPGA/PHI2: U1406.20 (B1); also elsewhere on the board
/FPGA/Phys6502_~BusEnable: U1402.14 (B7); also elsewhere on the board
/FPGA/Phys6502_~RES: U1402.17 (B4); also elsewhere on the board
/FPGA/Physical6502_~BusEnable: R1407.2, U1402.10 (A7); also elsewhere on the board
/FPGA/RAM_~cs: U1405.21 (B0); also elsewhere on the board
/FPGA/RDY: U1402.19 (B2); also elsewhere on the board
/FPGA/RES: U1402.16 (B5); also elsewhere on the board
/FPGA/R~W: U1406.19 (B2); also elsewhere on the board
/FPGA/SENSE_RES: Q1403.3 (C), R1405.2; also elsewhere on the board
/FPGA/SO: U1402.15 (B6); also elsewhere on the board
/FPGA/SYNC: U1406.18 (B3); also elsewhere on the board
/FPGA/~Drive6502Bus: U1401.2 (A->B), U1404.2 (A->B), U1406.2 (A->B); also elsewhere on the board
/FPGA/~EnableXcvers: U1401.22 (CE), U1402.22 (CE), U1403.22 (CE), U1404.22 (CE), U1405.22 (CE), U1406.22 (CE), U1407.22 (CE); also elsewhere on the board
/FPGA/~NMI: U1402.18 (B3); also elsewhere on the board
GND: C1401.2, C1402.2, C1403.2, C1404.2, C1405.2, C1406.2, C1407.2, C1408.2, C1409.2, C1410.2, C1411.2, C1412.2, C1413.2, C1414.2, Q1401.2 (E), Q1402.2 (E), Q1403.2 (E), U1401.11 (GND), U1401.12 (GND), U1401.13 (GND), U1402.2 (A->B), U1402.11 (GND), U1402.12 (GND), U1402.13 (GND), U1403.11 (GND), U1403.12 (GND), U1403.13 (GND), U1404.11 (GND), U1404.12 (GND), U1404.13 (GND), U1405.2 (A->B), U1405.11 (GND), U1405.12 (GND), U1405.13 (GND), U1405.14 (B7), U1406.11 (GND), U1406.12 (GND), U1406.13 (GND), U1407.2 (A->B), U1407.11 (GND), U1407.12 (GND), U1407.13 (GND), U1407.14 (B7), U1407.15 (B6), U1407.16 (B5), U1407.17 (B4); also elsewhere on the board
unnamed: Q1401.1 (B), R1402.1
unnamed: Q1402.1 (B), R1404.1
unnamed: Q1403.1 (B), R1406.1

Notes on the sheet:
Always inputs (except when using soft-6502)
Always outputs
Bidirectional Data

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
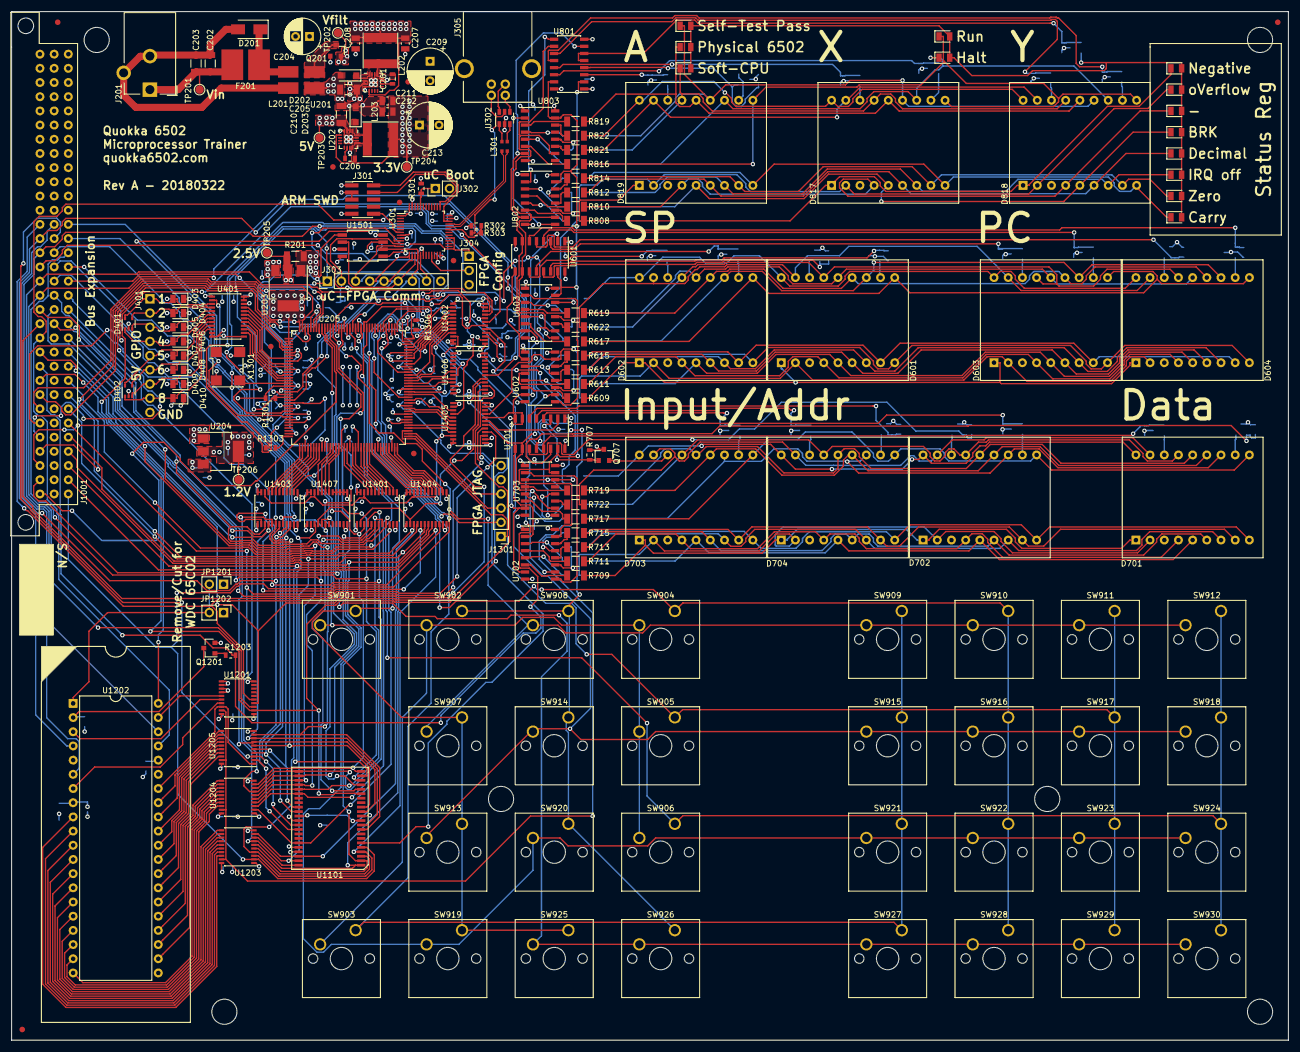
[picture p30: board quokka.kicad_pcb from above]

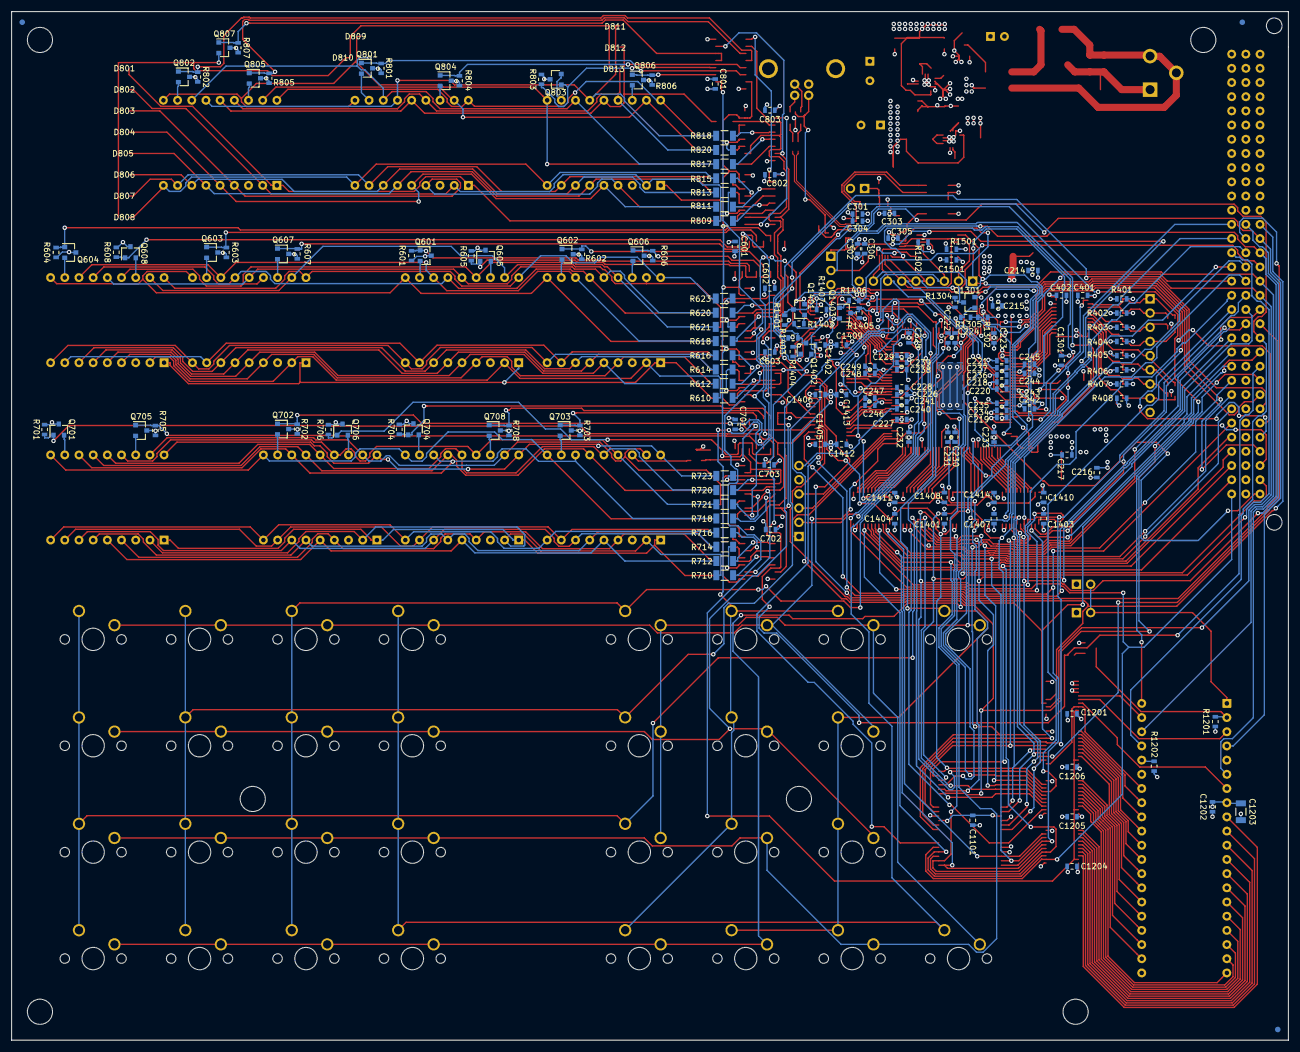
[picture p31: board quokka.kicad_pcb from below]

Board: 4 copper layers, 228.6 x 184.1 mm, 355 parts (169 on the bottom side), 371 nets.
