ChrisPVille/quokka/microcontroller/quokka.ioc

Mcu.UserName=STM32F072CBTx
PA0.Signal=GPIO_Input
PA1.Signal=GPIO_Input
PA11.Signal=USB_DM
PA12.Signal=USB_DP
PA13.Signal=SYS_SWDIO
PA14.Signal=SYS_SWCLK
PA2.Signal=GPIO_Output
PA3.Signal=GPIO_Input
PA4.Signal=SPI1_NSS
PA5.Signal=SPI1_SCK
PA6.Signal=SPI1_MISO
PA7.Signal=SPI1_MOSI
PB0.Signal=GPIO_Output
PB10.Signal=SPI2_SCK
PB15.Signal=SPI2_MOSI
