ChrisPVille/quokka/(commit log)

2018-03-03 Added skeleton schematic
    [quokka.kicad_pcb, quokka.sch, sub_6502.sch, sub_display.sch, sub_fpga.sch, sub_gpio.sch, sub_kbd.sch, sub_micro.sch]
2018-03-04 Added microcontroller STM32CubeMX definition
2018-03-04 Moved to KiCad 5
    [quokka.sch, sub_display.sch, sub_fpga.sch, sub_gpio.sch, sub_kbd.sch, sub_keyboard.sch, sub_micro.sch, sub_power.sch]
2018-03-06 Switched to crystal-less part
2018-03-06 Added some buttons
    [quokka.sch, sub_6502.sch, sub_display.sch, sub_fpga.sch, sub_gpio.sch, sub_keyboard.sch, sub_micro.sch, sub_power.sch]
2018-03-07 Updated keyboard
    [quokka.sch, sub_fpga.sch, sub_keyboard.sch]
2018-03-09 Got that irritating FPGA footprint done
2018-03-10 More progress on the schematic. 6502 Done.
    [expansion.sch, quokka.sch, ram.sch, sub_6502.sch, sub_display.sch, sub_fpga.sch, sub_gpio.sch, sub_keyboard.sch]
2018-03-10 More schematic progress
    [quokka.sch, sub_6502.sch, sub_expansion.sch, sub_power.sch, sub_ram.sch]
2018-03-12 Level converters complete, display almost done
    [quokka.sch, sub_6502.sch, sub_digit_row.sch, sub_display.sch, sub_expansion.sch, sub_fpga.sch, sub_gpio.sch, sub_keyboard.sch]
2018-03-15 Bus signal connectivity rebuilt
    [quokka.sch, sub_6502.sch, sub_digit_row.sch, sub_expansion.sch, sub_fpga.sch, sub_gpio.sch, sub_keyboard.sch, sub_last_digit_row.sch]
2018-03-16 gpio done
    [quokka.sch, sub_6502.sch, sub_fpga.sch, sub_gpio.sch, sub_level_shift.sch]
2018-03-17 RAM Done
    [sub_expansion.sch, sub_ram.sch]
2018-03-17 made some changes based on projected power budget
    [sub_digit_row.sch, sub_gpio.sch, sub_last_digit_row.sch, sub_level_shift.sch, sub_micro.sch, sub_ram.sch]
2018-03-17 Schematics mostly complete
    [quokka.sch, sub_6502.sch, sub_digit_row.sch, sub_expansion.sch, sub_fpga.sch, sub_gpio.sch, sub_keyboard.sch, sub_last_digit_row.sch]
2018-03-18 Started picking footprints. Merged many components.
    [quokka.sch, sub_6502.sch, sub_digit_row.sch, sub_display.sch, sub_expansion.sch, sub_fpga.sch, sub_gpio.sch, sub_keyboard.sch]
2018-03-18 More footprints done. Went with simpler test-pads.
    [quokka.sch, sub_6502.sch, sub_digit_row.sch, sub_display.sch, sub_expansion.sch, sub_fpga.sch, sub_gpio.sch, sub_keyboard.sch]
2018-03-18 Fixed swapped pin and some labels
    [sub_digit_row.sch, sub_fpga.sch, sub_level_shift.sch]
2018-03-18 Added SPI Flash for uC
    [flash.sch, quokka.sch, sub_6502.sch, sub_digit_row.sch, sub_display.sch, sub_expansion.sch, sub_fpga.sch, sub_gpio.sch]
2018-03-18 Most footprints associated
    [flash.sch, sub_6502.sch, sub_digit_row.sch, sub_fpga.sch, sub_gpio.sch, sub_last_digit_row.sch, sub_level_shift.sch, sub_micro.sch]
2018-03-18 Almost all footprints done
    [sub_digit_row.sch, sub_last_digit_row.sch, sub_level_shift.sch, sub_ram.sch]
2018-03-19 All footprints done
    [sub_expansion.sch, sub_micro.sch, sub_power.sch]
2018-03-19 Started on board
    [quokka.kicad_pcb, sub_digit_row.sch, sub_level_shift.sch, sub_micro.sch]
2018-03-21 more progress on board
    [quokka.kicad_pcb]
2018-03-21 Power supply routed
    [quokka.kicad_pcb, quokka.sch, sub_6502.sch, sub_digit_row.sch, sub_expansion.sch, sub_fpga.sch, sub_keyboard.sch, sub_last_digit_row.sch]
2018-03-22 Most critical nets routed
    [quokka.kicad_pcb, sub_expansion.sch]
2018-03-22 Ready for autorouting
    [quokka.kicad_pcb]
2018-03-22 All nets routed
    [quokka.kicad_pcb]
2018-03-22 Renamed SPI flash schematic file
    [quokka.sch, sub_flash.sch]
2018-03-22 Cleaned up DRC violations
    [quokka.kicad_pcb]
2018-03-22 Cleaned up silkscreen designators
    [quokka.kicad_pcb, quokka.sch, sub_expansion.sch]
2018-03-23 Added fids, made PDF
    [quokka.kicad_pcb, quokka.sch]
2018-03-23 Resolved accidental DRC error
    [quokka.kicad_pcb]
2018-03-23 Generated RevA gerbers
    [quokka-B.Cu.gbl, quokka-B.Mask.gbs, quokka-B.Paste.gbp, quokka-B.SilkS.gbo, quokka-Edge.Cuts.gm1, quokka-F.Cu.gtl, quokka-F.Mask.gts, quokka-F.Paste.gtp]
2018-04-09 Planning some changes for revB
    [quokka.kicad_pcb]
2018-04-15 Added working display driver
2018-04-22 Added keyboard driver to repo, activated pulldowns on matrix input lines to fix ghost presses caused by capacitive coupling
    [keyboard.v, keyboard_tb.v, quokka-RevA.ucf, top.v]
2018-05-05 Added cc65 for assembly monitor program
2018-05-05 Added discrete LED mapping and abstracted some magic numbers
2018-05-05 Added ability to display some data from the 6502 on interrupt
2018-05-05 Mapped SR to leds
2018-05-05 Reduced discrete LED duty cycle as they were significantly brighter than the 14-segs
2018-05-05 Reworked run/halt arch to allow eventual single stepping
    [cpu_control.v, top.v]
2018-05-06 Added step through reset ability
    [cpu_control.v, edge_detect.v, top.v]
2018-05-06 Fixed some implicit wires
    [top.v]
2018-05-06 Again, picking the correct reg is helpful
    [cpu_control.v]
2018-05-06 Switched to positive acknowledgment system
2018-05-06 Well, BIT didn't work the way I thought it did
    [cpu_control.v, top.v]
2023-07-03 Added board image
